tbellenger/button-lamp/light mount/README.md

# Light mount

Things that hold a light on the lamp's top deck. The box itself is in [`../container/`](../container/).

| Path | What |
|---|---|
| [original-cage/](original-cage/) | The older one-piece 13 mm tube cage (one print) |
| [spiral_tube_mount/](spiral_tube_mount/) | Stackable cross mount for the silicone tube |
| [four_tower_spiral/](four_tower_spiral/) | Four side-printed towers, a ring, and a cap. Identical numbered slots, glued after a dry fit. A separate option, not a replacement |
| [matrix_16x16_mount/](matrix_16x16_mount/) | 16×16 matrix on the same bolt pattern |
| [matrix_16x16_arduino_back/](matrix_16x16_arduino_back/) | That matrix with a rear Arduino bay |
