tbellenger/button-lamp/container/README.md

# Container

The lamp box: plywood and sheet metal. Light mounts that bolt to the top deck live in [`../light mount/`](../light%20mount/).

| Path | What |
|---|---|
| [plywood/](plywood/) | Hand-cut ply box, plus the generator for the original cage and the top backer plate |
| [plywood/fingerjoint/](plywood/fingerjoint/) | Laser-cut finger-joint birch |
| [sheetmetal/](sheetmetal/) | Bent aluminium or steel hood |
