tbellenger/button-lamp/container/plywood/templates/ply3mm/templates_letter_tiled_ply3mm.pdf

# Spiral Lamp plywood base - full-size templates (3mm ply)

Print at 100% / "Actual size" (turn OFF "fit to page"). Check the 100 mm and 4 in bars on every page.
Each piece is tiled across Letter pages with a 10 mm overlap. Line up the grey crosshairs, tape, then spray-glue or tape the template onto the plywood and cut on the black lines. Blue dashed lines are layout marks. HAND CUTTING (scroll saw / jigsaw): saw on the waste side of each black line and sand to it. Red crosshairs = drill holes (size printed). Hatched WASTE areas = inside cutouts: drill the 8 mm (5/16") red-circle entry holes, thread the scroll-saw blade (or drop the jigsaw blade in) and saw out. Slots: drill both ends, saw/file between. Page labels: PIECE row r / col c (row 1 = bottom of the piece).

## side: 250.0 x 120.0 mm, make 2 back: 204.0 x 117.0 mm, make 1 top: 122.0 x 204.0 mm, make 1 slope: 155.6 x 204.0 mm, make 1 front: 204.0 x 25.5 mm, make 1 bottom: 243.0 x 203.0 mm, make 1

100 mm
4 in

Print at 100%. Both bars must measure true.

## SIDE (make 2) row 1/1 col 1/2

Overlap 10 mm with neighbouring tiles. Align grey crosshairs (50 mm grid).

## SIDE (make 2) row 1/1 col 2/2

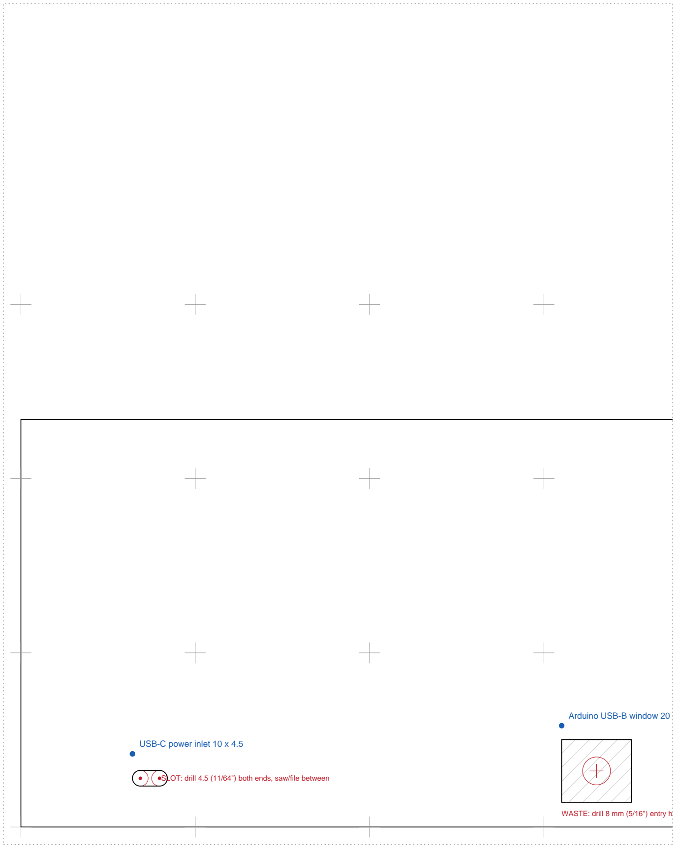
[picture p21: figure]
USB-C power inlet 10 x 4.5

SLOT: drill 4.5 (11/64") both ends, saw/file between

WASTE: drill 8 mm (5/16") entry hole, saw out

Arduino USB-B window 20 x 18 (hold the Uno up to check)

## BACK (make 1) row 1/1 col 1/2

WASTE: drill 8 mm (5/16") entry hole, saw out

Arduino USB-B window 20 x 18 (hold the Uno up to check)

## BACK (make 1) row 1/1 col 2/2

## TOP (make 1) row 1/1 col 1/1

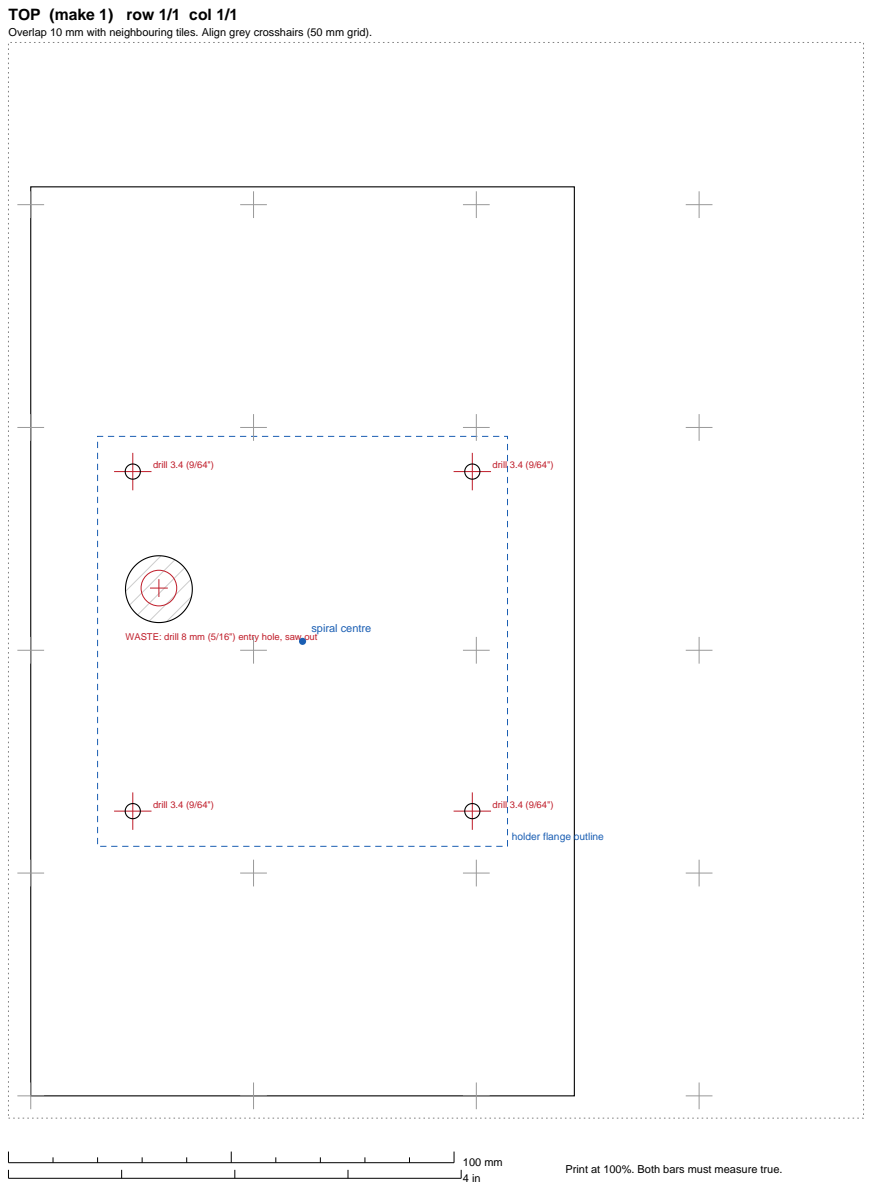
[picture p22: page 6]
drill 3.4 (9/64"); spiral centre

WASTE: drill 8 mm (5/16") entry hole, saw out

holder flange outline

## SLOPE (make 1) row 1/1 col 1/1

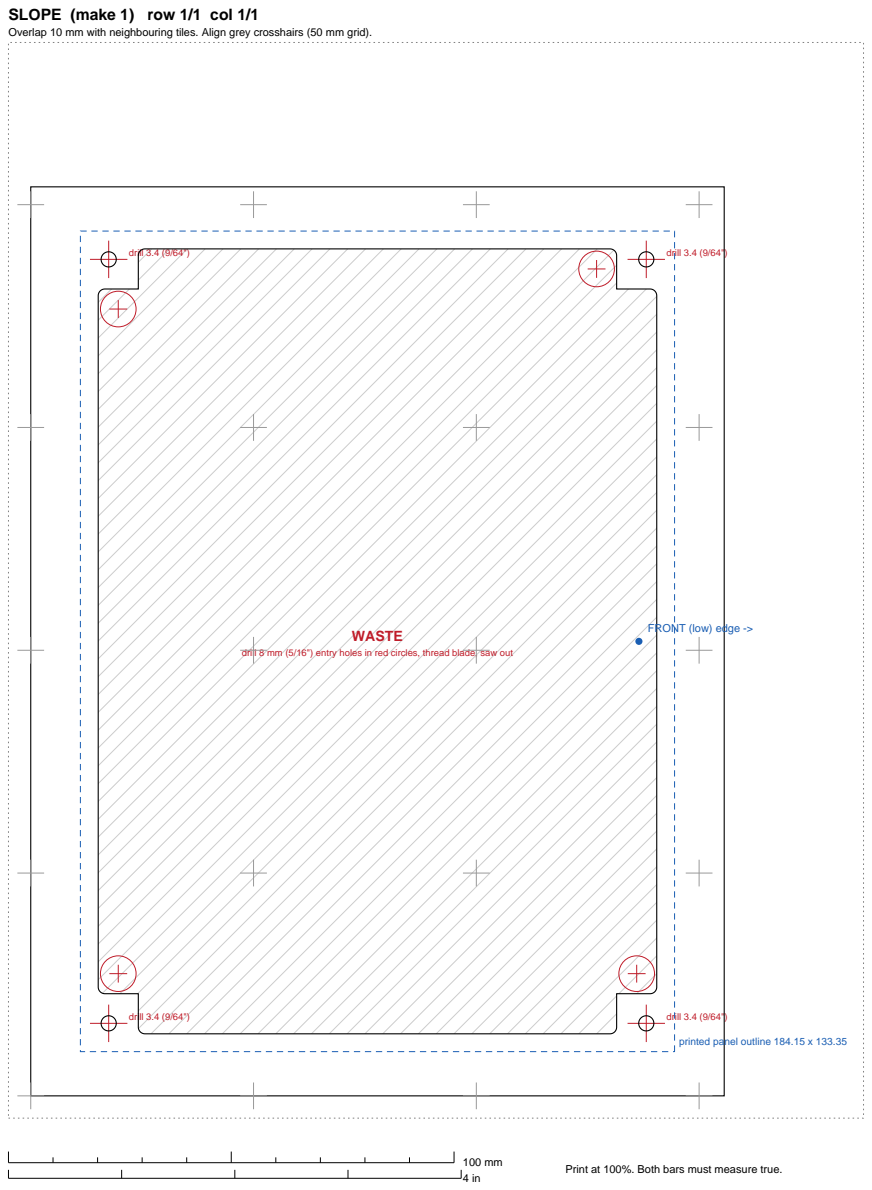
[picture p23: page 7]
WASTE; drill 3.4 (9/64")

FRONT (low) edge ->

drill 8 mm (5/16") entry holes in red circles, thread blade, saw out

printed panel outline 184.15 x 133.35

## FRONT (make 1) row 1/1 col 1/2

## FRONT (make 1) row 1/1 col 2/2

## BOTTOM (make 1) row 1/1 col 1/2

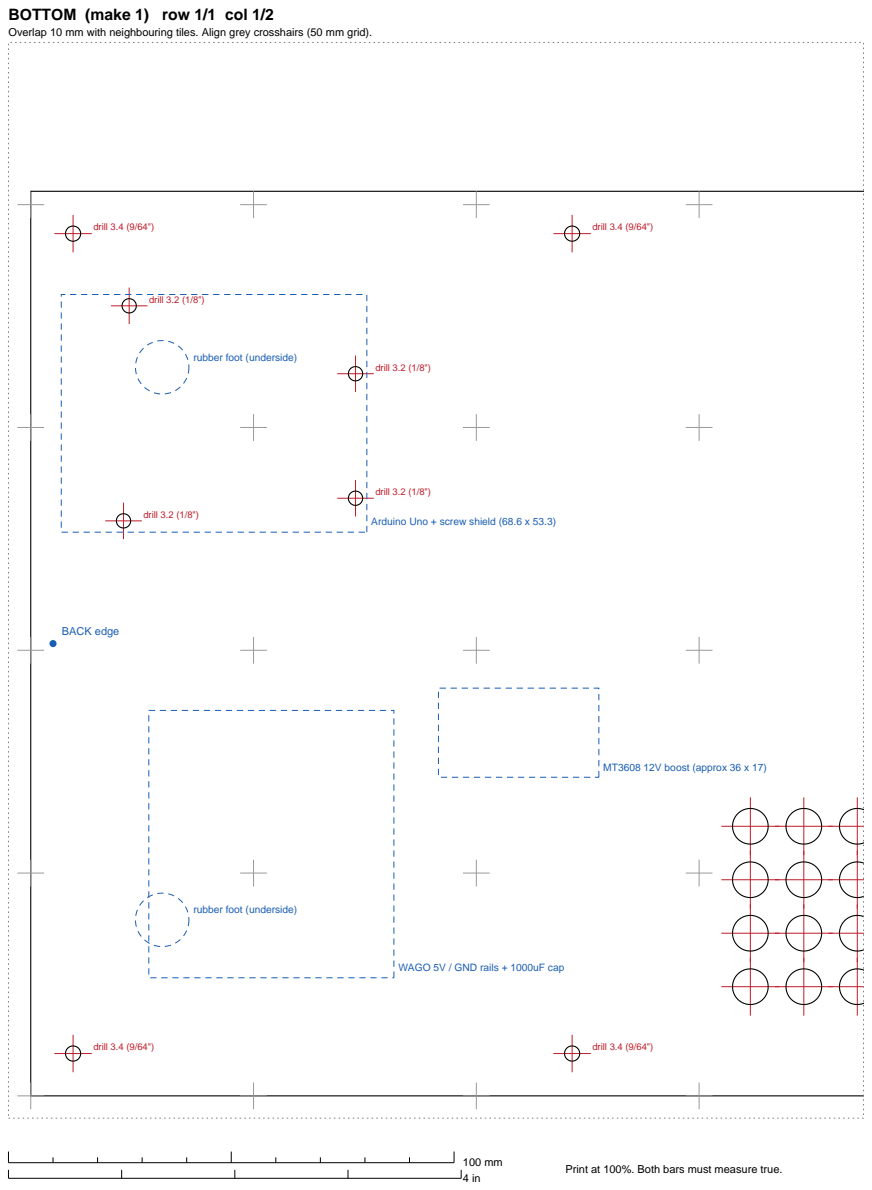
[picture p24: page 10]
drill 3.4 (9/64"); drill 3.2 (1/8"); MT3608 12V boost (approx 36 x 17); BACK edge

rubber foot (underside)

Arduino Uno + screw shield (68.6 x 53.3)

WAGO 5V / GND rails + 1000uF cap

## BOTTOM (make 1) row 1/1 col 2/2

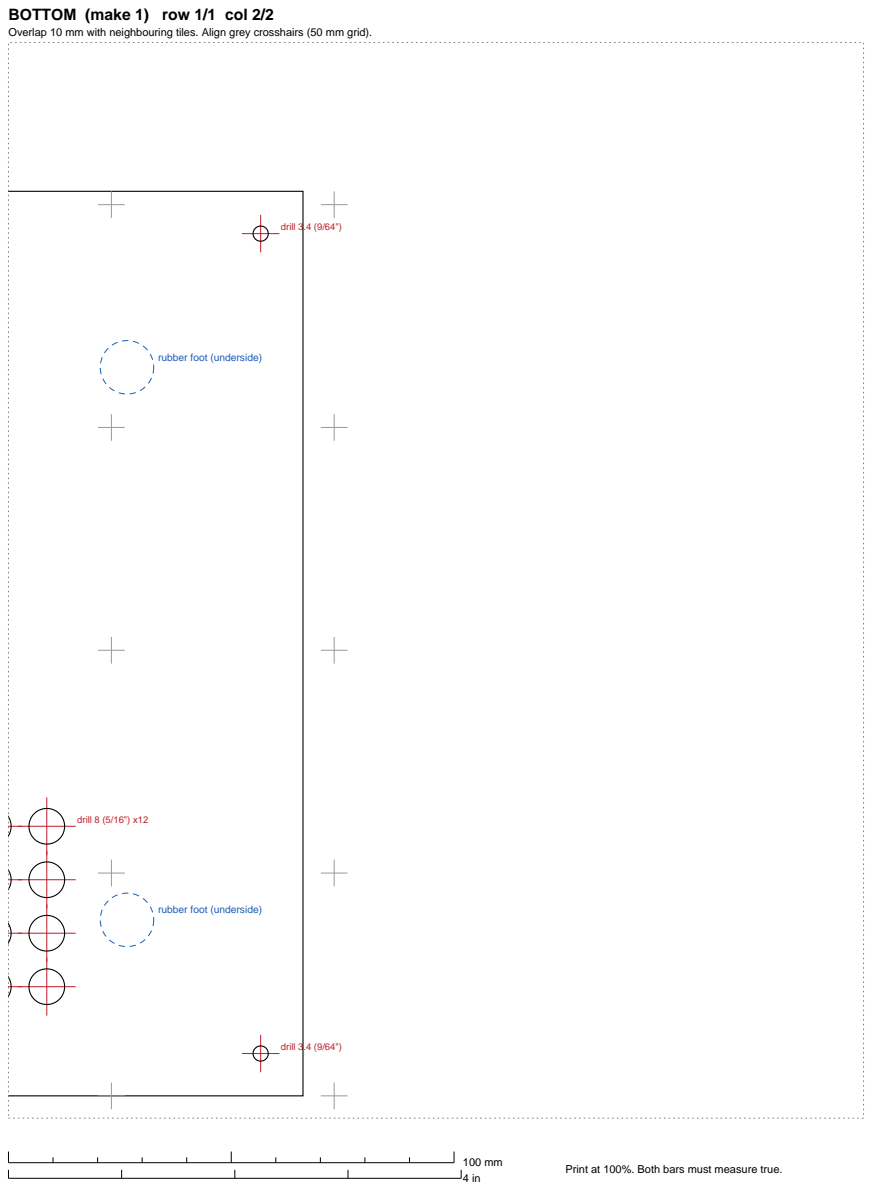
[picture p25: page 11]
drill 8 (5/16") x12; drill 3.4 (9/64"); MT3608 12V boost (approx 36 x 17)

rubber foot (underside)
