tbellenger/button-lamp/container/plywood/fingerjoint/render/exploded.png

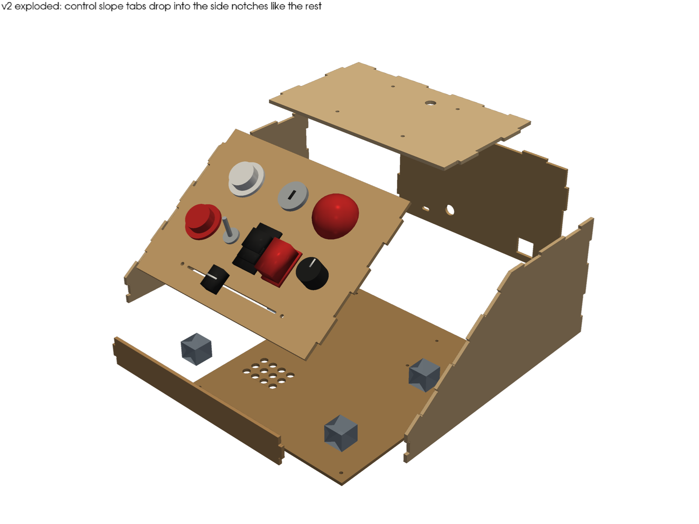
container/plywood/fingerjoint/render/exploded.png
