tbellenger/button-lamp/container/plywood/fingerjoint/render/panel_closeup.png

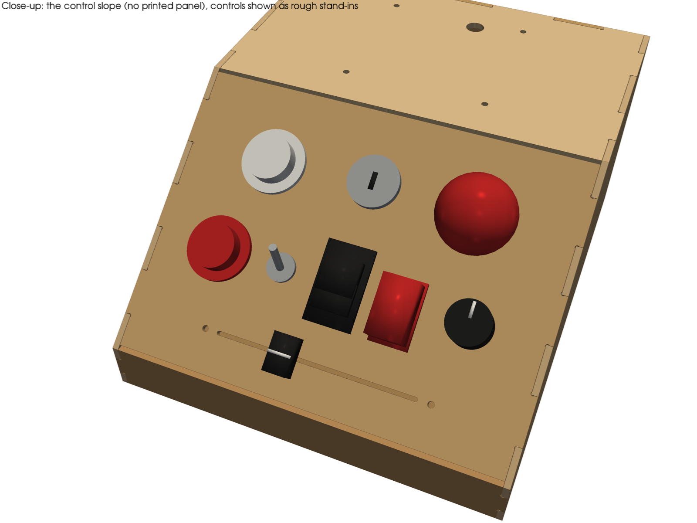
container/plywood/fingerjoint/render/panel_closeup.png
