tbellenger/button-lamp/container/plywood/render/inside_cutaway.png

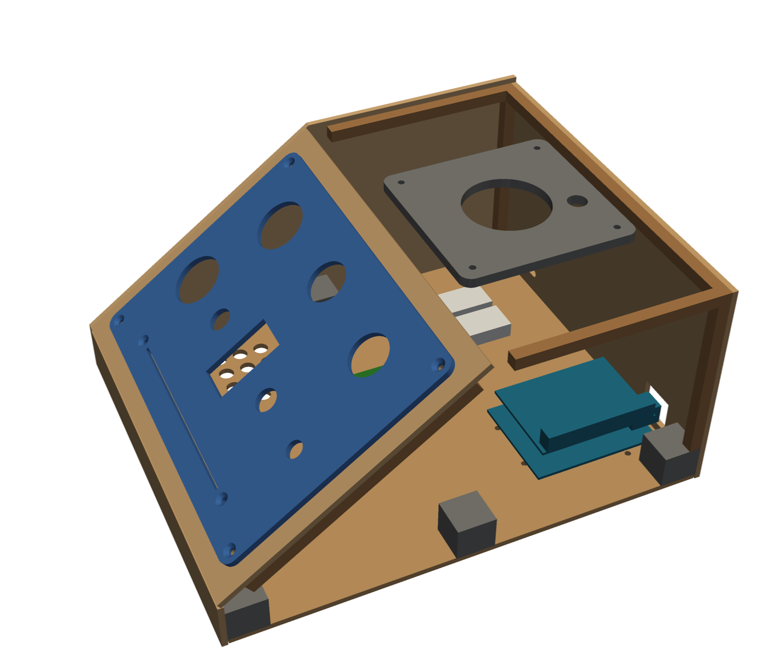
container/plywood/render/inside_cutaway.png
