tbellenger/button-lamp/container/plywood/render/original_Enclosure.png

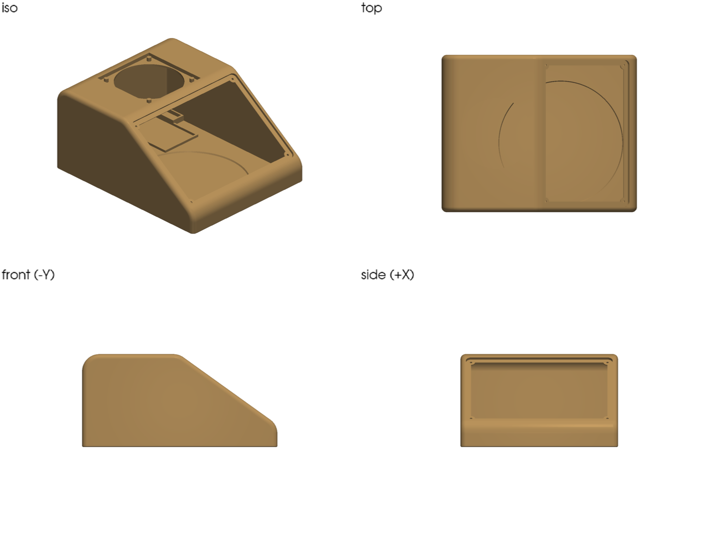
container/plywood/render/original_Enclosure.png
