tbellenger/button-lamp/container/plywood/render/original_Spiral_End_Cap.png

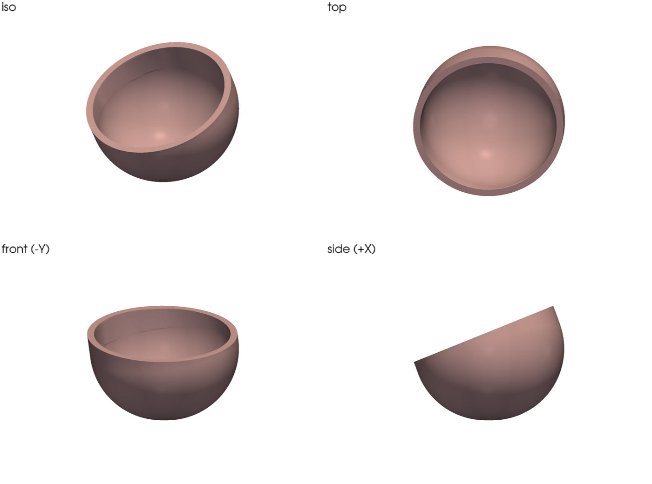
container/plywood/render/original_Spiral_End_Cap.png
