tbellenger/button-lamp/container/plywood/render/original_Spiral_with_base.png

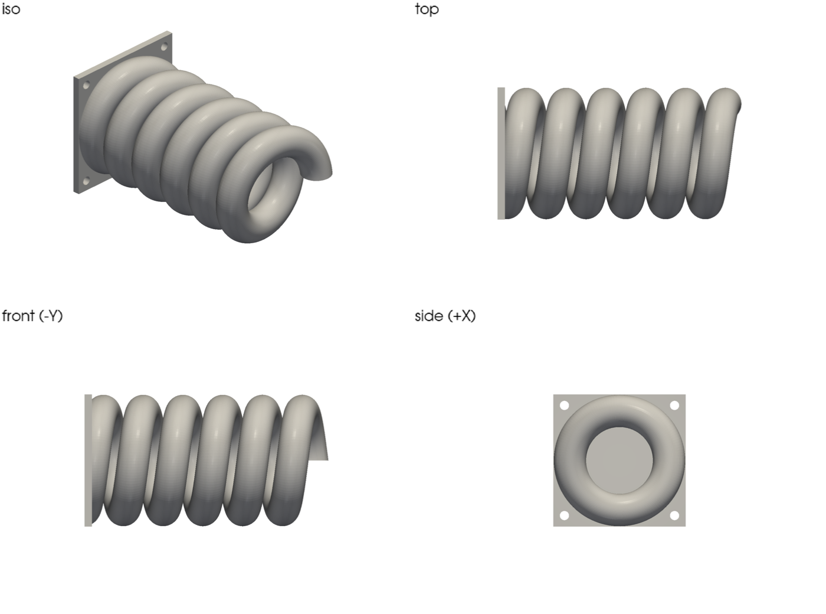
container/plywood/render/original_Spiral_with_base.png
