tbellenger/button-lamp/container/plywood/render/original_Switch_Panel.png

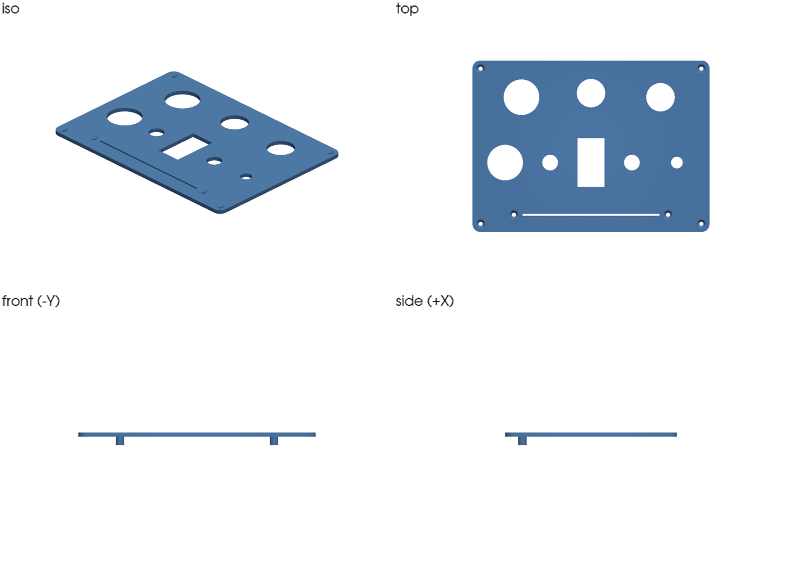
container/plywood/render/original_Switch_Panel.png
