tbellenger/button-lamp/container/plywood/render/original_vs_plywood_side.png

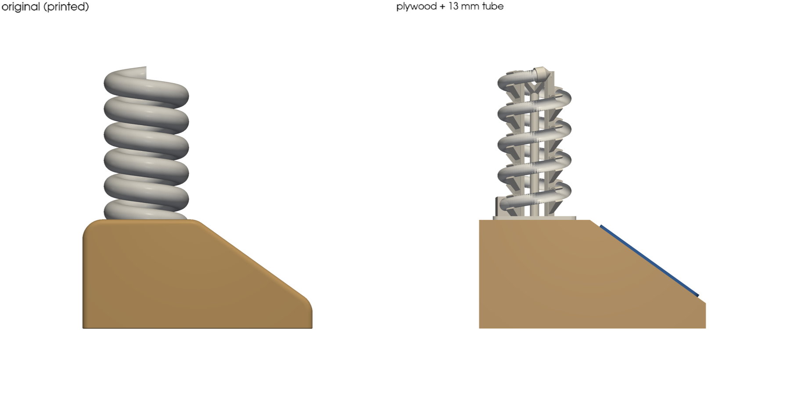
container/plywood/render/original_vs_plywood_side.png
