tbellenger/button-lamp/container/sheetmetal/render/al063_back_iso.png

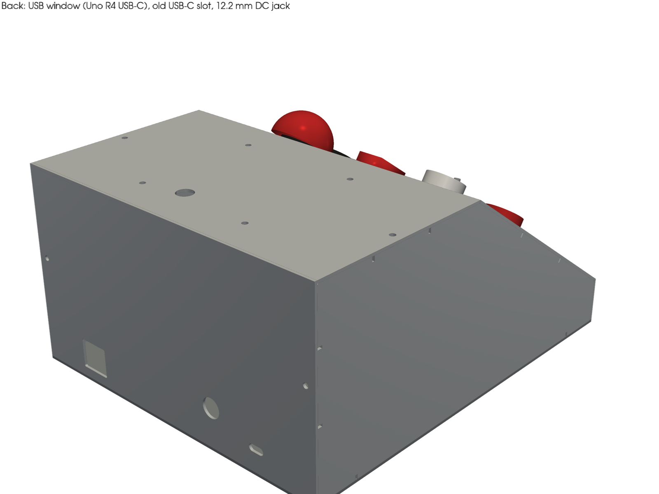
container/sheetmetal/render/al063_back_iso.png
