tbellenger/button-lamp/light mount/four_tower_spiral/render/clip_closeup.png

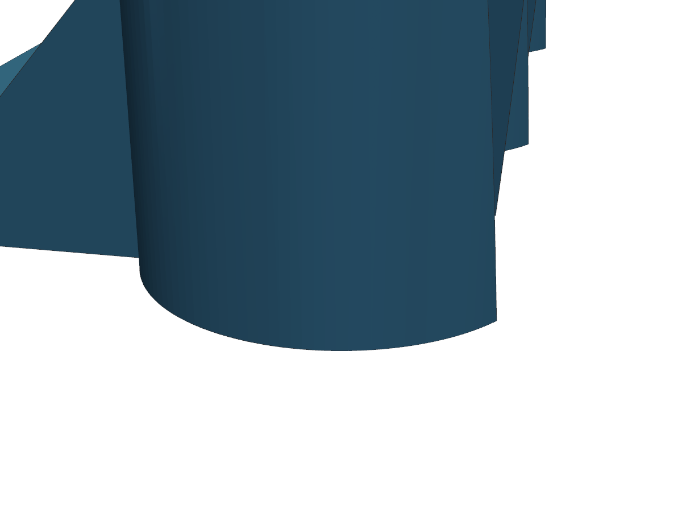
light mount/four_tower_spiral/render/clip_closeup.png
