tbellenger/button-lamp/light mount/four_tower_spiral/render/exploded.png

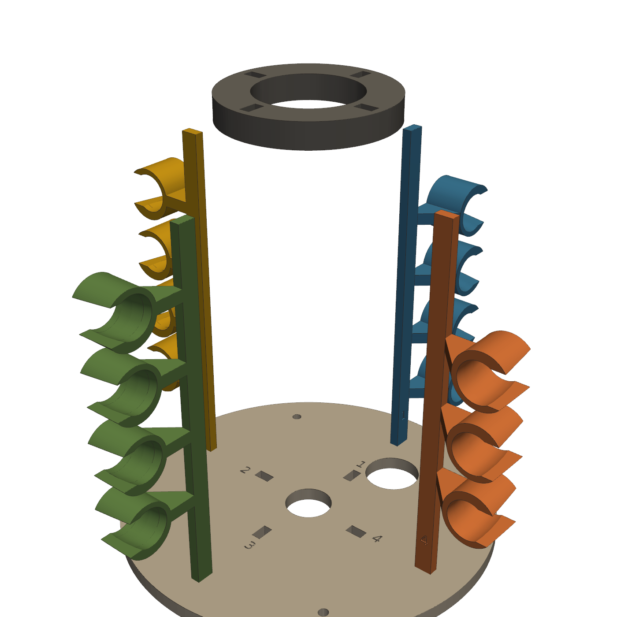
light mount/four_tower_spiral/render/exploded.png
