tbellenger/button-lamp/light mount/four_tower_spiral/render/four_tower_arm_ramp_far_oblique.png

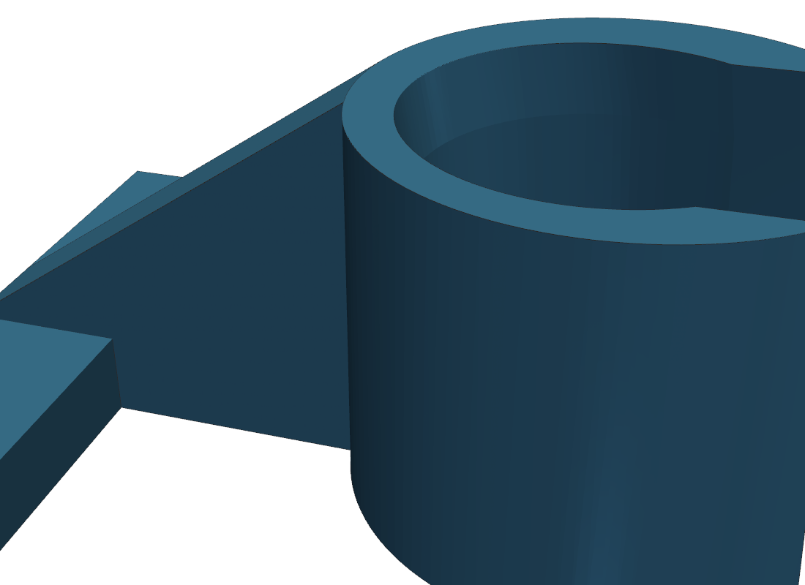
light mount/four_tower_spiral/render/four_tower_arm_ramp_far_oblique.png
