tbellenger/button-lamp/light mount/four_tower_spiral/render/four_tower_front.png

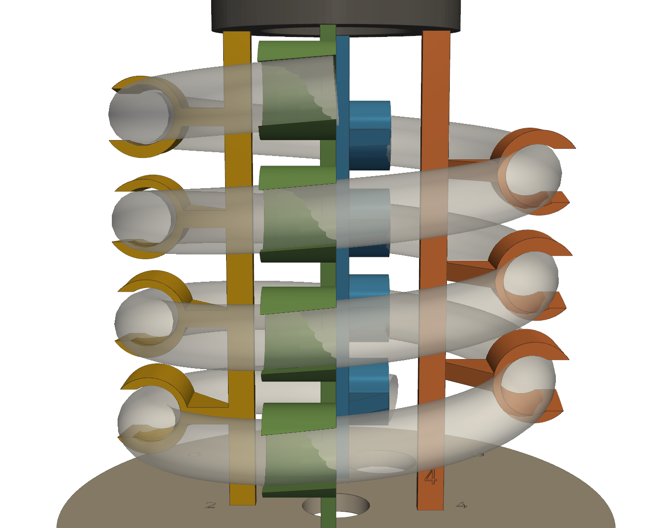
light mount/four_tower_spiral/render/four_tower_front.png
