tbellenger/button-lamp/light mount/four_tower_spiral/render/four_tower_side.png

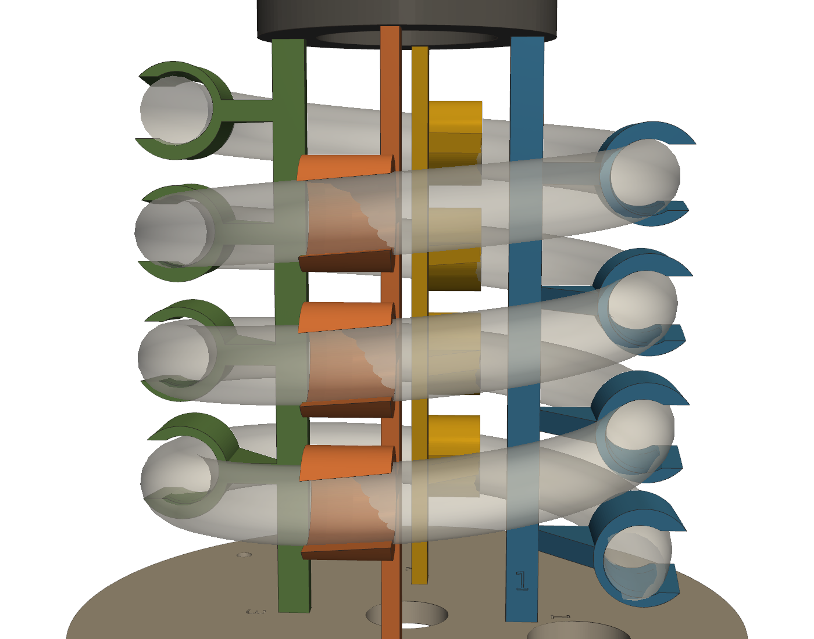
light mount/four_tower_spiral/render/four_tower_side.png
