tbellenger/button-lamp/light mount/original-cage/spiral_holder_13mm.png

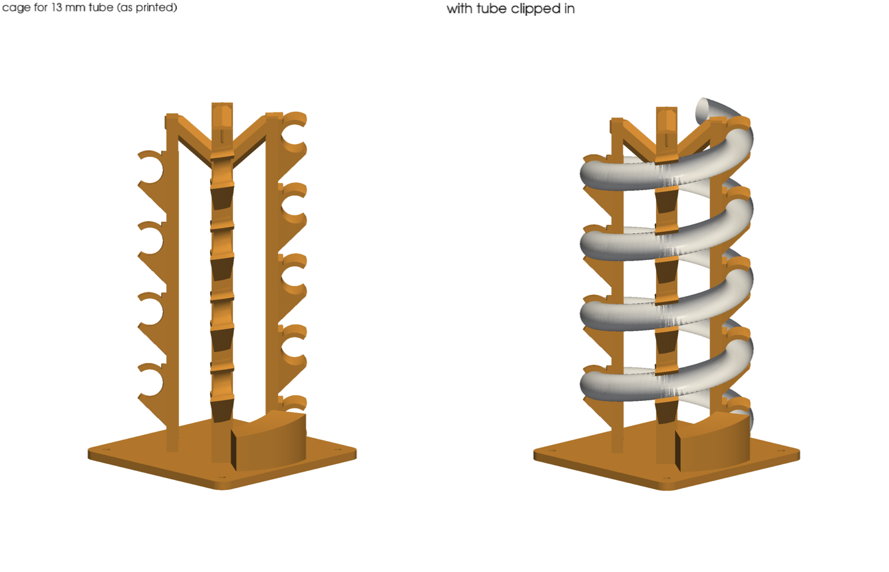
light mount/original-cage/spiral_holder_13mm.png
