tbellenger/button-lamp/light mount/spiral_tube_mount/render/lap_and_pin.png

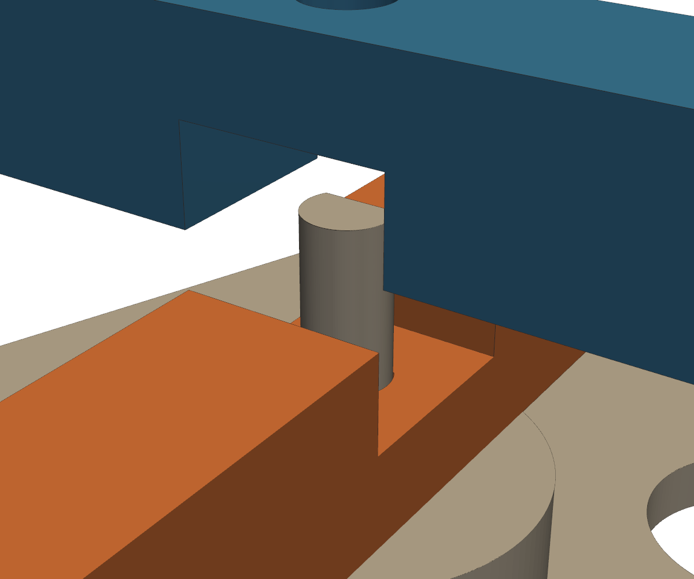
light mount/spiral_tube_mount/render/lap_and_pin.png
