tbellenger/button-lamp/light mount/matrix_16x16_arduino_back/parts/matrix_16x16_arduino_cover.md

# matrix_16x16_arduino_cover

<!-- AUTO: regenerated by `nurb card`. Do not hand-edit. -->
Size: 102.58 x 86.30 x 5.60 mm, 27445.5 mm3, 1 solid, 100 faces
Slivers: 5 under 1.0mm2, smallest 0.339mm2, 0 accepted
Checks: 1 finding: 1 warn (sliver)
<!-- /AUTO -->

## What it is

Removable back cover for the Arduino bay. A lip locates it in the shell and four M3 screws hold it. The shield covers the R4's 12×8 matrix, so the plate has no window there.

## Design notes

- Prints plate-down, lip up. The lip is 0.3 mm per side smaller than the shell cavity.
- The lip is notched at the 5 V entry and the button-wire exit, both of which are open at the shell rim. USB-C and the barrel jack are holes below the rim, so the lip stays whole on that wall. The plate still caps the shell.
- Cover screws are M3×8 into the shell bosses. On this plate they are at `(-34, 69.1)`, `(10, 69.1)`, `(-14, 4.3)` and `(40, 4.3)`, which is where those bosses sit once the shell is turned over. Heads sit on the outside face. The 5 V notch and the button notch are shifted the same way.

## Don't

- Don't grow the lip past 3 mm. The cover-screw bosses stop 3.2 mm short of the rim to clear it.
- Don't tighten `fit_clearance` below 0.3 mm. That is the moving fit, and a snugger lip binds on the next printer.
- Don't put the cover screws back over the board. An 8.5 mm boss through the shield will not assemble.

## Changelog

- 2026-11-01: initial cover with matrix window and port notches.
- 2026-11-01: dropped the matrix window (the shield covers those LEDs), moved the screws off the board, and notched the lip for the button-wire exit.
- 2026-11-10: holes and lip notches moved so the cover seats on the shell after the shell is turned over.
