tbellenger/button-lamp/light mount/matrix_16x16_arduino_back/parts/matrix_16x16_arduino_housing.md

# matrix_16x16_arduino_housing

<!-- AUTO: regenerated by `nurb card`. Do not hand-edit. -->
Size: 171.00 x 171.00 x 22.20 mm, 122709.3 mm3, 1 solid, 150 faces
Checks: clean
<!-- /AUTO -->

## What it is

Front bezel and backplate for the 160 mm WS2812B matrix, with the same baffle track, diffuser slot and four base-mount screws as `matrix_16x16_housing`, plus four more M3 holes that bolt on the Arduino shell.

## Design notes

- The stepped pocket, 45 degree corbels, open top mouth and six anti-warp windows are copied from the original housing so the same 162.4 mm baffle and 162 mm diffuser slide in.
- Two strips of the upper side windows are filled back in where the shell's left and right walls land, so the bay perimeter has plastic to sit on.
- Shell screws are at `(-30, 43.5)`, `(-30, 23.5)`, `(30, 43.5)` and `(30, 13.5)`, on the same X = ±30 ribs. That is where the shell's screws land after it is turned over. Heads are recessed like the base-mount screws.

## Don't

- Don't close the top mouth above the PCB pocket. That is how the baffle and the diffuser slide in.
- Don't move the four base-mount holes off `(+/-30, -60)` and `(+/-30, -30)`. Both the original base mount and the desk stand use them.
- Don't chamfer the bed face or the sliding tracks.

## Changelog

- 2026-11-01: Arduino-back variant. Front stack unchanged; shell screw holes and wall lands added.
- 2026-11-10: shell screw holes moved to where the shell lands after it is turned over.
