tbellenger/button-lamp/light mount/four_tower_spiral/parts/tower_0.md

# tower_0

<!-- AUTO: regenerated by `nurb card`. Do not hand-edit. -->
Size: 32.00 x 122.10 x 14.00 mm, 7291.8 mm3, 1 solid, 79 faces
Slivers: 13 under 1.0mm2, smallest 0.246mm2, 0 accepted
Checks: 11 findings: 11 warn (bed_bevel, min_wall, sliver)
<!-- /AUTO -->

## What it is

The tower at 0°, the right side, +X. Recessed 4. Three clips on a 1 m strip. Not the start of the coil.

## Design notes

- Print it on its side. The clip C is the layer plane, which is the orientation that held together. Upright clips broke across the layers.
- The foot is the 6.0 × 3.2 mm rib, 4.5 mm long, the same tab as the other three towers. It drops into a 6.2 × 3.4 mm slot.
- The 4 is recessed 0.6 mm into the top face of the rib, just above the ring. Match it to the 4 on the ring.
- The spoke is still 4 mm along the tower. In print-up its top falls from 14 mm at the clip to 3.2 mm at the far face of the rib.

```toml
[part]
min_wall = 1.0
```

## Don't

- Don't print this standing up. That puts the layer lines along the tube.
- Don't put it on slot 1, 2, or 3. The tab will fit, and the clips will be on the wrong heights. The number is the only key.

## Changelog

- 2026-11-08: first 0° tower.
- 2026-11-08: diamond foot and lug replaced by the shared slot. Recessed 4.
- 2026-11-08: spoke top slopes from the clip height down to the rib in the print-up direction.
