tbellenger/button-lamp/light mount/four_tower_spiral/parts/tower_270.md

# tower_270

<!-- AUTO: regenerated by `nurb card`. Do not hand-edit. -->
Size: 32.00 x 122.10 x 14.00 mm, 8941.8 mm3, 1 solid, 112 faces
Slivers: 33 under 1.0mm2, smallest 0.243mm2, 0 accepted
Checks: 14 findings: 14 warn (bed_bevel, min_wall, sliver)
<!-- /AUTO -->

## What it is

The tower at 270°, the front. Recessed 3. Four clips on a 1 m strip, including the highest.

## Design notes

- Print it on its side.
- The foot is the same 6.0 × 3.2 mm tab as the other towers. The 3 is recessed into the top face of the rib.
- The spoke is still 4 mm along the tower. In print-up its top falls from 14 mm at the clip to 3.2 mm at the far face of the rib.

```toml
[part]
min_wall = 1.0
```

## Don't

- Don't print it standing up.
- Don't leave the cap off. This tower's top is what the cap is there to hold at the radius.

## Changelog

- 2026-11-08: first 270° tower.
- 2026-11-08: notches and lug replaced by a recessed 3.
- 2026-11-08: spoke top slopes from the clip height down to the rib in the print-up direction.
