tbellenger/button-lamp/light mount/four_tower_spiral/parts/tower_90.md

# tower_90

<!-- AUTO: regenerated by `nurb card`. Do not hand-edit. -->
Size: 32.00 x 122.10 x 14.00 mm, 8942.2 mm3, 1 solid, 94 faces
Slivers: 12 under 1.0mm2, smallest 0.249mm2, 0 accepted
Checks: 14 findings: 14 warn (bed_bevel, min_wall, sliver)
<!-- /AUTO -->

## What it is

The tower at 90°, the back, +Y. Recessed 1. This one carries the lowest clip. Start the tube here.

## Design notes

- The running rib is 6.0 mm radial by 3.2 mm tangential. The clips are local. Raise `rib_radial` first if it flexes.
- Print it on its side, same reason as the other towers: the snap arms stay in the layers.
- The cable hole is about 20° before this tower. The helix climbs counterclockwise from that hole into the lowest clip.
- The 1 is recessed 0.6 mm into the top face of the rib. The foot is the same tab as the other towers.
- The spoke is still 4 mm along the tower. In print-up its top falls from 14 mm at the clip to 3.2 mm at the far face of the rib, across the whole 6 mm, with the underside on the bed.

```toml
[part]
min_wall = 1.0
```

## Don't

- Don't start the coil on a different tower. The other three are a quarter turn higher, each in turn.
- Don't print it standing up.

## Changelog

- 2026-11-08: first 90° tower. Lowest clip.
- 2026-11-08: notches and lug replaced by a recessed 1. Same slot as the others.
- 2026-11-08: spoke top slopes from the clip height down to the far face of the rib.
