tbellenger/button-lamp/light mount/four_tower_spiral/parts/tower_coupon.md

# tower_coupon

<!-- AUTO: regenerated by `nurb card`. Do not hand-edit. -->
Size: 59.00 x 35.60 x 14.00 mm, 2767.0 mm3, 1 solid, 51 faces
Slivers: 9 under 1.0mm2, smallest 0.249mm2, 0 accepted
Checks: 5 findings: 5 warn (bed_bevel, min_wall, sliver)
<!-- /AUTO -->

## What it is

A short rib, one clip, and a slot gauge, joined by a link. The digit is 1, same as the start tower.

## Design notes

- Print it on its side, like a tower. The gauge is two cheeks and a back wall. The gap is 6.2 mm wide and the cheeks are 3.4 mm tall, open on top, so there is no ceiling.
- Snap the link off and set the tab into the gauge. The 0.2 mm allowance is a design choice. If it binds, raise `joint_clear` before printing the towers.
- The spoke on the coupon has the same print-up slope, 14 mm at the clip down to 3.2 mm at the far face of the rib.

```toml
[part]
min_wall = 1.0
```

## Don't

- Don't treat a coupon that fits as proof the cap and the coil are stiff. It only checks the slot and one clip.

## Changelog

- 2026-11-08: first coupon.
- 2026-11-08: diamond gauge replaced by the slot the ring uses.
- 2026-11-08: spoke top slopes from the clip height down to the rib.
