tbellenger/button-lamp/light mount/four_tower_spiral/parts/tower_base.md

# tower_base

<!-- AUTO: regenerated by `nurb card`. Do not hand-edit. -->
Size: 128.00 x 128.00 x 4.50 mm, 55174.3 mm3, 1 solid, 105 faces
Slivers: 66 under 1.0mm2, smallest 0.227mm2, 0 accepted
Checks: 2 findings: 2 warn (min_wall, sliver)
<!-- /AUTO -->

## What it is

The mounting ring. Four M3 holes on the deck's 76.2 mm square, a Ø19 window on the light-cable hole, and four identical slots.

## Design notes

- Each slot is 6.2 × 3.4 mm, the 6.0 × 3.2 mm rib plus 0.2 mm. That 0.2 mm is `joint_clear`, a design allowance, not a measured fit. The slot goes through the 4.5 mm ring.
- A recessed digit sits just outboard of each slot. 1 is at the back, then 2, 3, and 4 counterclockwise. The matching tower carries the same digit.
- The window is Ø19 at (+11.71, +32.24). The deck hole under it is Ø15. Slot 1 clears that window.

```toml
[part]
min_wall = 1.2
```

## Don't

- Don't fill the middle of the ring. The cable window has to stay open.
- Don't add a pin in the slot. The rib is the whole joint, and Tom glues it after the dry fit.
- Don't drill this for the original spiral's Ø6.35 mm screws. This deck is M3.

## Changelog

- 2026-11-08: first ring for the four-tower variant.
- 2026-11-08: diamond pins and lug pockets replaced by four identical slots and recessed 1–4.
