tbellenger/button-lamp/light mount/four_tower_spiral/parts/tower_cap.md

# tower_cap

<!-- AUTO: regenerated by `nurb card`. Do not hand-edit. -->
Size: 54.80 x 54.80 x 8.00 mm, 11268.5 mm3, 1 solid, 20 faces
Checks: clean
<!-- /AUTO -->

## What it is

A ring that drops onto the four tenons and holds the towers on their circle. It sits inside the coil.

## Design notes

- The hoop is only wide enough for the 6 mm rib plus a 2.4 mm wall each side. Each pocket is 6.2 × 3.4 mm, the rib plus the same 0.2 mm used on the ring. Not measured. There is no pin in the pocket.
- Outer radius stays inside the tube. The clips are below the cap and still open from the outside.

```toml
[part]
min_wall = 1.2
```

## Don't

- Don't make the cap reach the tube. The tube has to snap in after the cap is on, and the cap has to drop on after the tube is in.

## Changelog

- 2026-11-08: first cap.
- 2026-11-08: pockets stay the rib section. Same clearance as the ring slots.
