tbellenger/button-lamp/light mount/spiral_tube_mount/parts/spiral_base.md

# spiral_base

<!-- AUTO: regenerated by `nurb card`. Do not hand-edit. -->
Size: 100.00 x 100.00 x 35.50 mm, 51678.4 mm3, 1 solid, 16 faces
Checks: clean
<!-- /AUTO -->

## What it is

Square plate that bolts to the Button Lamp top deck and carries the first pin of the stack. The low cross of the first level sits on the centre boss.

## Design notes

- Four Ø3.4 mm holes on the existing 76.2 mm square. The original purchased spiral used Ø6.35 mm on that same square for a different enclosure. This deck is M3.
- The light-cable window is Ø19 at (+11.71, +32.24) mm. The deck hole it clears is Ø15, which is the Ø10 hole plus the 5 mm Tom asked for. The old mount window was Ø14, 4 mm larger than Ø10. The 4 mm is kept.
- The pin is Ø6 with a 1.5 mm flat aimed at the lowest clip. The hole in the cross is Ø6.2. That 0.2 mm is a design choice, not a measured fit.
- The plate is 100 mm square and 4.5 mm thick. The 100 mm coil fits the plywood top (122 mm front to back). It does not fit the old 92 mm cage flange square.

```toml
[part]
min_wall = 1.2
```

## Don't

- Don't move the window off (+11.71, +32.24). That is the deck hole.
- Don't shrink the window under Ø19. The deck hole is Ø15 and the mount has to stay the larger of the two.
- Don't drill this plate for the original spiral's Ø6.35 mm screws.

## Changelog

- 2026-11-08: plate, pin, and Ø19 window. Replaces the 80 mm ring with four fixed clips.
