tbellenger/button-lamp/light mount/spiral_tube_mount/parts/spiral_cap.md

# spiral_cap

<!-- AUTO: regenerated by `nurb card`. Do not hand-edit. -->
Size: 28.00 x 28.00 x 9.00 mm, 5318.4 mm3, 1 solid, 5 faces
Checks: clean
<!-- /AUTO -->

## What it is

The top clamp. Same disk as the spacer, no pin above it. It keeps the last high cross from lifting off the lap.

## Design notes

- The hole goes through, so there is no ceiling to bridge.
- The flat matches the pin. It can be printed either face down.

```toml
[part]
min_wall = 1.0
```

## Don't

- Don't leave the last level uncapped. The high cross is only trapped once this (or a spacer) is on the pin.

## Changelog

- 2026-11-08: first cap.
