tbellenger/button-lamp/light mount/spiral_tube_mount/parts/spiral_fit_coupon.md

# spiral_fit_coupon

<!-- AUTO: regenerated by `nurb card`. Do not hand-edit. -->
Size: 90.00 x 49.00 x 18.50 mm, 15583.8 mm3, 1 solid, 42 faces
Slivers: 2 under 1.0mm2, smallest 0.343mm2, 0 accepted
Checks: 1 finding: 1 warn (sliver)
<!-- /AUTO -->

## What it is

One solid to print before a level. Two short lap tongues, a pin, and a socket, joined by 2 mm tabs you snap off.

## Design notes

- The clearances match the real parts: 0.3 mm on the lap, 0.2 mm on the pin diameter, 0.15 mm on the flat.
- Nothing here has been fitted on a bench. If the pin is tight or the lap rocks, change those three numbers and reprint the coupon, not the whole stack.
- The tongues lie flat, the same way the crosses print. The pin and the socket stand up.

```toml
[part]
min_wall = 1.0
```

## Don't

- Don't treat a coupon that fits as proof the whole stack is stiff. It only checks the pin and the lap.

## Changelog

- 2026-11-08: first coupon.
