tbellenger/button-lamp/light mount/spiral_tube_mount/parts/spiral_spacer.md

# spiral_spacer

<!-- AUTO: regenerated by `nurb card`. Do not hand-edit. -->
Size: 28.00 x 28.00 x 27.50 mm, 5793.0 mm3, 1 solid, 11 faces
Checks: clean
<!-- /AUTO -->

## What it is

The piece between levels. A disk clamps the lap under it. A pin carries the next cross. Print it socket down.

## Design notes

- Seating face to seating face is one pitch, 23 mm. The web between the two hubs is 9 mm, because each hub is 14 mm of the 23.
- The socket is a Ø6.2 hole with the same flat as the pin, closed by a 45° cone so the ceiling is not a bridge. The cone stops at Ø1.2 inside the pin instead of a mathematical point, so the STL stays closed.
- The 0.2 mm pin clearance and the 0.15 mm flat clearance are design choices. Print the fit coupon before a stack of these.

```toml
[part]
min_wall = 0.8
```

## Don't

- Don't print the socket facing up. The cone is the roof only when the socket is on the bed.
- Don't lengthen the web without lengthening the pitch. The next level would leave the helix.

## Changelog

- 2026-11-08: first spacer.
