tbellenger/button-lamp/light mount/matrix_16x16_mount/parts/matrix_16x16_housing.md

# matrix_16x16_housing

<!-- AUTO: regenerated by `nurb card`. Do not hand-edit. -->
Size: 171.00 x 171.00 x 22.20 mm, 121508.0 mm3, 1 solid, 124 faces
Checks: clean
<!-- /AUTO -->

## What it is

Main 3D-printable bezel and backplate housing for the BTF-LIGHTING 16x16 WS2812B LED matrix (`160.0 x 160.0 mm`, `B01DC0IOCK`) and `162.0 x 162.0 mm` Akamino polycarbonate diffuser sheet. Prints flat on its back (`171.0 x 171.0 x 22.0 mm`) on the Creality CR-10 (`300 x 300 mm` bed) with zero supports.

## Design notes

- **Three-stage stepped internal pocket (100% support-free 45° transitions)**:
  1. **Lower PCB pocket (`Z = 4.2 .. 6.7 mm`, `161.0 x 161.0 mm`)**: Enclosed on all 4 sides (`0.5 mm` clearance per side around the `160.0 x 160.0 mm` flexible PCB) so the LED matrix sits flat and centered.
  2. **Middle baffle + diffuser track (`Z = 7.7 .. 18.7 mm`, `163.0 x 163.0 mm`)**: Reached via a `1.0 mm` 45° outward step (`Z = 6.7 .. 7.7 mm`) and open at the top (`+Y`) edge. First, `matrix_16x16_baffle_insert` (`162.4 x 162.4 x 8.5 mm`) slides down from the top slot to clamp the PCB flat (`Z = 7.7 .. 16.2 mm`). Second, 1 or 2 stacked sheets of `162.0 x 162.0 x 1.0 mm` polycarbonate diffuser slide down into the `2.5 mm` front track (`Z = 16.2 .. 18.7 mm`) right in front of the baffle.
  3. **Front retention bezel (`Z = 18.7 .. 22.0 mm`, `158.8 x 158.8 mm` clear aperture)**: Steps inward at exactly 45° (`2.1 mm` corbel over `2.1 mm` Z) so it prints cleanly without supports while overlapping the `162.0 x 162.0 mm` diffuser by `1.6 mm` and the `162.4 x 162.4 mm` baffle by `1.8 mm` on the left, right, and bottom edges.
- **Anti-warp windowed backplate (`Z = 0.0 .. 4.2 mm`)**: Six rounded-rectangle windows reduce first-layer area below `18,000 mm²` (preventing corner lift on the CR-10) and allow the BTF-LIGHTING rear 3-pin JST-SM data pigtails and 5V power injection wires to exit straight out the back between the upright mounting pillars.
- **Four recessed M3 mounting holes (`X = +/-30.0 mm`, `Y = -60.0, -30.0 mm`)**: Placed on pixel grid intersections (between 5050 LEDs) with upward-facing `Ø6.0 mm` socket-head recesses (`Z = 2.0 .. 4.2 mm`) so M3 screw heads sit flush below the PCB floor.

## Don't

- Don't close the top (`+Y`) bezel rim above `Z = 6.7 mm` — that mouth is how both the rigid `16x16` pixel baffle and the `162 x 162 mm` polycarbonate diffuser sheet slide into their captive tracks.
- Don't make the backplate a solid slab — over `20,000 mm²` of unbroken first layer warps at the corners on an open-frame bed, and blocks the rear soldered JST pigtails on the flexible PCB.
- Don't chamfer the internal sliding tracks or the bed face (`Z = 0`).

## Changelog

- 2026-10-25: initial support-free 16x16 matrix housing with stepped 45° corbel bezel and windowed backplate.
