tbellenger/button-lamp/container/plywood/fingerjoint/render/flat_parts.png

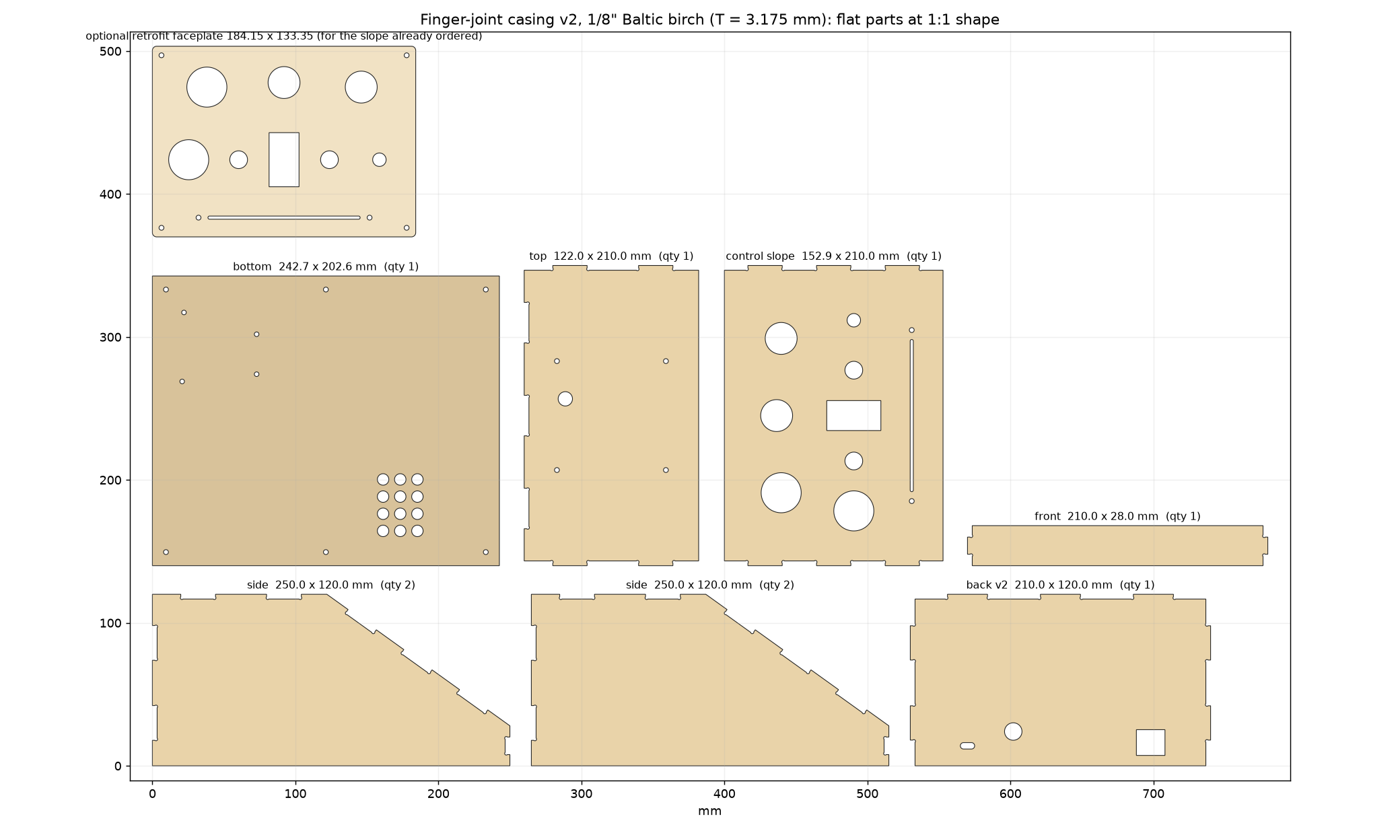
container/plywood/fingerjoint/render/flat_parts.png
