tbellenger/button-lamp/container/plywood/fingerjoint/dxf/as_ordered_S7872337/fj125_side_qty2_mm.dxf

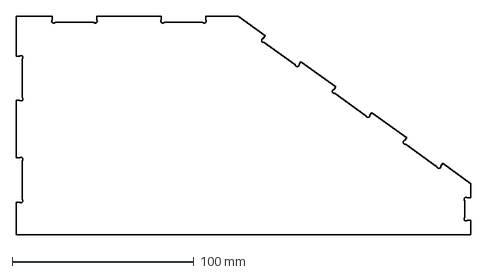
[picture p50: CAD file, 2026-10-21]
container/plywood/fingerjoint/dxf/as_ordered_S7872337/fj125_side_qty2_mm.dxf
250.0 x 120.0 mm
