tbellenger/button-lamp/container/plywood/fingerjoint/dxf/fj125_top_qty1_mm.dxf

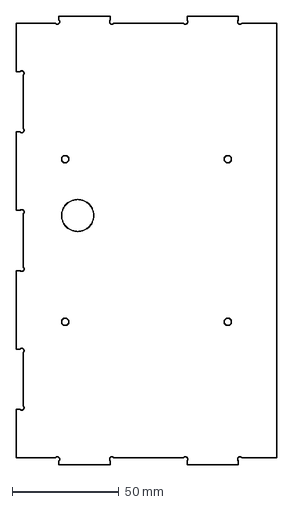
[picture p51: CAD file, 2026-11-08]
container/plywood/fingerjoint/dxf/fj125_top_qty1_mm.dxf
122.0 x 210.0 mm
