tbellenger/button-lamp/container/plywood/fingerjoint/dxf/retrofit/fj125_faceplate_qty1_mm.dxf

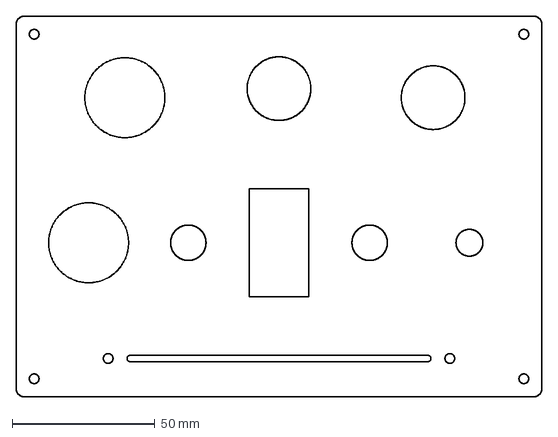
[picture p52: CAD file, 2026-10-21]
container/plywood/fingerjoint/dxf/retrofit/fj125_faceplate_qty1_mm.dxf
184.2 x 133.3 mm
