tbellenger/button-lamp/container/plywood/stl/top_backer_plate.stl

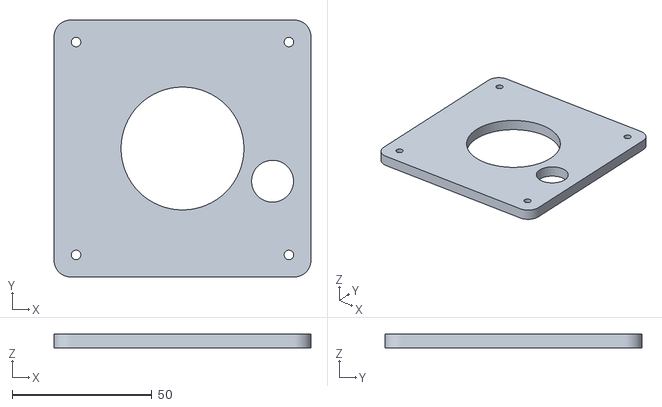
[picture p53: CAD file, 2026-11-08]
container/plywood/stl/top_backer_plate.stl
92.0 x 92.0 x 5.00
