tbellenger/button-lamp/container/sheetmetal/dxf/sm_al063_hood_qty1_mm.dxf

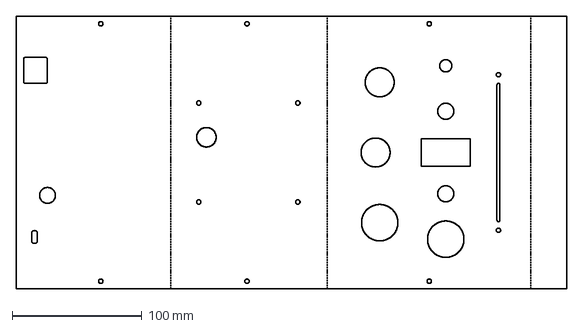
[picture p54: CAD file, 2026-11-08]
container/sheetmetal/dxf/sm_al063_hood_qty1_mm.dxf
423.4 x 210.0 mm
