tbellenger/button-lamp/light mount/four_tower_spiral/3mf/tower_coupon.3mf

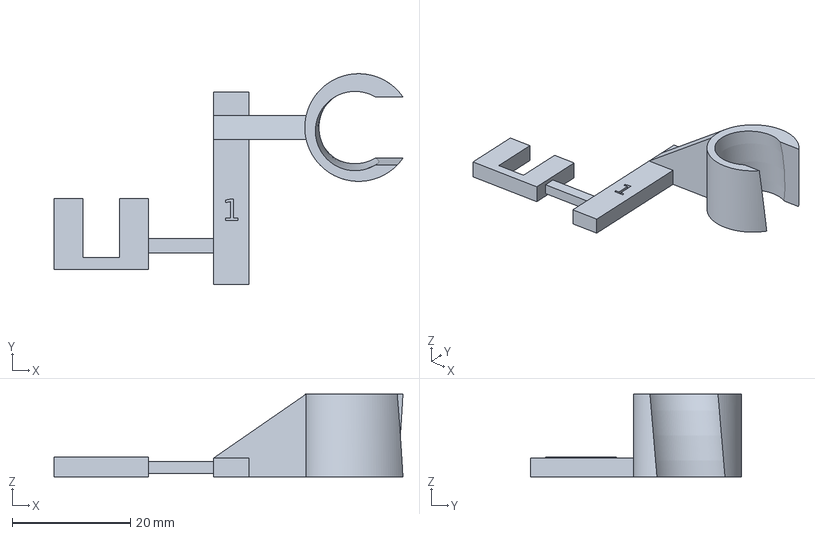
[picture p55: CAD file, 2026-11-08]
light mount/four_tower_spiral/3mf/tower_coupon.3mf
59.0 x 35.6 x 14.0 mm
