tbellenger/button-lamp/light mount/matrix_16x16_arduino_back/3mf/matrix_16x16_arduino_cover.3mf

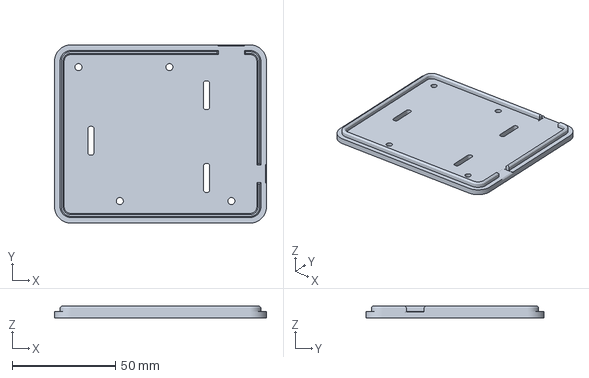
[picture p56: CAD file, 2026-11-11]
light mount/matrix_16x16_arduino_back/3mf/matrix_16x16_arduino_cover.3mf
102.6 x 86.3 x 5.60 mm
