tbellenger/button-lamp/light mount/matrix_16x16_mount/3mf/matrix_16x16_base_mount.3mf

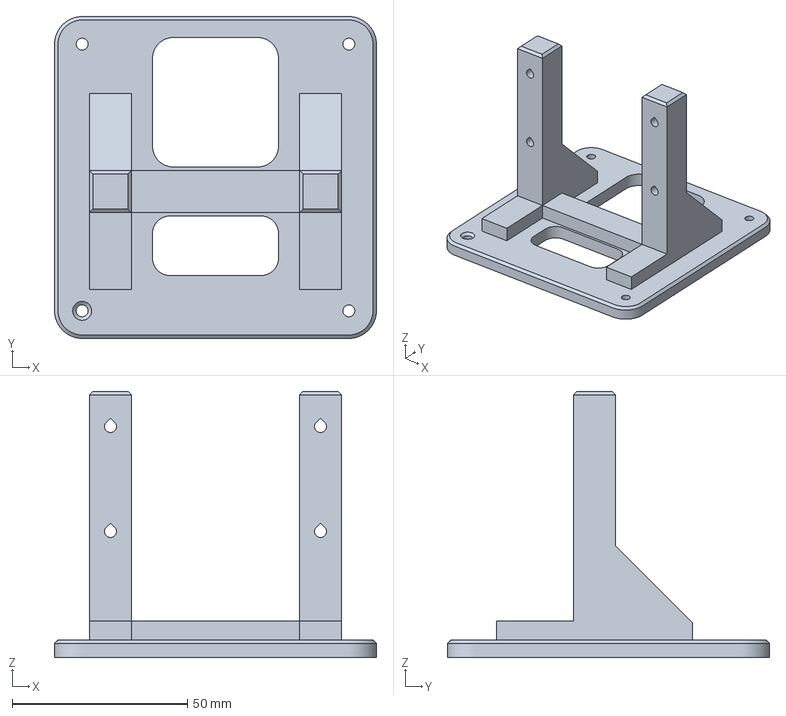
[picture p57: CAD file, 2026-10-25]
light mount/matrix_16x16_mount/3mf/matrix_16x16_base_mount.3mf
92.0 x 92.0 x 76.0 mm
