tbellenger/button-lamp/light mount/original-cage/spiral_cage_tube13mm.stl

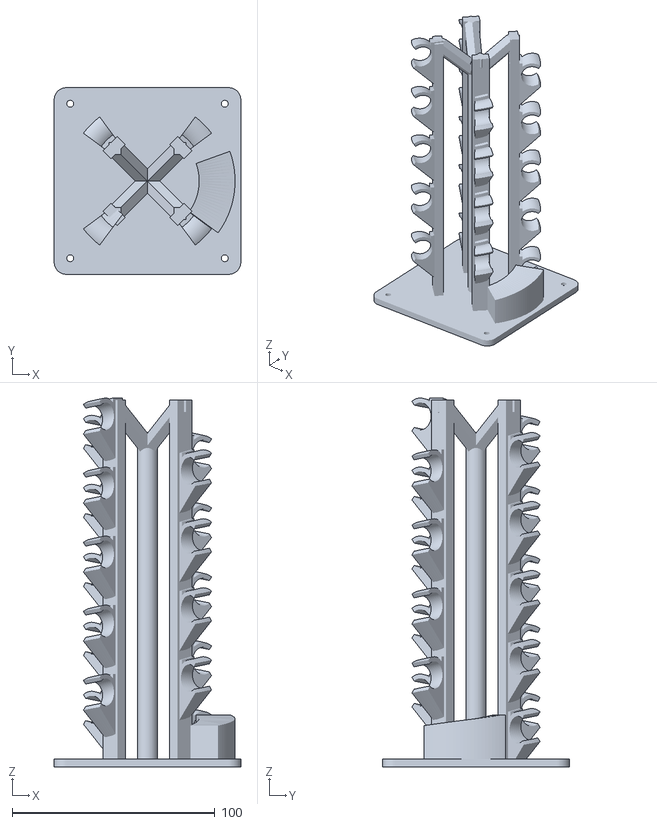
[picture p58: CAD file, 2026-10-19]
light mount/original-cage/spiral_cage_tube13mm.stl
92.0 x 92.0 x 181.8
