tbellenger/button-lamp/light mount/spiral_tube_mount/3mf/spiral_fit_coupon.3mf

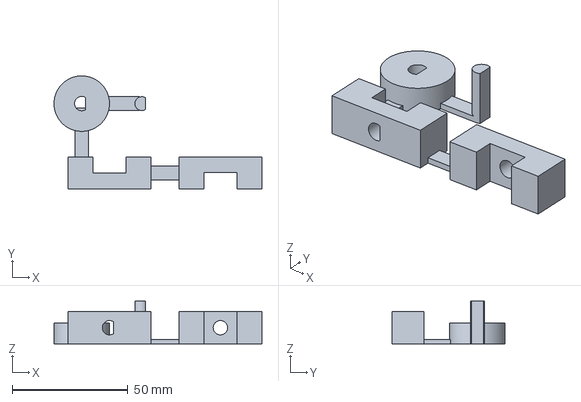
[picture p59: CAD file, 2026-11-08]
light mount/spiral_tube_mount/3mf/spiral_fit_coupon.3mf
90.0 x 49.0 x 18.5 mm
