tbellenger/button-lamp/original-plans/3D Printable Parts (STL Files)/Spiral (with base).stl

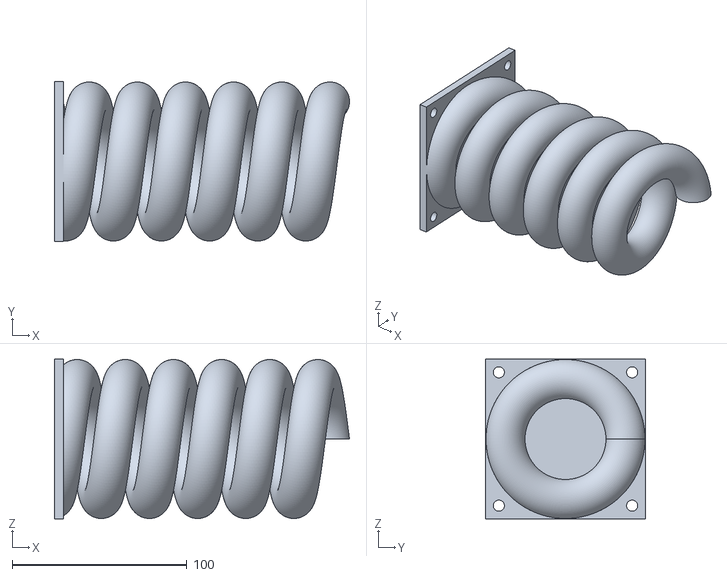
[picture p60: CAD file, 2026-10-17]
original-plans/3D Printable Parts (STL Files)/Spiral (with base).stl
168.7 x 91.4 x 91.4
