tbellenger/button-lamp/container/plywood/fingerjoint/dxf/as_ordered_S7872337/fj125_slope_qty1_mm.dxf

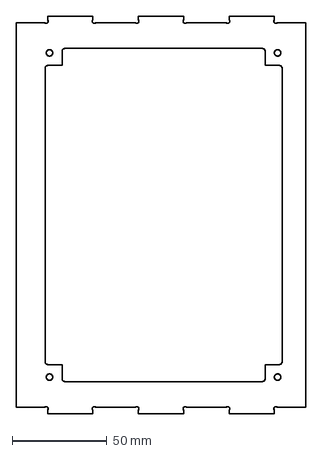
[picture p61: CAD file, 2026-10-21]
container/plywood/fingerjoint/dxf/as_ordered_S7872337/fj125_slope_qty1_mm.dxf
152.9 x 210.0 mm
