tbellenger/button-lamp/container/plywood/fingerjoint/dxf/fj125_bottom_qty1_mm.dxf

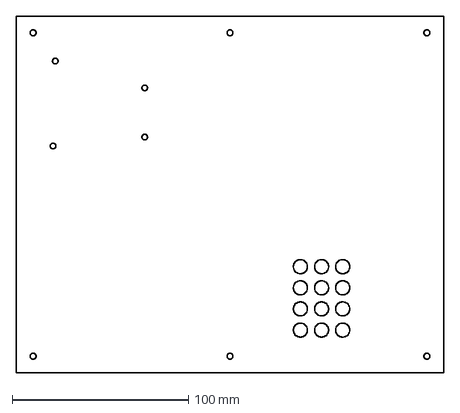
[picture p62: CAD file, 2026-10-21]
container/plywood/fingerjoint/dxf/fj125_bottom_qty1_mm.dxf
242.7 x 202.7 mm
