tbellenger/button-lamp/container/plywood/stl/bottom_block_x6.stl

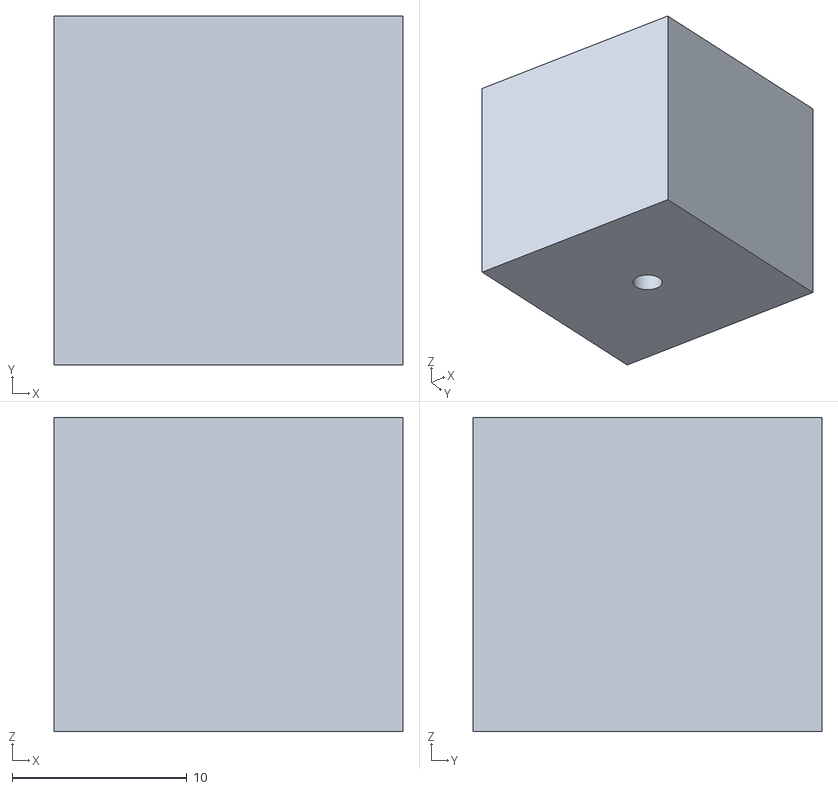
[picture p63: CAD file, 2026-10-18]
container/plywood/stl/bottom_block_x6.stl
20.0 x 20.0 x 18.0
