tbellenger/button-lamp/container/sheetmetal/dxf/sm_ms059_hood_qty1_mm.dxf

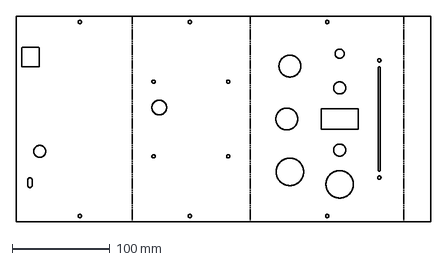
[picture p64: CAD file, 2026-11-08]
container/sheetmetal/dxf/sm_ms059_hood_qty1_mm.dxf
423.2 x 210.0 mm
