tbellenger/button-lamp/light mount/four_tower_spiral/3mf/tower_90.3mf

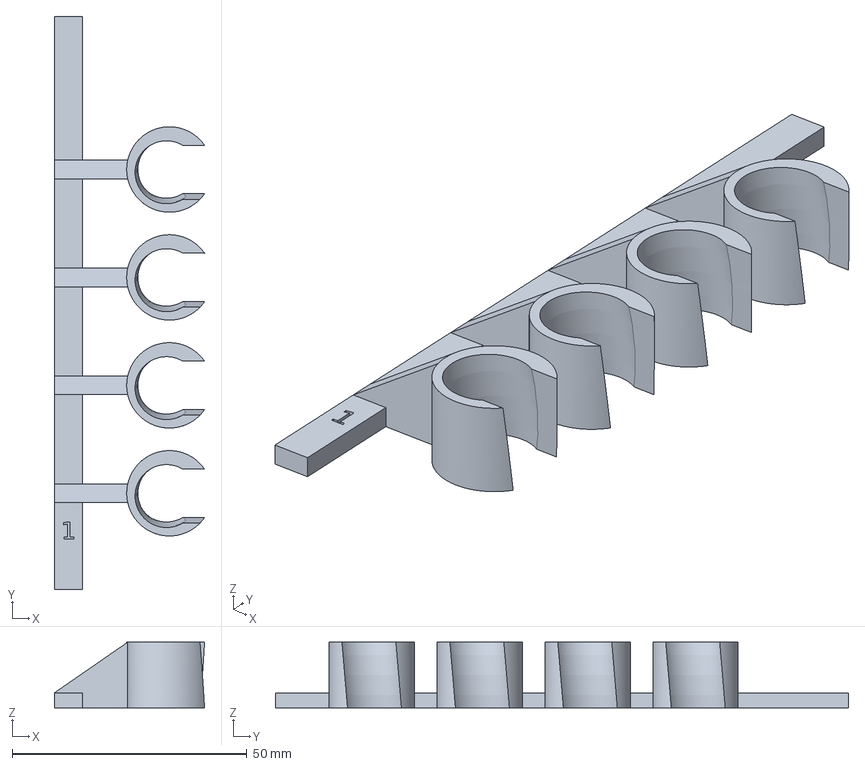
[picture p65: CAD file, 2026-11-08]
light mount/four_tower_spiral/3mf/tower_90.3mf
32.0 x 122.1 x 14.0 mm
