tbellenger/button-lamp/light mount/matrix_16x16_arduino_back/3mf/matrix_16x16_arduino_housing.3mf

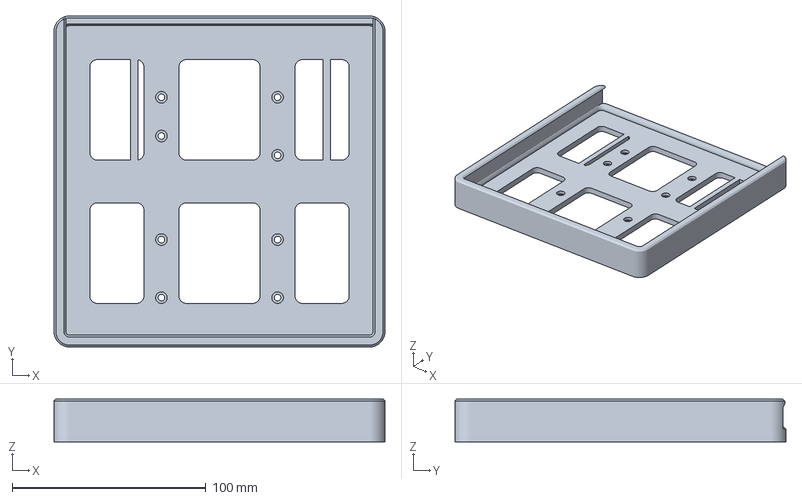
[picture p66: CAD file, 2026-11-11]
light mount/matrix_16x16_arduino_back/3mf/matrix_16x16_arduino_housing.3mf
171.0 x 171.0 x 22.2 mm
