tbellenger/button-lamp/light mount/matrix_16x16_mount/3mf/matrix_16x16_housing.3mf

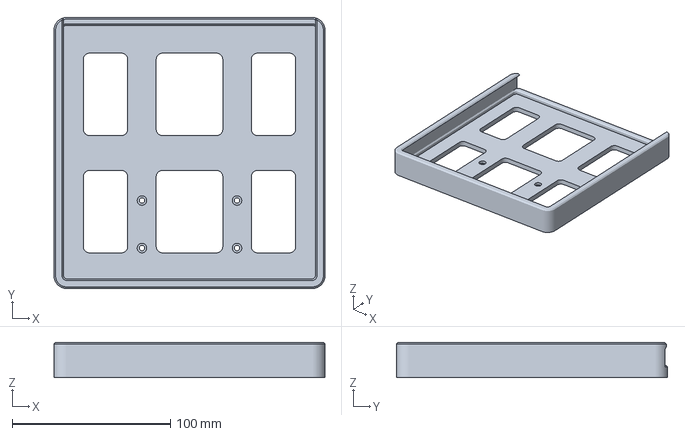
[picture p67: CAD file, 2026-10-25]
light mount/matrix_16x16_mount/3mf/matrix_16x16_housing.3mf
171.0 x 171.0 x 22.2 mm
