tbellenger/button-lamp/light mount/original-cage/clip_fit_test_tube13mm.stl

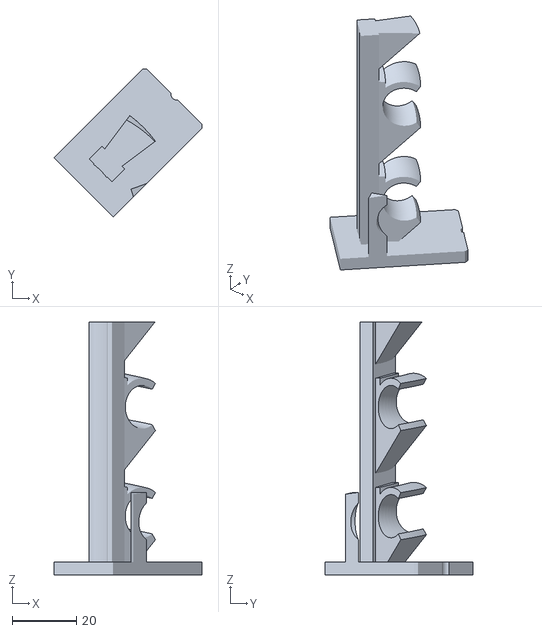
[picture p68: CAD file, 2026-10-18]
light mount/original-cage/clip_fit_test_tube13mm.stl
46.0 x 46.0 x 78.8
