tbellenger/button-lamp/original-plans/3D Printable Parts (STL Files)/Spiral End Cap.stl

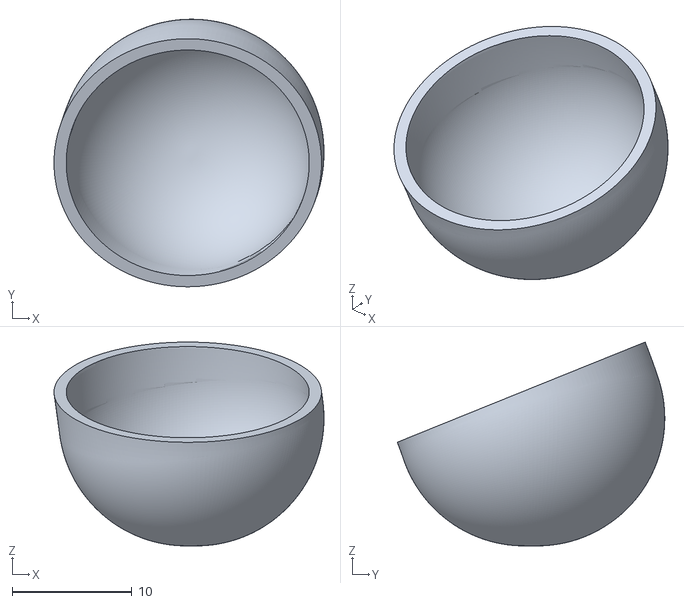
[picture p70: CAD file, 2026-10-17]
original-plans/3D Printable Parts (STL Files)/Spiral End Cap.stl
22.6 x 22.4 x 17.0
