tbellenger/button-lamp/container/sheetmetal/dxf/sm_ms059_cheek_left_qty1_mm.dxf

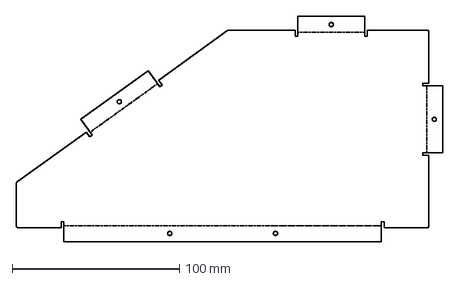
[picture p73: CAD file, 2026-10-21]
container/sheetmetal/dxf/sm_ms059_cheek_left_qty1_mm.dxf
255.3 x 135.0 mm
