tbellenger/button-lamp/light mount/matrix_16x16_arduino_back/3mf/matrix_16x16_arduino_shell.3mf

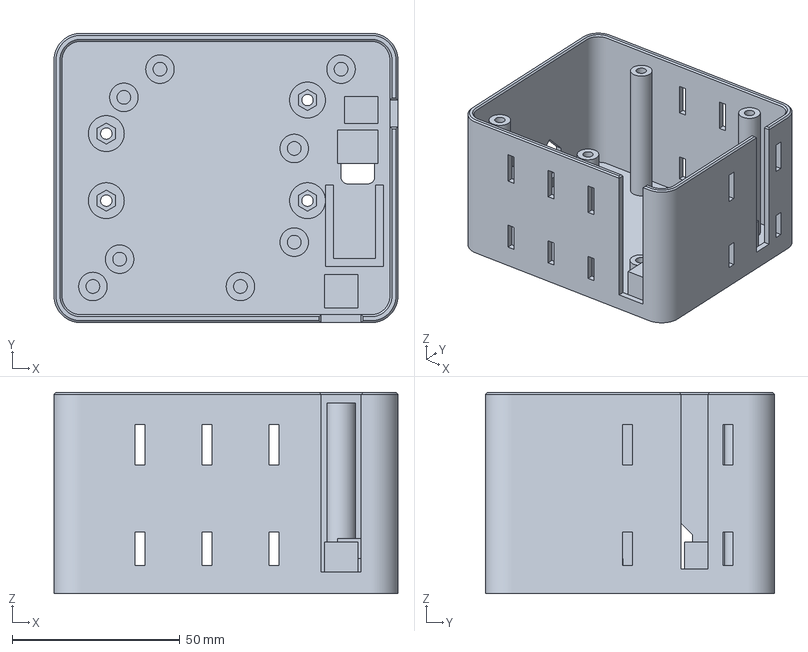
[picture p74: CAD file, 2026-11-01]
light mount/matrix_16x16_arduino_back/3mf/matrix_16x16_arduino_shell.3mf
102.6 x 86.3 x 60.0 mm
