tbellenger/button-lamp/light mount/matrix_16x16_mount/3mf/matrix_16x16_baffle_insert.3mf

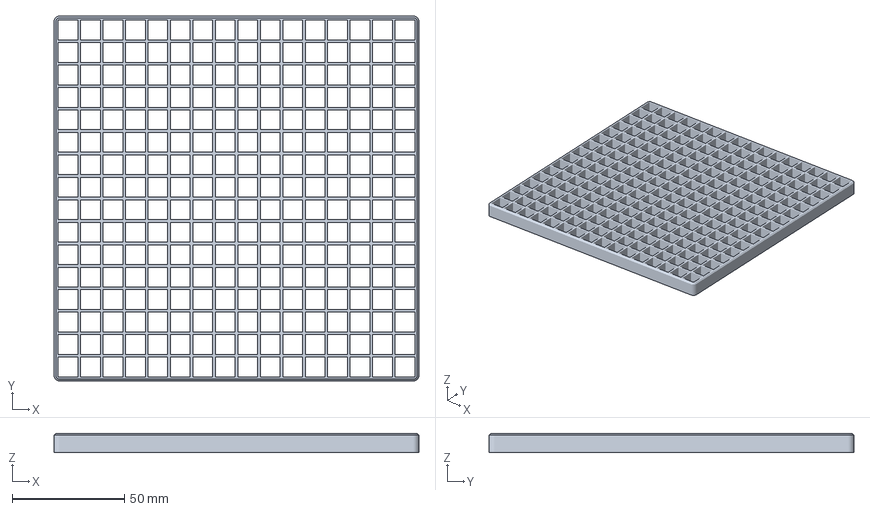
[picture p75: CAD file, 2026-10-25]
light mount/matrix_16x16_mount/3mf/matrix_16x16_baffle_insert.3mf
162.4 x 162.4 x 8.50 mm
