tbellenger/button-lamp/light mount/original-cage/end_cap_tube13mm.stl

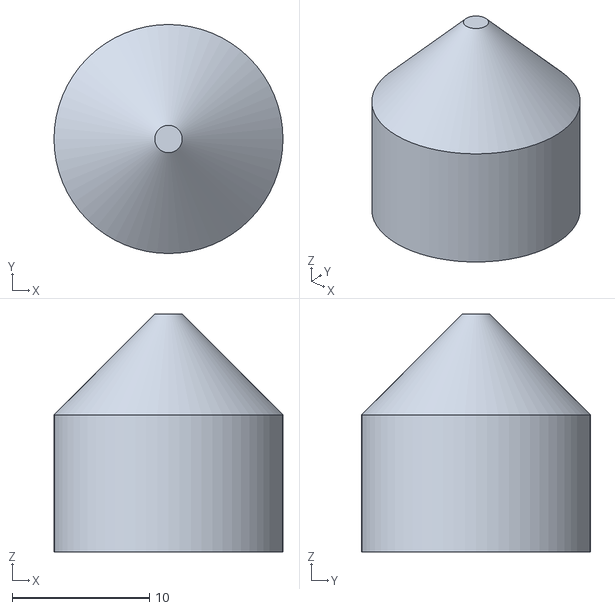
[picture p76: CAD file, 2026-10-18]
light mount/original-cage/end_cap_tube13mm.stl
16.7 x 16.7 x 17.4
