tbellenger/button-lamp/light mount/spiral_tube_mount/3mf/spiral_cross_high.3mf

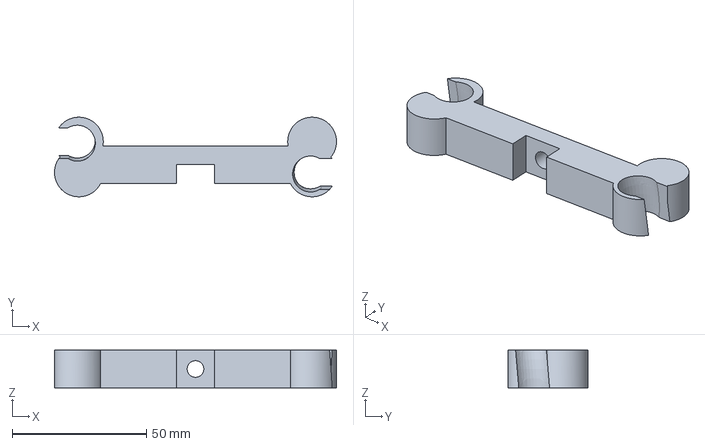
[picture p77: CAD file, 2026-11-08]
light mount/spiral_tube_mount/3mf/spiral_cross_high.3mf
105.2 x 29.7 x 14.0 mm
