tbellenger/button-lamp/original-plans/3D Printable Parts (STL Files)/Switch Panel.stl

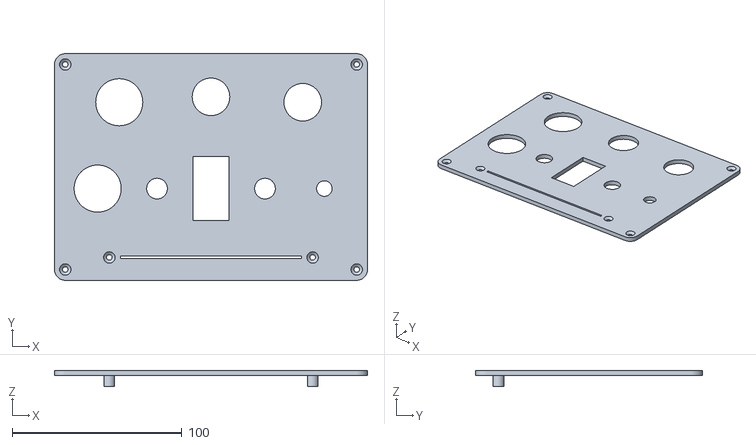
[picture p78: CAD file, 2026-10-17]
original-plans/3D Printable Parts (STL Files)/Switch Panel.stl
184.1 x 133.4 x 9.65
