tbellenger/button-lamp/container/plywood/fingerjoint/dxf/as_ordered_S7872337/fj125_bottom_qty1_mm.dxf

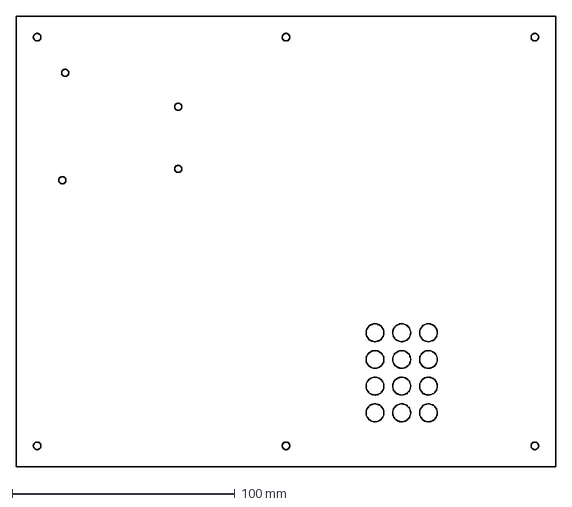
[picture p79: CAD file, 2026-10-21]
container/plywood/fingerjoint/dxf/as_ordered_S7872337/fj125_bottom_qty1_mm.dxf
242.7 x 202.7 mm
