tbellenger/button-lamp/container/plywood/fingerjoint/dxf/fj125_back_v2_qty1_mm.dxf

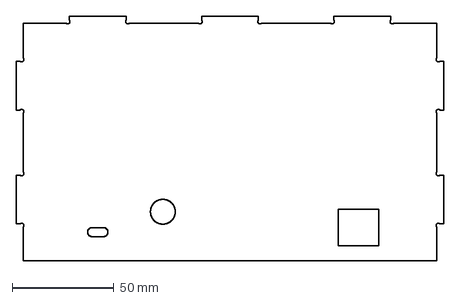
[picture p80: CAD file, 2026-10-21]
container/plywood/fingerjoint/dxf/fj125_back_v2_qty1_mm.dxf
210.0 x 120.0 mm
