tbellenger/button-lamp/container/sheetmetal/dxf/sm_ms059_cheek_right_qty1_mm.dxf

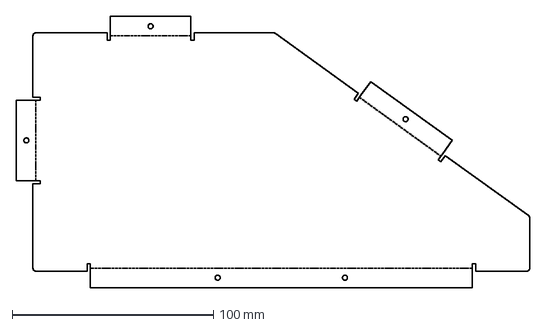
[picture p81: CAD file, 2026-10-21]
container/sheetmetal/dxf/sm_ms059_cheek_right_qty1_mm.dxf
255.3 x 135.0 mm
