tbellenger/button-lamp/light mount/spiral_tube_mount/3mf/spiral_cap.3mf

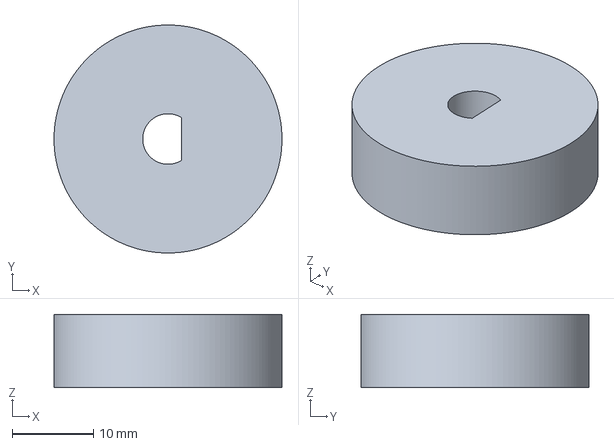
[picture p82: CAD file, 2026-11-08]
light mount/spiral_tube_mount/3mf/spiral_cap.3mf
28.0 x 28.0 x 9.00 mm
