tbellenger/button-lamp/original-plans/3D Printable Parts (STL Files)/Enclosure.stl

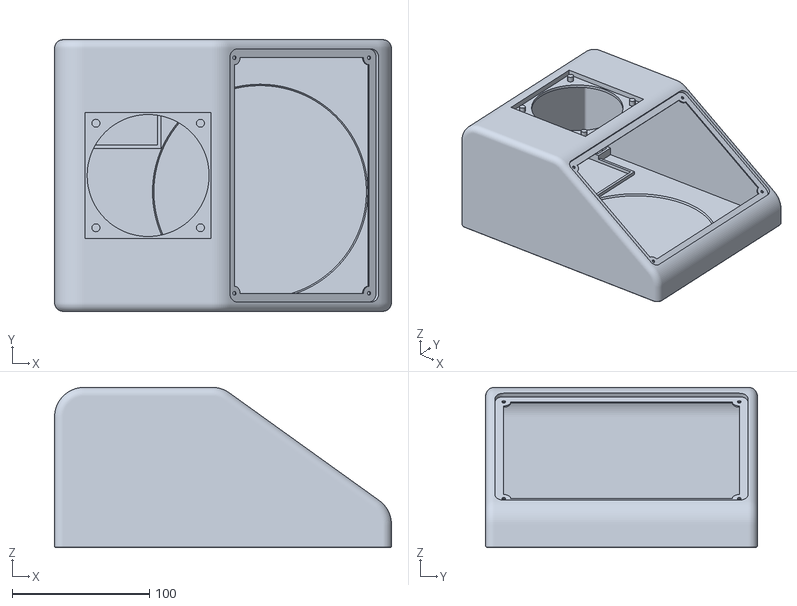
[picture p83: CAD file, 2026-10-17]
original-plans/3D Printable Parts (STL Files)/Enclosure.stl
245.7 x 198.1 x 116.8
