tbellenger/button-lamp/container/plywood/fingerjoint/dxf/as_ordered_S7872337/fj125_top_qty1_mm.dxf

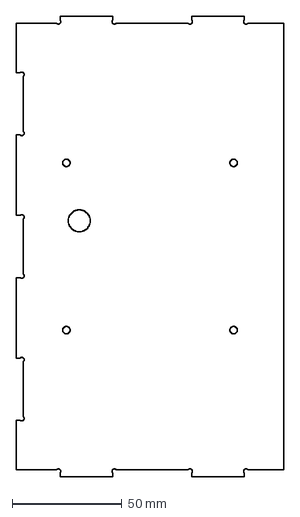
[picture p84: CAD file, 2026-10-21]
container/plywood/fingerjoint/dxf/as_ordered_S7872337/fj125_top_qty1_mm.dxf
122.0 x 210.0 mm
