tbellenger/button-lamp/container/plywood/fingerjoint/dxf/fj125_control_slope_qty1_mm.dxf

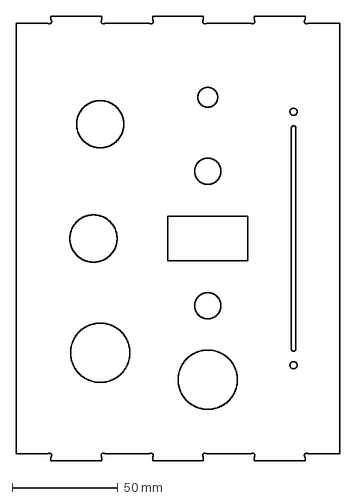
[picture p85: CAD file, 2026-10-21]
container/plywood/fingerjoint/dxf/fj125_control_slope_qty1_mm.dxf
152.9 x 210.0 mm
