tbellenger/button-lamp/container/sheetmetal/dxf/sm_al063_bottom_qty1_mm.dxf

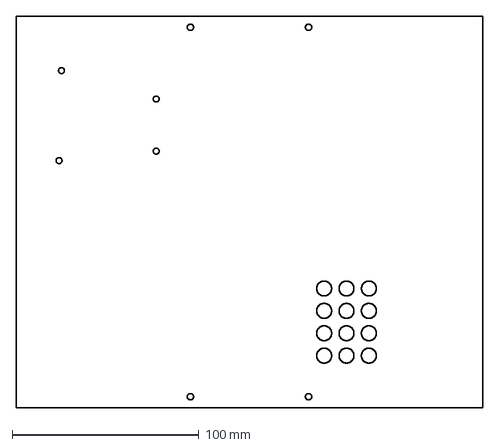
[picture p86: CAD file, 2026-10-21]
container/sheetmetal/dxf/sm_al063_bottom_qty1_mm.dxf
250.0 x 210.0 mm
