tbellenger/button-lamp/light mount/four_tower_spiral/3mf/tower_0.3mf

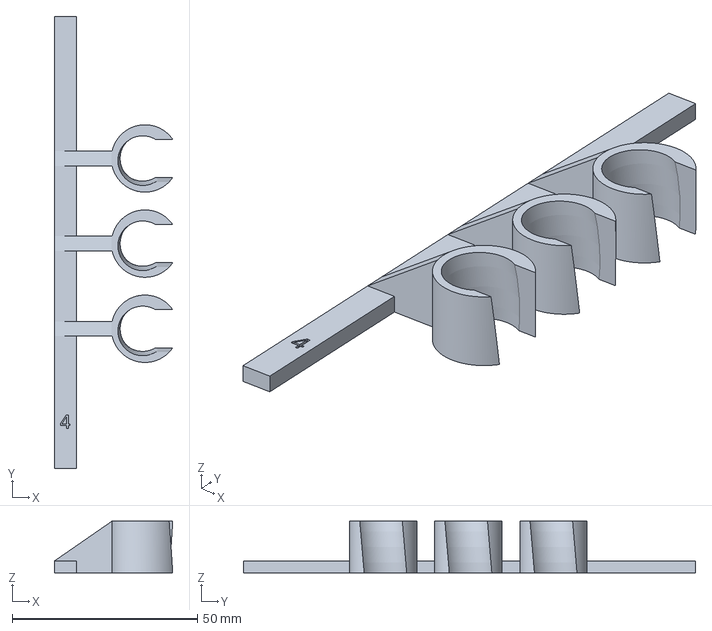
[picture p87: CAD file, 2026-11-08]
light mount/four_tower_spiral/3mf/tower_0.3mf
32.0 x 122.1 x 14.0 mm
