tbellenger/button-lamp/light mount/matrix_16x16_arduino_back/3mf/matrix_16x16_desk_stand.3mf

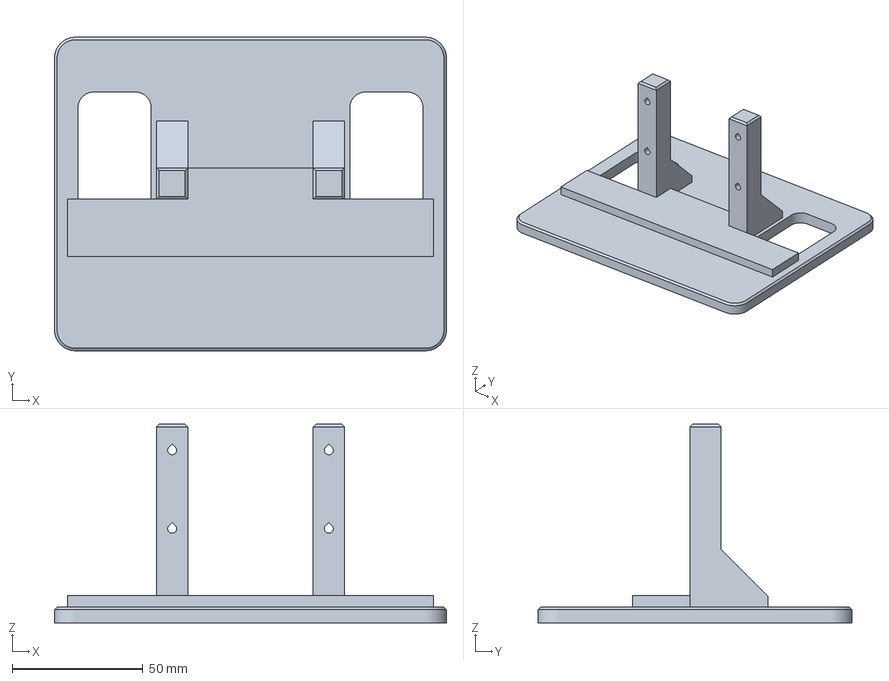
[picture p88: CAD file, 2026-11-01]
light mount/matrix_16x16_arduino_back/3mf/matrix_16x16_desk_stand.3mf
150.0 x 120.0 x 76.0 mm
