tbellenger/button-lamp/light mount/spiral_tube_mount/3mf/spiral_base.3mf

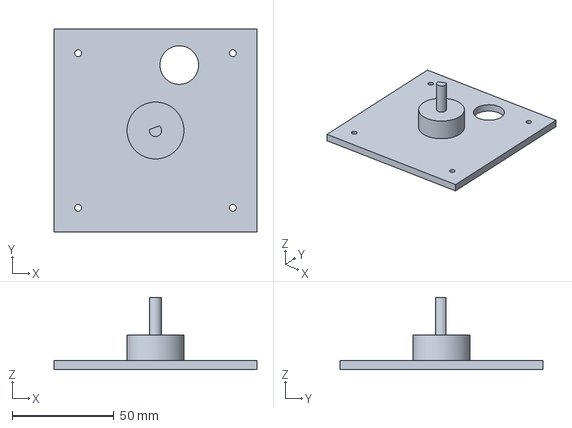
[picture p89: CAD file, 2026-11-08]
light mount/spiral_tube_mount/3mf/spiral_base.3mf
100.0 x 100.0 x 35.5 mm
