tbellenger/button-lamp/container/plywood/fingerjoint/dxf/as_ordered_S7872337/fj125_back_qty1_mm.dxf

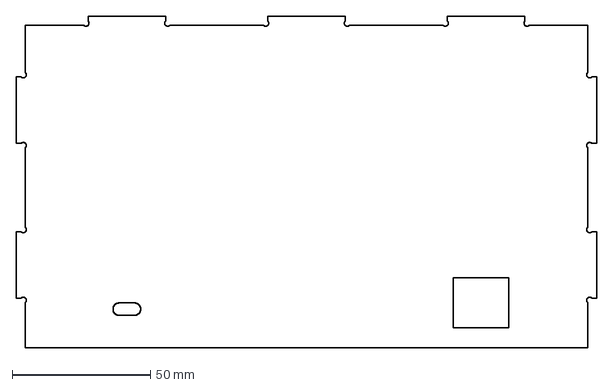
[picture p90: CAD file, 2026-10-21]
container/plywood/fingerjoint/dxf/as_ordered_S7872337/fj125_back_qty1_mm.dxf
210.0 x 120.0 mm
