tbellenger/button-lamp/container/plywood/fingerjoint/dxf/fj125_front_qty1_mm.dxf

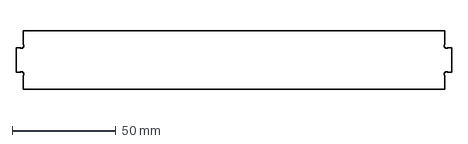
[picture p91: CAD file, 2026-10-21]
container/plywood/fingerjoint/dxf/fj125_front_qty1_mm.dxf
210.0 x 28.0 mm
