tbellenger/button-lamp/light mount/four_tower_spiral/3mf/tower_cap.3mf

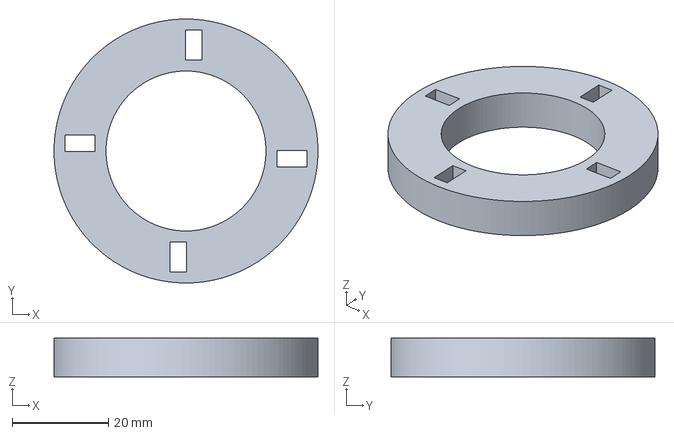
[picture p93: CAD file, 2026-11-08]
light mount/four_tower_spiral/3mf/tower_cap.3mf
54.8 x 54.8 x 8.00 mm
