tbellenger/button-lamp/light mount/spiral_tube_mount/3mf/spiral_spacer.3mf

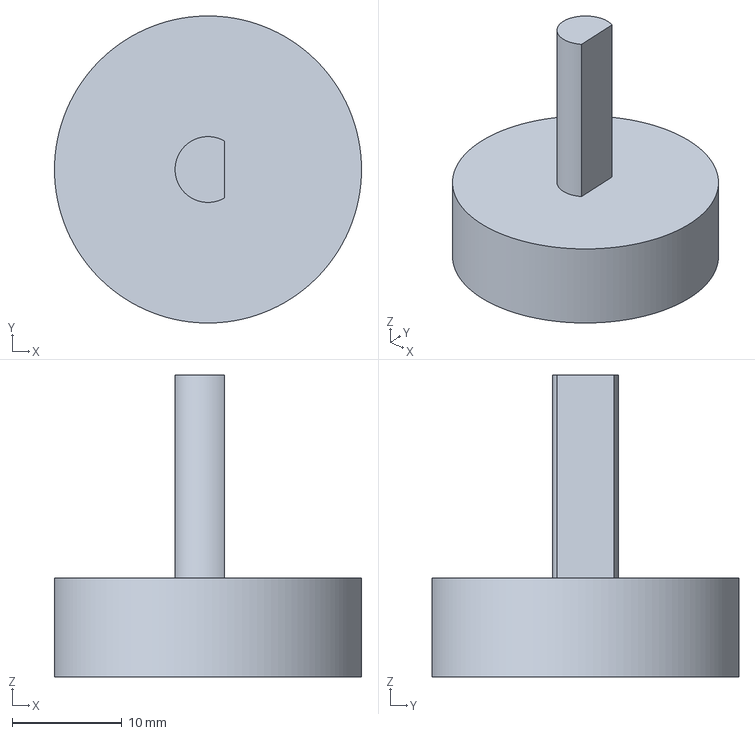
[picture p94: CAD file, 2026-11-08]
light mount/spiral_tube_mount/3mf/spiral_spacer.3mf
28.0 x 28.0 x 27.5 mm
