tbellenger/button-lamp/light mount/four_tower_spiral/3mf/tower_base.3mf

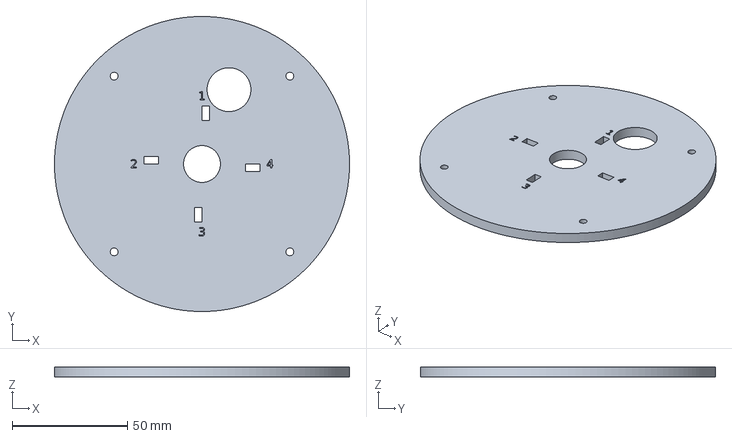
[picture p96: CAD file, 2026-11-08]
light mount/four_tower_spiral/3mf/tower_base.3mf
128.0 x 128.0 x 4.50 mm
