tbellenger/button-lamp/container/sheetmetal/dxf/sm_al063_cheek_left_qty1_mm.dxf

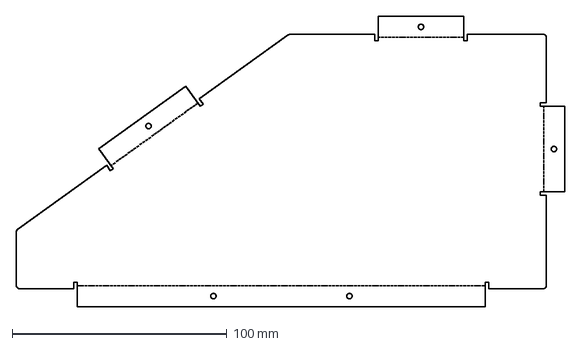
[picture p97: CAD file, 2026-10-21]
container/sheetmetal/dxf/sm_al063_cheek_left_qty1_mm.dxf
255.3 x 135.3 mm
