tbellenger/button-lamp/(list of files, cad)

Other CAD files:
light mount/four_tower_spiral/3mf/tower_270.3mf
light mount/four_tower_spiral/3mf/tower_180.3mf
light mount/matrix_16x16_arduino_back/3mf/matrix_16x16_baffle_insert.3mf
light mount/four_tower_spiral/stl/tower_0.stl
light mount/four_tower_spiral/stl/tower_180.stl
light mount/four_tower_spiral/stl/tower_270.stl
light mount/four_tower_spiral/stl/tower_90.stl
light mount/four_tower_spiral/stl/tower_base.stl
light mount/four_tower_spiral/stl/tower_cap.stl
light mount/four_tower_spiral/stl/tower_coupon.stl
light mount/matrix_16x16_arduino_back/stl/matrix_16x16_arduino_cover.stl
light mount/matrix_16x16_arduino_back/stl/matrix_16x16_arduino_housing.stl
light mount/matrix_16x16_arduino_back/stl/matrix_16x16_arduino_shell.stl
light mount/matrix_16x16_arduino_back/stl/matrix_16x16_baffle_insert.stl
light mount/matrix_16x16_arduino_back/stl/matrix_16x16_desk_stand.stl
light mount/matrix_16x16_mount/stl/matrix_16x16_baffle_insert.stl
light mount/matrix_16x16_mount/stl/matrix_16x16_base_mount.stl
light mount/matrix_16x16_mount/stl/matrix_16x16_housing.stl
light mount/spiral_tube_mount/stl/spiral_base.stl
light mount/spiral_tube_mount/stl/spiral_cap.stl
light mount/spiral_tube_mount/stl/spiral_cross_high.stl
light mount/spiral_tube_mount/stl/spiral_cross_low.stl
light mount/spiral_tube_mount/stl/spiral_fit_coupon.stl
light mount/spiral_tube_mount/stl/spiral_spacer.stl
