tbellenger/button-lamp/light mount/four_tower_spiral/parts/tower_assembly.md

# tower_assembly

<!-- AUTO: regenerated by `nurb card`. Do not hand-edit. -->
Size: 128.00 x 128.00 x 122.10 mm, 100560.4 mm3, 6 solids, 514 faces
Slivers: 147 under 1.0mm2, smallest 0.227mm2, 0 accepted
Checks: clean
<!-- /AUTO -->

## What it is

The ring, the four towers, and the cap, in place. Not exported as its own STL.

## Design notes

- 15 clips on a 1 m strip. Number 1, the 90° tower, has the lowest. Heights step 5.75 mm, one quarter of the 23 mm pitch.
- The four slots are the same. The recessed 1–4 are what say which tower goes where. Glue after the dry fit.
- `extra_stations` adds clips past the strip and raises the cap with them.

```toml
[part]
min_wall = 1.0
```

## Don't

- Don't mix towers from two different `strip_length` values. The cap height would not match.

## Changelog

- 2026-11-08: first assembly.
- 2026-11-08: keyed pins replaced by identical slots and recessed numbers.
- 2026-11-08: spoke tops slope from the clip down to the rib in the print-up direction.
