tbellenger/button-lamp/container/plywood/fingerjoint/ASSEMBLY.md

# Spiral Lamp casing: finger-joint version (SendCutSend, 1/8" Baltic birch)

> **v2 note (Oct 2026).** `dxf/` now holds the v2 set: the slope *is* the control panel (no printed Switch Panel)
> and the back has a 12.2 mm DC jack hole. Everything below about joints, glue and assembly order is unchanged.
> The set as ordered (S7872337, slope with a window for the printed panel) is in `dxf/as_ordered_S7872337/`.
> See [README.md](README.md) for the v2 parts and the control cut-outs.

Outside size stays **250 × 210 × 120 mm**. The panel window and holes, the USB-C slot, the USB-B window, the cage holes and the whole bottom tray are in exactly the same places as in the `plywood/` plan. Everything is generated by `src/fj.py`. The sheet thickness is the single parameter `T = 3.175` at the top of that file. If SendCutSend's quote page shows a different measured thickness, change `T` and run `./build.sh`.

| Part | Qty | Flat size (mm) | DXF |
|---|---|---|---|
| side | 2 | 250.0 × 120.0 | `dxf/fj125_side_qty2_mm.dxf` |
| back | 1 | 210.0 × 120.0 | `dxf/fj125_back_qty1_mm.dxf` |
| top | 1 | 122.0 × 210.0 | `dxf/fj125_top_qty1_mm.dxf` |
| slope | 1 | 152.9 × 210.0 | `dxf/fj125_slope_qty1_mm.dxf` |
| front | 1 | 210.0 × 28.0 | `dxf/fj125_front_qty1_mm.dxf` |
| bottom (removable tray, unchanged) | 1 | 242.65 × 202.65 | `dxf/fj125_bottom_qty1_mm.dxf` |
| printed bottom blocks (unchanged) | 6 | 20 × 20 × 18 | `../stl/bottom_block_x6.stl` |

The glue strips are gone. The tabs give the alignment and the glue area.

## How the joints work
- **Back, top, slope and front** each carry tabs on both ends: 24 mm long, or 12 mm on the front. The tabs drop into open notches cut in the edges of the two sides, and the tab ends finish flush with the outside faces of the sides.
- **Fit:** each notch is 0.30 mm longer than its tab and 0.15 mm deeper than the sheet is thick, which is SendCutSend's slip fit. Every inside corner has a Ø2.2 mm dogbone, so the square corners seat fully.
- **Back to top** is a 90° finger joint: the back has 3 tabs (28 mm) that rise into 3 notches in the top's back edge.
- **Top/slope crease (144°) and slope/front crease (126°)** have no joint, because square laser edges can't meet at those angles. Each panel is held only by its side tabs and stops 0.15 mm short of its neighbour. That leaves a small V groove on the outside along each crease: about 2.0 mm at the top crease and about 2.7 mm at the front crease. Fill them with wood filler (or glue mixed with sanding dust) and sand, or leave them as a shadow line.

## What's glued and what's screwed
- **Glued (PVA wood glue):** every tab joint, side to back, top, slope and front, plus the back-to-top fingers. The 6 printed blocks are glued to the walls.
- **Screwed:** the bottom tray (6 screws up into the blocks) and the spiral cage (4 × M3 through the top, with the backing plate). v2 has no switch panel to screw on: the controls mount straight in the control slope (the fader takes 2 × M3 from below). With the as-ordered slope, the printed panel or the birch retrofit faceplate screws on with 4 × M3.

## Order of assembly
1. **Dry fit everything first.** It's a slip fit, so the parts should push together by hand.
   - If a tab is tight (ply thickness varies), sand its faces lightly rather than the notches.
   - Before you glue, mark the faces:
     - **Back:** the DXF is drawn from inside. Seen from behind, the USB-B window is at the left end and the USB-C slot is at the right.
     - **Top:** the DXF is drawn from above. The 15 mm light-cable hole sits near the back edge, just right of centre as seen from the front. A top that was already cut at 10 mm has to be opened to 15 mm; the file change does not enlarge a finished board.
     - **Sides:** both are the same part. Flip one over for the other side.
2. Lay one side flat, inside face up.
3. Brush glue into its notches and on the tabs. Stand the back, front and slope in place.
4. Lower the top onto the back's three tabs and into its side notches.
5. Glue the second side on top, guiding all 8 tabs into its notches.
6. Drop the bottom tray in (no glue, no screws) to use as a squaring jig.
   - It has 0.5 mm clearance all round, so the box is square when the tray drops in evenly.
   - Clamp or tape the sides together and wipe off squeeze-out.
   - Let it cure for about 1 hour, or overnight before any stress.
7. **Blocks:** with the tray still sitting in place and the box upright on a flat bench, glue the 6 printed blocks to the walls.
   - Put glue on the wall faces only, never on the tray.
   - Press each block down onto the tray so it sits exactly at tray height.
   - Positions: the 4 corners plus the middle of each side, matching the tray's 6 screw holes.
   - Once cured, take the tray out.
8. Sand the tab ends flush, then fill and sand the two crease grooves if you want a clean line. Then do the finishing (see `plywood/PLAN.md` §8).
9. Fit the electronics to the tray as before. Screw the tray up into the blocks and bolt the cage to the top. v2: fit the controls to the control slope **before step 2** is fine too, but it's easier after the glue-up because the slope is held square; leave the harness long (250 mm).

## Checks (`check_report.json` for v2 and `check_report_as_ordered.json`, written by `src/check.py`)
- **DXFs:** read back from file. Closed LWPOLYLINEs only, layer 0, mm units, no self-intersections, cutouts nested inside the outline.
- **Smallest outer size:** 28.0 mm (the front). Every part is at least 25.4 mm.
- **Narrowest feature:** nothing under 2.03 mm, in either material webs or cut gaps. The smallest hole is 2.2 mm (the dogbones).
- **Joints:** checked on the 3D solids. All 19 tabs have a matching slot with exactly 0.30 mm length play and 0.15 mm depth play. All 28 side "fingers" clear their gaps by at least 0.15 mm. No slot is left without a tab.
- **3D assembly:** no two parts overlap. The closest panel-to-panel gaps are 0.15 mm (glue lines), and the bottom tray clears by 0.5 mm. The assembled box is 250.000 × 210.000 × 120.000 mm.
- **Outer skin:** the only openings at least 3 mm across are the intended ones: the USB slot and window, the cage and wire holes, the panel window and its holes, the vents, the tray's 0.5 mm gap, and the two crease grooves.
