tbellenger/button-lamp/light mount/matrix_16x16_arduino_back/parts/matrix_16x16_arduino_assembly.md

# matrix_16x16_arduino_assembly

<!-- AUTO: regenerated by `nurb card`. Do not hand-edit. -->
Size: 171.00 x 121.00 x 181.50 mm, 423081.6 mm3, 5 solids, 1600 faces
Slivers: 5 under 1.0mm2, smallest 0.339mm2, 0 accepted
Checks: clean
<!-- /AUTO -->

## What it is

The housing stood on the desk stand, with the Arduino shell and cover on the back and the baffle in the track. It is a placement check, not a print.

## Design notes

- The housing bolts to the stand on the original four holes. The shell's mating face is the housing backplate. The cover lip points into the bay.
- Nothing in the assembly intersects. The shell's bottom edge is at housing Y = −6.4, so it clears the stand pillars (they meet the backplate up to Y = −20) by 13.6 mm. The cover's outer face lands 1 mm past the stand foot's back edge (foot ends at Y = 52).

## Don't

- Don't export the assembly as one STL. Each part has its own print orientation.

## Changelog

- 2026-11-01: initial assembly of the Arduino-back matrix housing.
- 2026-11-01: shell deepened for the stacked terminal shield. Pillar clearance is 13.6 mm.
