tbellenger/button-lamp/container/plywood/fingerjoint/render/assembled_back_iso.png

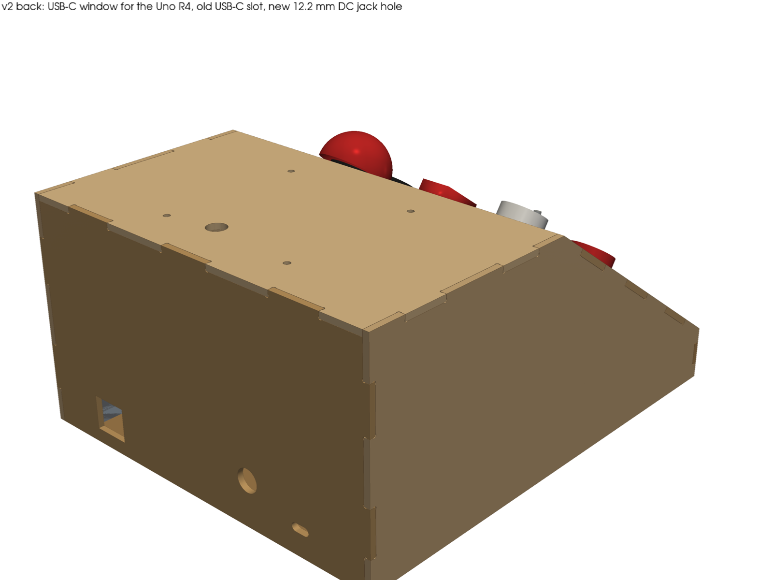
container/plywood/fingerjoint/render/assembled_back_iso.png
