tbellenger/button-lamp/container/plywood/render/assembled_back_iso.png

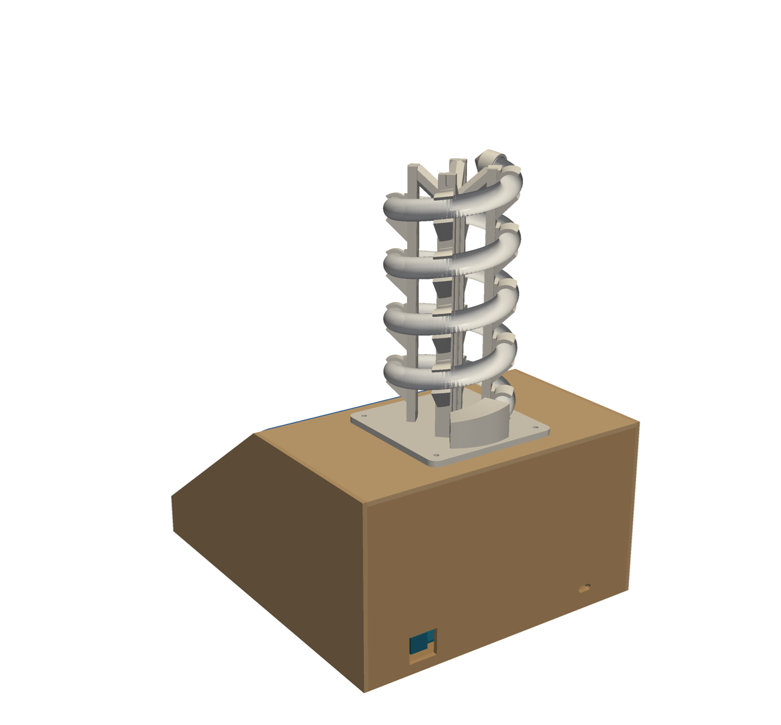
container/plywood/render/assembled_back_iso.png
