tbellenger/button-lamp/container/plywood/render/assembled_side_elevation.png

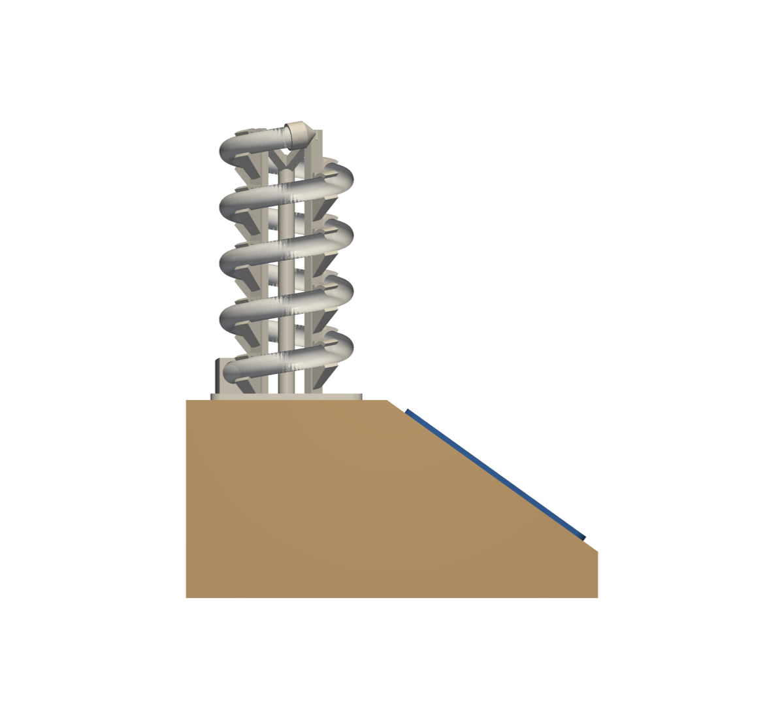
container/plywood/render/assembled_side_elevation.png
