tbellenger/button-lamp/light mount/four_tower_spiral/render/assembled_iso.png

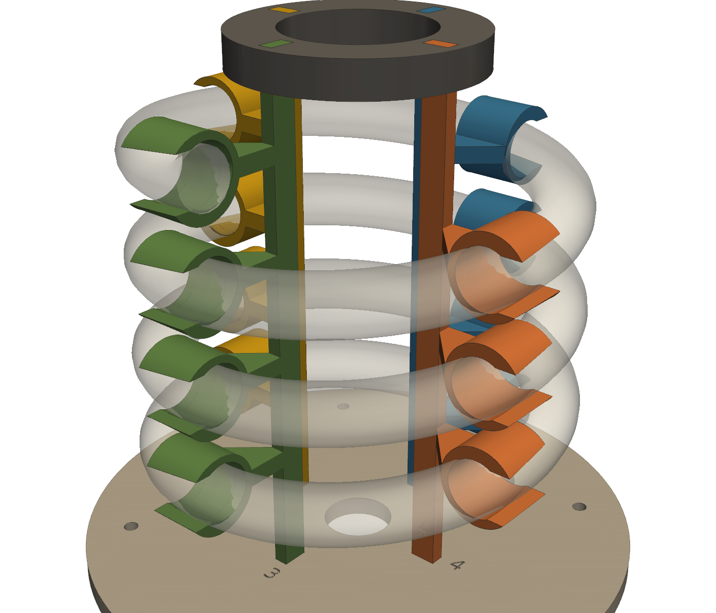
light mount/four_tower_spiral/render/assembled_iso.png
