tbellenger/button-lamp/light mount/four_tower_spiral/render/print_orientation.png

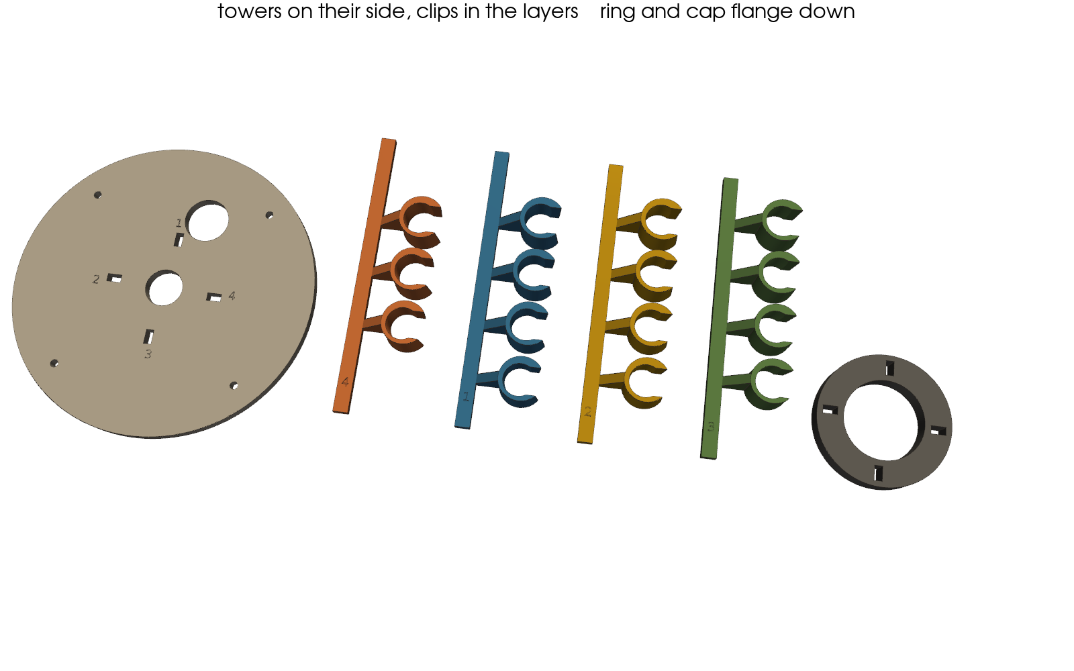
light mount/four_tower_spiral/render/print_orientation.png
