tbellenger/button-lamp/sketches/SpiralLamp_R4_FireTrail_WiFi_MIDI/SpiralLamp_R4_FireTrail_WiFi_MIDI.ino

/* ========= SpiralLamp_R4_FireTrail_WiFi_MIDI =========
   SpiralLamp_R4_FireTrail plus a WiFi page and an AppleMIDI Music mode.
   SpiralLamp_R3_Base, SpiralLamp_R3_FireTrail, and SpiralLamp_R4_FireTrail
   stay as they are. This folder is the one that joins WiFi.

   WiFi is a station on the UNO R4 WiFi coprocessor (WiFiS3, built into the
   Renesas core). Credentials live in secrets.h (copy secrets.example.h; the
   real file is gitignored). Joining does not stall the LED loop: WiFi.setTimeout(0),
   then status is polled. status() can be WL_CONNECTED before DHCP, so the page
   and AppleMIDI wait until localIP() is a non-zero address. Another begin()
   is not sent for 22 s, so that handshake is not aborted. A missing network
   or a dropped link leaves the lamp on its panel modes. The IP is printed on
   Serial at 115200. mDNS answers spirallamp.local and spiral-lamp.local.
   The DHCP hostname is spirallamp. The AppleMIDI session is not advertised
   over Bonjour; add it by IP, or set MAC_SESSION_IP.

   The page is http://<ip>/ on port 80 (one client, short reads and writes).
   GET /api/state and GET /api/set?key=value. A web brightness or speed holds
   until that pot moves about 4% of its travel. A web mode holds until the
   rocker, toggle, rainbow key, wave switch, or chaos mushroom changes; then
   the whole mode follows the panel. Lava colours apply at once. Fire trail
   has no switch, so the page keeps it (LAVA_FIRE_TRAIL is only the boot value).

   Music (AppleMIDI / rtpMIDI, library 3.5.x, UDP 5004, data 5005, session
   name "Spiral Lamp"). Each note-on launches a pulse from the bottom LED up
   the coil (32 slots, no heap). Pitch class picks one of 12 hues. Velocity
   sets brightness and tail length. Note-off fades the pulse, so a held note
   stays longer. Channel 10 flashes the whole coil. CC1 scales travel speed
   (64 = 1x) and CC7 scales brightness, both under the knob and the fader.
   Panel: toggle ON, rocker OFF, rainbow key OFF, wave OFF, chaos OFF.
   A note can enter Music from Off when the web is not holding a mode.
   About 10 s with no note plays a dim idle pulse and stays in Music.
   Add the lamp in Audio MIDI Setup by IP port 5004, or set MAC_SESSION_IP
   so the lamp sendInvite()s. No Bonjour.

   LED_COUNT is the strip length (default 160; -DLED_COUNT=320 for the next
   strip). BRIGHTNESS_CAP stays 50. 160 LEDs at that cap is about 1.9 A;
   320 is about 3.8 A. Full white at 255 would be about 9.6 A / 19 A.

   What changed from the R3 sketches, besides the radio:
     - Target is the Uno R4 WiFi (RA4M1, arduino:renesas_uno:unor4wifi).
     - AVR flash helpers (avr/pgmspace.h, PROGMEM, pgm_read_byte, memcpy_P,
       memcmp_P) are real on __AVR__ and plain memory reads otherwise. The
       RA4M1 maps flash into the address space, so the tables do not need a
       copy step. F() stays; both cores provide it.
     - analogReadResolution(10) on non-AVR. The R4 core already returns
       0..1023 (default requested resolution is 10). This keeps the pots on
       that scale if a later core default changes. AVR has no such call.
     - int is 32-bit here and 16-bit on the Uno. Lava already uses int16_t
       and int32_t, so the bounce math matches. millis/micros are still
       32-bit. float is still IEEE-754 single precision (hardware FPU on the R4).
     - Boot Serial line names this sketch. The strip pin macro is PIN_STRIP
       (still D9). The R4 variant header defines PIN_LED as the onboard LED
       on D13, and LED_BUILTIN aliases it.

   Uno R4 WiFi (arduino:renesas_uno:unor4wifi), core 1.6.0, Adafruit NeoPixel 1.15.5,
   AppleMIDI 3.5.0, MIDI Library 5.0.2. Sizes below include a short secrets.h.
   LED_COUNT 160:
       118816 B flash (45% of 262144), 15892 B globals (48% of 32768).
       16876 B remain for locals. NeoPixel mallocs 480 B. WiFiClient adds a 1024 B FIFO.
       The mDNS socket (about 1.5 KB) is malloc'd while WiFi is up.
   LED_COUNT 320:
       118768 B flash (45% of 262144), 16452 B globals (50% of 32768).
       16316 B remain for locals. NeoPixel mallocs 960 B.

   Based on "Version 4 – Exact YouTube Version" from the Alexjulness plans. Fixes (see issues.md):
     - All pins / LED count / colour order / brightness cap in ONE config block below.
     - Chaos mushroom is on its NC contacts (D11, INPUT_PULLUP): pressed = pin HIGH
       (CHAOS_ACTIVE_HIGH 1). An unwired D11 also reads HIGH, so Chaos arms only after
       the pin has been seen LOW once and does not force Lava at boot.
     - Global brightness cap (BRIGHTNESS_CAP) so USB / small supplies don't brown out.
     - HAVE_FADER / HAVE_SPEED_KNOB = 0 uses fixed values when a pot isn't wired yet
       (floating analog pins gave random brightness and speed).
     - Proper "stable for N ms" debounce (the old one accepted the first glitch instantly).
     - Chaos read from the debounced input (was a raw digitalRead).
     - Wave zero-window check uses each LED's CURRENT mode (V2's fix, lost again in V4).
     - One shared Jumbo colour-cycle edge tracker (two separate `static bool prev`
       copies could miss / double the toggle edge).
     - Optional Serial debug of every switch change (115200 baud). Unused vars removed.
     - RAM diet so 160 LEDs fit on an Uno (2 KB SRAM; NeoPixel mallocs LED_COUNT*3 = 480 B at runtime):
       colour tables / names / secret pattern live in flash (PROGMEM / F()), per-LED Jumbo
       brightness is computed on the fly, Wave per-LED mode is packed to 2 bits, constants are const.
       The plans' style used 1728 B of globals; the diet brought a 144-LED build to 1237 B
       (~379 B free after its 432 B strip buffer). That diet is why the R3 sketches
       still fit an Uno. This file targets the R4 (WiFi and AppleMIDI). The 32 KB
       SRAM makes the diet unnecessary here, but the lamp-mode layout is unchanged.
       The lava fire tail did not add globals on the Uno.
     - Centre-out fades (Rainbow on/off, Jumbo<->Rainbow handover) now centre on the middle of
       LED_COUNT (were hard-coded to LED 29/30 of a 60-LED strip).
     - Lava launch speed is derived from LED_COUNT. The old fixed kick (246) peaked about
       59 LEDs up, which is the whole of a 60-LED strip and short of centre on this one.
       Toss height varies; the strongest toss reaches the strip centre. The span advances
       once per bounce (from the speed that just landed). Sampling millis() instead locked
       the centre speed-knob setting onto the short toss after the opening bounce.
       Each ball also leaves a fire tail opposite its travel (LAVA_FIRE_TRAIL): orange
       beside the ball, then yellow, then white at the far end. Brightness fades
       toward the tip so it does not stop hard. Gone at the apex. Length follows
       |velocity| (about 12 LEDs at launch speed 256). No per-LED trail state.
       Jumbo, Rainbow, Wave, Secret, Classic and Dots already run across every LED.

   PRIORITIES (top -> bottom), when the web does not own the mode:
     1) Lava Lamp (Chaos switch ON: PIN_CHAOS=11)  -> full takeover
     2) Secret Mode (all four switches ON)         -> overrides others
     3) Wave Cover (PIN_WAVE=10)                   -> covers everything beneath; no Dots
     4) Rainbow (PIN_KEY=5 held)                   -> normal rainbow w/ handover
     5) Music (toggle ON, rocker/key/wave/chaos OFF). Idle after ~10 s still Music.
     6) Jumbo / Classic + Dots                     -> normal base with Dots overlay

   Dots overlay allowed over: Jumbo/Classic/Secret/black. (Disabled over Wave & Rainbow)

   White (PIN_RIGHT=4): spawn dot (and Wave pause / Lava top-blob color cycle)
   Red   (PIN_LEFT =8): delete oldest / hold ≥500ms deletes all (and Wave reverse hold / Lava bottom-blob color cycle)

   Notes:
   - Brightness fader (A0) now also affects Wave mode output.
   - Lava Lamp speed knob mapping: center=baseline; left=4× slower; right=8× faster (¼× → 1× → 8×).
   - Rainbow ON animation is skipped once when returning from Wave in a scenario where Rainbow was already active.
*/

#include <Adafruit_NeoPixel.h>
#include <WiFiS3.h>
#include <math.h>
#include <string.h>   // memmove/memcmp/memset
#include <stdio.h>
#include "secrets.h"
#if defined(__AVR__)
#include <avr/pgmspace.h>
#else
// RA4M1 (and the host harness) can read these tables in place. The R4 core
// also ships a deprecated avr/pgmspace.h shim; these defs cover a core that
// does not, and they match that shim.
#ifndef PROGMEM
#define PROGMEM
#endif
#ifndef pgm_read_byte
#define pgm_read_byte(addr) (*(const uint8_t *)(addr))
#endif
#ifndef memcpy_P
#define memcpy_P(dest, src, n) memcpy((dest), (src), (n))
#endif
#ifndef memcmp_P
#define memcmp_P(a, b, n) memcmp((a), (b), (n))
#endif
#endif

// ================== CONFIG (change these to match YOUR build) ==================
#define PIN_STRIP       9     // strip DIN (through a 330-470 ohm resistor). Not PIN_LED: R4 uses that for the onboard LED.
#ifndef LED_COUNT
#define LED_COUNT       160   // BTF FCOB 5 mm, 160/m. -DLED_COUNT=320 for the next strip.
#endif
#define LED_TYPE        (NEO_GRB + NEO_KHZ800)   // WS2812B-compatible. Try NEO_RGB if red/green swapped.

// Overall brightness ceiling 0-255 applied on top of everything (fader included).
// 160 LEDs at 60 mA full white is about 9.6 A, so:
//   ~10 : strip powered from USB / Arduino 5V (about 0.4 A)
//   80  : about the limit of a 5 V 3 A supply
//   255 : only with a 5 V / 10 A supply feeding the strip directly
// 160 LEDs at 50 is about 1.9 A. 320 LEDs at 50 is about 3.8 A.
// Full white at 255 is about 9.6 A (160) or 19 A (320). The cap stays 50.
#define BRIGHTNESS_CAP  50    // 160 LEDs on a 5 V 3 A supply: full white ~1.9 A.

// Set to 0 if that pot is NOT wired yet; the fixed value below is used instead.
#define HAVE_FADER       1
#define HAVE_SPEED_KNOB  1
#define FIXED_FADER      0.6f   // 0..1 brightness used when HAVE_FADER is 0
#define FIXED_KNOB       0.5f   // 0..1 knob position used when HAVE_SPEED_KNOB is 0 (0.5 = normal speed)

// Chaos / Lava mushroom on NC contacts: released = closed to GND = LOW, pressed = open = HIGH.
// Unwired D11 also reads HIGH, so Chaos stays off until the pin has been seen LOW once.
// Set to 0 only for a normally-open switch to GND (pressed = LOW); that wiring is always armed.
#define CHAOS_ACTIVE_HIGH 1

// Fire tail behind each lava ball, opposite its travel. Fixed orange→yellow→white,
// dimming toward the tip (the ball itself still uses the lava palette). 0 restores
// the plain balls.
// Computed from pos/vel each frame: no per-LED trail buffer.
// Boot value only. The web page can change g_fireTrail at runtime.
#define LAVA_FIRE_TRAIL 1
static uint8_t g_fireTrail =
#if LAVA_FIRE_TRAIL
    1
#else
    0
#endif
    ;

#define DEBOUNCE_MS     20    // a switch must be stable this long to count
#define DEBUG_SERIAL    1     // 1 = print every switch change to Serial @115200 (0 frees ~200 B RAM)

// ================== Hardware ==================
Adafruit_NeoPixel strip(LED_COUNT, PIN_STRIP, LED_TYPE);

// Shared inputs (from full sketch)
#define PIN_ROCKER      7     // Active LOW (jumbo rocker main power)
#define PIN_TOGGLE      6     // Active LOW (jumbo modifier toggle)
#define PIN_LEFT        8     // Active LOW (arcade red   -)  -> also Dots RED / Wave reverse-hold / Lava bottom color cycle
#define PIN_RIGHT       4     // Active LOW (arcade white +)  -> also Dots WHITE (spawn) / Wave pause / Lava top color cycle
#define PIN_KEY         5     // Active LOW (Rainbow key)
#define PIN_FADER       A0    // 0..1023 brightness fader (global)
#define PIN_SPEED_KNOB  A1    // 0..1023 speed knob (shared)

// Wave cover toggle (from NewWave sketch)
#define PIN_WAVE       10     // Active LOW (red-cover wave ON/OFF)

// Chaos (Lava Lamp mode)
#define PIN_CHAOS      11     // INPUT_PULLUP; polarity set by CHAOS_ACTIVE_HIGH above (takes priority)

// ================== Web vs panel (see lamp_wifi.h) ==================
// WM_MUSIC is last so the earlier values stay put.
enum WebMode : uint8_t {
  WM_OFF = 0, WM_JUMBO, WM_CLASSIC, WM_RAINBOW, WM_WAVE,
  WM_WAVE_MOD, WM_WAVE_RAINBOW, WM_WAVE_EPIC, WM_SECRET, WM_LAVA, WM_MUSIC
};
static const int PHYS_ANALOG_TAKEOVER = 40; // ~4% of 0..1023
static uint8_t webOwnsFader = 0, webOwnsKnob = 0, webOwnsMode = 0;
static float webFader01 = 0.6f;
static int webBrightPct = 60;
static int webKnobRaw = 512;
static int webSpeedPct = 50;
static int faderAnchor = 0, knobAnchor = 0;
static uint8_t webMode = WM_OFF;
static uint8_t webModeBeforeLava = WM_JUMBO;
static uint8_t g_reportedMode = WM_OFF;
static uint8_t effRocker = 0, effToggle = 0, effKey = 0, effWave = 0, effChaos = 0;

// One analog sample per millis, shared by the fader, the knob, and takeover.
static uint32_t g_analogMs = 0xFFFFFFFFu;
static int g_faderRawCached = 0;
static int g_knobRawCached = 0;
static uint8_t g_analogFresh = 0;
static void sampleAnalogs(){
#if HAVE_FADER || HAVE_SPEED_KNOB
  uint32_t now = millis();
  if (g_analogFresh && g_analogMs == now) return;
  g_analogMs = now;
  g_analogFresh = 1;
#if HAVE_FADER
  g_faderRawCached = analogRead(PIN_FADER);
#endif
#if HAVE_SPEED_KNOB
  g_knobRawCached = analogRead(PIN_SPEED_KNOB);
#endif
#else
  (void)0;
#endif
}
static int faderPhysical(){
#if HAVE_FADER
  sampleAnalogs();
  return g_faderRawCached;
#else
  return (int)(FIXED_FADER * 1023.0f + 0.5f);
#endif
}
static int knobPhysical(){
#if HAVE_SPEED_KNOB
  sampleAnalogs();
  return g_knobRawCached;
#else
  return (int)(FIXED_KNOB * 1023.0f + 0.5f);
#endif
}
static inline int readFaderRaw(){ return faderPhysical(); }
static inline int readKnobRaw(){
#if HAVE_SPEED_KNOB
  int phys = knobPhysical();
  if (webOwnsKnob && abs(phys - knobAnchor) > PHYS_ANALOG_TAKEOVER){
    webOwnsKnob = 0;
#if DEBUG_SERIAL
    Serial.println(F("knob taken by panel"));
#endif
  }
#endif
  if (webOwnsKnob) return webKnobRaw;
  return knobPhysical();
}


// ================== Small helpers ==================
static inline float clamp01(float x){ return x<0?0:(x>1?1:x); }
static inline float ease01(float u){ u=clamp01(u); return 0.5f*(1.0f - cosf(3.14159265f*u)); }
static inline uint8_t mix8(uint8_t a,uint8_t b,float t){ t=clamp01(t); return (uint8_t)((1.f-t)*a+t*b+0.5f); }
static inline int32_t wrapLoop(int32_t v, int32_t mod){ v%=mod; if(v<0) v+=mod; return v; }
static inline uint16_t clampU16(uint16_t v,uint16_t lo,uint16_t hi){ if(v<lo) return lo; if(v>hi) return hi; return v; }
static inline uint8_t clamp8i(int v){ return (v<0)?0:((v>255)?255:(uint8_t)v); }

// ---------- Inline staggers (replaces big arrays) ----------
static inline uint16_t STAG_BOTTOM_MS(uint16_t i){ return (uint16_t)(i * 17U); }
// Centre-out stagger. Centre follows LED_COUNT (was hard-coded 29/30 for 60 LEDs).
static inline uint16_t centerDist(uint16_t i){ int dA=abs((int)i-(LED_COUNT-1)/2), dB=abs((int)i-LED_COUNT/2); return (uint16_t)((dA<dB)?dA:dB); }
static inline uint16_t STAG_CENTER8_MS (uint16_t i){ return (uint16_t)(centerDist(i) *  8U); }
static inline uint16_t STAG_CENTER20_MS(uint16_t i){ return (uint16_t)(centerDist(i) * 20U); }

// ================== Debouncer ==================
// A change only counts once the raw pin has held the new level for DEBOUNCE_MS.
struct DebouncedInput{
  uint8_t pin; bool activeLow; uint8_t stable,lastStable,lastRaw; uint32_t rawSinceMs; const __FlashStringHelper* name;   // name lives in flash (F())
  void begin(uint8_t p,bool isActiveLow,const __FlashStringHelper* nm){
    pin=p; activeLow=isActiveLow; name=nm; pinMode(pin,INPUT_PULLUP);
    stable=lastStable=lastRaw=digitalRead(pin); rawSinceMs=millis();
  }
  // 0 none, 1 rose (LOW->HIGH), 2 fell (HIGH->LOW)
  uint8_t update(uint32_t now,uint16_t dbMs=DEBOUNCE_MS){
    uint8_t raw=digitalRead(pin);
    if(raw!=lastRaw){ lastRaw=raw; rawSinceMs=now; }
    if(raw!=stable && (now-rawSinceMs)>=dbMs){
      lastStable=stable; stable=raw;
#if DEBUG_SERIAL
      Serial.print(name); Serial.print(F(" (D")); Serial.print(pin); Serial.print(F("): "));
      Serial.println(pressed()?F("ON/pressed"):F("OFF/released"));
#endif
      if(lastStable==LOW && stable==HIGH) return 1;
      if(lastStable==HIGH && stable==LOW)  return 2;
    }
    return 0;
  }
  bool pressed() const { return activeLow ? (stable==LOW) : (stable==HIGH); }
};

// ================== Global fader / speed ==================
float  g_lastKnobNorm = 0.5f;
float  g_speedScale   = 1.0f; // 0.25x..8x mapping (used by base modes)
float  g_fader        = 1.0f; // 0..1
const float SPEED_EMA = 0.45f, SPEED_DB=0.006f, FADER_EMA=0.35f;

static inline float mapNormToScale(float n){
  return (n<=0.5f)?(0.25f+(n/0.5f)*(1.0f-0.25f)):(1.0f+((n-0.5f)/0.5f)*(8.0f-1.0f));
}
static inline void updateSpeed(){
  float n=readKnobRaw()/1023.0f;
  if (fabsf(n-g_lastKnobNorm)<SPEED_DB) n=g_lastKnobNorm;
  g_lastKnobNorm=(1.0f-SPEED_EMA)*g_lastKnobNorm+SPEED_EMA*n;
  g_speedScale=mapNormToScale(g_lastKnobNorm);
}

// *** FIXED: fader now hits true 100% when slider is at the top ***
static inline void updateFader(){
  if (webOwnsFader){
#if HAVE_FADER
    int phys = faderPhysical();
    if (abs(phys - faderAnchor) > PHYS_ANALOG_TAKEOVER){
      webOwnsFader = 0;
#if DEBUG_SERIAL
      Serial.println(F("fader taken by panel"));
#endif
      float raw = phys / 1023.0f;
      if (raw > 0.90f) raw = 1.0f;
      g_fader = clamp01(raw);
      return;
    }
#endif
    g_fader = webFader01;
    return;
  }
  float raw = readFaderRaw()/1023.0f;
  // Stretch out the top of the pot so the last ~10% becomes "full on"
  // and ignore tiny noise at the very top.
  if (raw > 0.90f) raw = 1.0f;
  g_fader = (1.0f - FADER_EMA)*g_fader + FADER_EMA*raw;
  g_fader = clamp01(g_fader);
}

// ================== Color calibration ==================
const float CAL_R_GAIN = 1.06f;
const float CAL_G_GAIN = 0.94f;
const float CAL_B_GAIN = 1.00f;

// ================== ---------- JUMBO ROCKER MODE ---------- ==================
const uint8_t  GLOBAL_BRIGHT     = 255;
const uint16_t JUMBO_FADE_MS     = 30;
const uint32_t SEQ_TOTAL_MS      = (uint32_t)(LED_COUNT-1)*17 + JUMBO_FADE_MS;

uint32_t g_lastMsBright=0;
float    g_progressMs=0.f;
bool     g_wantOn=false;

// Wave default color taps the last Jumbo color:
uint8_t g_lastJumboR=255, g_lastJumboG=255, g_lastJumboB=255;

// Per-LED Jumbo brightness, computed on the fly (replaces a LED_COUNT-byte buffer).
static inline float clampJumboProgress(float progress){
  if(progress<0) progress=0;
  if(progress>SEQ_TOTAL_MS) progress=SEQ_TOTAL_MS;
  return progress;
}
static inline uint8_t jumboBrightAt(float progress, uint16_t i){
  float local=progress - STAG_BOTTOM_MS(i);
  float e = (local<=0)?0.f : (local>=JUMBO_FADE_MS?1.f : (local/(float)JUMBO_FADE_MS));
  return (uint8_t)(e*255.f+0.5f);
}

// --- Jumbo color engine (toggle cycling) ---
// Jumbo colour ring R,P,B,G,Y,O (in flash). White (255,255,255) is the start colour.
const uint8_t CS_RING[6][3] PROGMEM = { {255,0,0}, {170,0,255}, {0,0,255}, {0,255,0}, {255,112,0}, {255,50,0} };
struct ColorSeq{
  bool startedOnce=false, enabled=false, inOnPhase=false;
  uint32_t lastMs=0; float tOn_ms=0.f, tHold_ms=0.f;
  uint8_t curR=255,curG=255,curB=255;

  void hardOff(uint32_t now){ enabled=false; inOnPhase=false; startedOnce=false; tOn_ms=0; tHold_ms=0; lastMs=now; curR=255; curG=255; curB=255; }
  void onActiveRising(uint32_t now){ enabled=true; lastMs=now; if(!startedOnce){ inOnPhase=true; tOn_ms=0; } }
  void onActiveFalling(uint32_t now){ enabled=false; lastMs=now; }
  void forceStartHoldAtRed(uint32_t now){ enabled=true; startedOnce=true; inOnPhase=false; tHold_ms=0; lastMs=now; curR=255;curG=0;curB=0; }

  void update(uint32_t now,float speed){
    uint32_t dt_ms=now-lastMs; lastMs=now; float dt=dt_ms*speed;
    if(!enabled) return;
    if(inOnPhase){
      const float FADE=2300.f;
      tOn_ms+=dt; if(tOn_ms>FADE) tOn_ms=FADE;
      float u=ease01(tOn_ms/FADE);
      curR=mix8(255,255,u); curG=mix8(255,0,u); curB=mix8(255,0,u);
      if(tOn_ms>=FADE){ inOnPhase=false; startedOnce=true; tHold_ms=0; }
      return;
    }
    const float HOLD=85.f, FADE=2300.f, TOTAL=HOLD+FADE, LOOP=TOTAL*6.f;
    tHold_ms+=dt; if(tHold_ms>=LOOP) tHold_ms=fmodf(tHold_ms,LOOP);
    uint32_t k=(uint32_t)(tHold_ms/TOTAL); float tIn=fmodf(tHold_ms,TOTAL);
    uint8_t A[3], Bn[3]; memcpy_P(A,CS_RING[k],3); memcpy_P(Bn,CS_RING[(k+1)%6],3);
    if(tIn<HOLD){ curR=A[0];curG=A[1];curB=A[2]; }
    else{ float u=ease01((tIn-HOLD)/FADE); curR=mix8(A[0],Bn[0],u); curG=mix8(A[1],Bn[1],u); curB=mix8(A[2],Bn[2],u); }
  }
  void get(uint8_t& r,uint8_t& g,uint8_t& b) const{ r=curR; g=curG; b=curB; }
} colorSeq;

// Classic Lamp (secret sequence)
enum Mode:uint8_t{ MODE_JUMBO=0, MODE_CLASSIC=1, MODE_SECRET=2 };
Mode g_mode=MODE_JUMBO;
char seqBuf[9]={0};
const char TARGET[] PROGMEM = "rlrrlrll";
bool g_seqMatched=false;
static inline void pushSeqChar(char c){ memmove(seqBuf,seqBuf+1,7); seqBuf[7]=c; seqBuf[8]='\0'; g_seqMatched=(memcmp_P(seqBuf,TARGET,8)==0); if(g_seqMatched) memset(seqBuf,0,sizeof(seqBuf)); }
static inline void classicColorFromKnob(float u,uint8_t& r,uint8_t& g,uint8_t& b){
  const uint8_t Y_R=255,Y_G=112,Y_B=0, W_R=255,W_G=255,W_B=255;
  const uint8_t O_R2=255,O_G2=50,O_B2=0;
  u=clamp01(u);
  if(u<=0.5f){
    float t=u/0.5f;
    r=mix8(O_R2,Y_R,t);
    g=mix8(O_G2,Y_G,t);
    b=mix8(O_B2,Y_B,t);
  } else {
    float t=(u-0.5f)/0.5f;
    r=mix8(Y_R,W_R,t);
    g=mix8(Y_G,W_G,t);
    b=mix8(Y_B,W_B,t);
  }
}
struct BridgeSeq{ bool active=false; uint32_t lastMs=0; float t_ms=0.f; uint8_t r0=255,g0=255,b0=255;
  void start(uint8_t r,uint8_t g,uint8_t b,uint32_t now){ r0=r;g0=g;b0=b; t_ms=0; lastMs=now; active=true; }
  bool update(uint32_t now,float speed,uint8_t& r,uint8_t& g,uint8_t& b){
    if(!active) return false; t_ms+=(now-lastMs)*speed; lastMs=now; const float FADE=2300.f;
    if(t_ms>=FADE){ r=255; g=0; b=0; active=false; return false; }
    float u=ease01(t_ms/FADE); r=mix8(r0,255,u); g=mix8(g0,0,u); b=mix8(b0,0,u); return true;
  }
} bridge;
static inline void enterClassic(uint32_t now){ g_mode=MODE_CLASSIC; bridge.active=false; colorSeq.hardOff(now); }
static inline void exitClassicToJumboAtRed(uint32_t now){ g_mode=MODE_JUMBO; colorSeq.forceStartHoldAtRed(now); }

// ================== ---------- RAINBOW (KEY) MODE ---------- ==================
const uint16_t DEFAULT_STAG_MS=177, DEFAULT_HOLD_MS=60, DEFAULT_FADE_MS=200;
uint16_t STAG_MS=DEFAULT_STAG_MS, HOLD_MS=DEFAULT_HOLD_MS, FADE_MS=DEFAULT_FADE_MS;
static inline uint16_t blockMs(){ return (uint16_t)(HOLD_MS+FADE_MS); }
static inline uint32_t loopMs(){ return (uint32_t)7*blockMs(); }
static inline void enforceMinBlock(){ uint16_t blk=blockMs(); if(blk<10){ FADE_MS=(uint16_t)(FADE_MS+(10-blk)); } }
static inline uint16_t addClamped(uint16_t v,uint16_t add,uint16_t vmax){ uint32_t t=(uint32_t)v+add; if(t>vmax) t=vmax; return (uint16_t)t; }

enum BrState:uint8_t{ BR_OFF=0, BR_ON_ANIM, BR_HOLD, BR_OFF_ANIM };
BrState brState=BR_OFF;
uint32_t brLastMs=0, brT_ms=0;
uint32_t phaseMs=0, lastMs=0;

// Buttons / interaction for Rainbow path
const uint16_t LONG_HOLD_MS=500, MAX_TIME_MS=5000;
uint32_t rightPressStart=0, leftPressStart=0;
bool rightLong=false, leftLong=false;
bool inScrub=false;
float scrubPrev=0.5f;
const float SCRUB_DELTA_DB=0.003f, SCRUB_GAIN=1.875f; // (+25%)
const uint16_t STAG_MIN_MS = 20;
const uint16_t STAG_MAX_MS = 1000;

// Skip rainbow ON-animation once (used when wave→rainbow where rainbow was already ON)
bool g_skipRainbowOnOnce = false;

// Rainbow palette
namespace KR{
  struct RGB{ uint8_t r,g,b; };
  static const RGB RED={255,0,0}, ORANGE={255,50,0}, YELLOW={255,112,0},
                   GREEN={0,255,0}, BLUE={0,0,255}, INDIGO={75,0,130}, VIOLET={148,0,211};
  const RGB RING[7] PROGMEM = { {255,0,0}, {255,50,0}, {255,112,0}, {0,255,0}, {0,0,255}, {75,0,130}, {148,0,211} };
  static inline RGB ld(const RGB* p){ RGB o; memcpy_P(&o,p,sizeof(RGB)); return o; }
  static inline RGB mix(const RGB&a,const RGB&b,float t){ RGB o; o.r=mix8(a.r,b.r,t); o.g=mix8(a.g,b.g,t); o.b=mix8(a.b,b.b,t); return o; }
  static inline RGB colorAt(uint32_t t_ms,uint16_t HOLD,uint16_t FADE){
    uint16_t BLOCK=(uint16_t)(HOLD+FADE); uint32_t LOOP=(uint32_t)7*BLOCK;
    uint32_t t= t_ms%LOOP; uint32_t blk=t/BLOCK; uint32_t ti=t%BLOCK;
    RGB A=ld(&RING[blk]); RGB B=ld(&RING[(blk+1)%7]);
    if(ti<HOLD) return A; float u=ease01((float)(ti-HOLD)/(float)FADE); return mix(A,B,u);
  }
}
static inline float fadeStep(uint32_t t, uint16_t stag, uint16_t fadeMs, bool invert){
  int32_t local=(int32_t)t-(int32_t)stag;
  if(invert){ if(local<=0) return 1.f; if(local>=fadeMs) return 0.f; return 1.f - (float)local/(float)fadeMs; }
  else{       if(local<=0) return 0.f; if(local>=fadeMs) return 1.f; return (float)local/(float)fadeMs; }
}
static inline float ledBrightAtRainbow(uint8_t i){
  switch(brState){
    case BR_HOLD: return 1.f;
    case BR_OFF:  return 0.f;
    case BR_ON_ANIM:  return fadeStep(brT_ms, STAG_CENTER20_MS(i), 30, false);
    case BR_OFF_ANIM: return fadeStep(brT_ms, STAG_CENTER20_MS(i), 30, true );
  }
  return 1.f;
}

// ========================= NEW WAVE (integrated) =========================
namespace NewWave {
  static inline void colorDefault(uint32_t, uint8_t&, uint8_t&, uint8_t&);
  static inline void colorModifier(uint32_t, uint8_t, uint8_t&, uint8_t&, uint8_t&);
  static inline void colorRainbow(uint32_t, uint8_t, uint8_t&, uint8_t&, uint8_t&);
  static inline void colorEpic(uint32_t, int64_t, uint8_t&, uint8_t&, uint8_t&);
  static inline uint8_t brightnessAt(uint32_t);
  static inline uint8_t brightnessEpic(uint32_t);

  const uint32_t FADE_US        = 650000UL;
  const uint32_t PAUSE_US       = 860000UL;
  const uint32_t ZERO_PAUSE_US  =  20000UL;
  const uint32_t STAGGER_US     =  30000UL;
  const uint32_t CYCLE_US = FADE_US + PAUSE_US + FADE_US + ZERO_PAUSE_US;

  const uint32_t RAIN_HOLD_US = 1210000UL; // 1210 ms
  const uint32_t RAIN_FADE_US =   90000UL; //  90 ms
  const uint32_t RAIN_CYCLE_US = RAIN_HOLD_US + RAIN_FADE_US + RAIN_HOLD_US + RAIN_FADE_US;

  // EPIC timing
  const uint32_t EPIC_FLASH_US =  90000UL;
  const uint32_t EPIC_FADE1_US =  40000UL;
  const uint32_t EPIC_HOLD_US  =2550000UL;
  const uint32_t EPIC_STEPC_US =  40000UL;
  const uint32_t EPIC_CYCLE_US = EPIC_FLASH_US + EPIC_FADE1_US + EPIC_HOLD_US + EPIC_STEPC_US;

  const uint32_t EPIC_BR_FULL_A = 100000UL;
  const uint32_t EPIC_BR_FADE_D =2150000UL;
  const uint32_t EPIC_BR_ZERO_H = 430000UL;
  const uint32_t EPIC_BR_FADE_U =  40000UL;

  // EPIC colors / Modifier pairs
  const uint8_t BLUE_R=0,  BLUE_G=0,   BLUE_B=255;
  const uint8_t GREEN_R=0, GREEN_G=255, GREEN_B=0;
  const uint8_t YELL_R=255, YELL_G=130, YELL_B=0;
  const uint8_t ORNG_R=255, ORNG_G=50,  ORNG_B=0;
  const uint8_t RED_R=255,  RED_G=0,    RED_B=0;
  const uint8_t PURP_R=170, PURP_G=0,   PURP_B=255;

  static uint32_t lastRealUs = 0;
  static double   vNowUs     = 0.0;
  static double   vColorUs   = 0.0;

  static bool     running     = false;
  static bool     pendingStop = false;
  static bool     paused      = false;
  static bool     latchedReverse = false;

  static uint8_t haveLitBits[(LED_COUNT+7)/8];
  static uint8_t lockedBits [(LED_COUNT+7)/8];
  #define NW_BIT_SET(arr,i)   ( (arr)[(i)>>3] |=  (uint8_t)(1u<<((i)&7)) )
  #define NW_BIT_CLR(arr,i)   ( (arr)[(i)>>3] &= (uint8_t)~(1u<<((i)&7)) )
  #define NW_BIT_TST(arr,i)   ( ((arr)[(i)>>3] & (uint8_t)(1u<<((i)&7))) != 0 )

  static bool     finishOffThenRestart = false;
  static bool     restartWantModifier  = false;
  static bool     restartWantKey       = false;

  enum ModeSel : uint8_t { M_DEFAULT=0, M_MOD=1, M_RAINBOW=2, M_EPIC=3 };
  // 2 bits per LED (was one byte per LED)
  static uint8_t  curModeBits[(LED_COUNT+3)/4];
  static inline ModeSel getMode(uint16_t i){ return (ModeSel)((curModeBits[i>>2] >> ((i&3)*2)) & 3); }
  static inline void setMode(uint16_t i, ModeSel m){ uint8_t sh=(i&3)*2; curModeBits[i>>2]=(uint8_t)((curModeBits[i>>2] & ~(3<<sh)) | ((uint8_t)m<<sh)); }

  static inline uint8_t ease_to_byte(float u){
    if(u<0)u=0; if(u>1)u=1;
    float e = u*u*(3.f - 2.f*u);
    int v = (int)(e*255.f + 0.5f);
    if(v<0)v=0; if(v>255)v=255; return (uint8_t)v;
  }

  const float KNOB_EMA  = 0.45f;
  const float KNOB_DB   = 0.006f;
  const float SPEED_FAST_OTHER = 1.0f/8.0f;
  const float SPEED_FAST_EPIC  = 1.0f/16.0f;
  const float SPEED_SLOW_MAX   = 6.0f;
  const float KNOB_CENTER = 0.30f;
  static float lastNorm = 0.30f;

  static inline float readKnobNorm(){
    int raw = readKnobRaw();
    float norm = raw / 1023.0f;
    if (fabsf(norm - lastNorm) < KNOB_DB) norm = lastNorm;
    norm = (1.0f - KNOB_EMA) * lastNorm + KNOB_EMA * norm;
    lastNorm = norm; return norm;
  }
  static inline void snapKnob(float n){
    if (n < 0.f) n = 0.f;
    if (n > 1.f) n = 1.f;
    lastNorm = n;
  }
  static inline float mapNormToScale(float norm, bool epic){
    if (norm < KNOB_CENTER){
      float spanL = (KNOB_CENTER > 0.0f) ? KNOB_CENTER : 1.0f;
      float t = (KNOB_CENTER - norm) / spanL;
      return 1.0f + t * (SPEED_SLOW_MAX - 1.0f);
    } else if (norm > KNOB_CENTER){
      float spanR = (1.0f - KNOB_CENTER > 0.0f) ? (1.0f - KNOB_CENTER) : 1.0f;
      float fastMin = epic ? SPEED_FAST_EPIC : SPEED_FAST_OTHER;
      float t = (norm - KNOB_CENTER) / spanR;
      return 1.0f + t * (fastMin - 1.0f);
    } else return 1.0f;
  }

  static inline uint8_t brightnessAt(uint32_t t){
    if (t < FADE_US){ float u=(float)t/(float)FADE_US; return ease_to_byte(u); }
    t -= FADE_US;
    if (t < PAUSE_US) return 255; t -= PAUSE_US;
    if (t < FADE_US){ float u=(float)t/(float)FADE_US; return ease_to_byte(1.0f - u); }
    t -= FADE_US;
    if (t < ZERO_PAUSE_US) return 0;
    return 0;
  }
  static inline bool inZeroWindow(uint32_t localUs){
    uint32_t t=localUs;
    if (t < FADE_US) return false; t -= FADE_US;
    if (t < PAUSE_US) return false; t -= PAUSE_US;
    if (t < FADE_US) return false; t -= FADE_US;
    return (t < ZERO_PAUSE_US);
  }
  static inline bool inZeroWindowEpic(uint32_t localUs){
    uint32_t t=localUs;
    if (t < EPIC_BR_FULL_A) return false; t -= EPIC_BR_FULL_A;
    if (t < EPIC_BR_FADE_D) return false; t -= EPIC_BR_FADE_D;
    return (t < EPIC_BR_ZERO_H);
  }

  static inline void colorDefault(uint32_t /*tLocalUs*/, uint8_t &r, uint8_t &g, uint8_t &b){
    if (g_mode==MODE_CLASSIC){
      uint8_t rr,gg,bb;
      if(bridge.active){ uint8_t rb,gb,bb2; uint32_t hold=bridge.lastMs; bridge.update(bridge.lastMs,0.f,rb,gb,bb2); bridge.lastMs=hold; rr=rb; gg=gb; bb=bb2; }
      else             { classicColorFromKnob(g_lastKnobNorm, rr,gg,bb); }
      r=rr; g=gg; b=bb;
    }else{
      r = g_lastJumboR; g = g_lastJumboG; b = g_lastJumboB;
    }
  }

  static inline void mixColors(uint8_t aR,uint8_t aG,uint8_t aB,
                               uint8_t bR,uint8_t bG,uint8_t bB,
                               uint8_t w, uint8_t &r,uint8_t &g,uint8_t &b){
    r = (uint8_t)(((uint16_t)(255-w)*aR + (uint16_t)w*bR)/255);
    g = (uint8_t)(((uint16_t)(255-w)*aG + (uint16_t)w*bG)/255);
    b = (uint8_t)(((uint16_t)(255-w)*aB + (uint16_t)w*bB)/255);
  }
  static inline void selectModifierPair(uint8_t step, uint8_t &aR,uint8_t &aG,uint8_t &aB, uint8_t &bR,uint8_t &bG,uint8_t &bB){
    switch (step % 6){
      case 0: aR=BLUE_R;  aG=BLUE_G;  aB=BLUE_B;  bR=GREEN_R; bG=GREEN_G; bB=GREEN_B; break;
      case 1: aR=GREEN_R; aG=GREEN_G; aB=GREEN_B; bR=YELL_R;  bG=YELL_G;  bB=YELL_B;  break;
      case 2: aR=YELL_R;  aG=YELL_G;  aB=YELL_B;  bR=ORNG_R;  bG=ORNG_G;  bB=ORNG_B;  break;
      case 3: aR=ORNG_R;  aG=ORNG_G;  aB=ORNG_B;  bR=RED_R;   bG=RED_G;   bB=RED_B;   break;
      case 4: aR=RED_R;   aG=RED_G;   aB=RED_B;   bR=PURP_R;  bG=PURP_G;  bB=PURP_B;  break;
      default: aR=PURP_R; aG=PURP_G;  aB=PURP_B;  bR=BLUE_R;  bG=BLUE_G;  bB=BLUE_B;  break;
    }
  }
  static inline void colorModifier(uint32_t tLocalUs, uint8_t step, uint8_t &r, uint8_t &g, uint8_t &b){
    uint8_t aR,aG,aB,bR,bG,bB; selectModifierPair(step, aR,aG,aB, bR,bG,bB);
    uint32_t t=tLocalUs;
    const uint32_t COL_HOLD_A_US  = 500000UL;
    const uint32_t COL_XFADE_US   =1180000UL;
    const uint32_t COL_HOLD_B_US  = 500000UL;
    if (t < COL_HOLD_A_US){ r=aR; g=aG; b=aB; return; }
    t -= COL_HOLD_A_US;
    if (t < COL_XFADE_US){ uint8_t w=ease_to_byte((float)t/(float)COL_XFADE_US);
      mixColors(aR,aG,aB, bR,bG,bB, w, r,g,b); return; }
    t -= COL_XFADE_US;
    if (t < COL_HOLD_B_US){ r=bR; g=bG; b=bB; return; }
    r=bR; g=bG; b=bB;
  }

  static inline void colorRainbow(uint32_t tLocalUs, uint8_t step, uint8_t &r, uint8_t &g, uint8_t &b){
    uint8_t A1r,A1g,A1b, B1r,B1g,B1b, nextAr,nextAg,nextAb;
    switch (step % 3){
      case 0: A1r=255; A1g=  0; A1b=  0;  B1r=255; B1g= 50; B1b=  0;  nextAr=255; nextAg=130; nextAb=0; break;
      case 1: A1r=255; A1g=130; A1b=  0;  B1r=  0; B1g=255; B1b=  0;  nextAr=  0; nextAg=  0; nextAb=255; break;
      default:A1r=  0; A1g=  0; A1b=255;  B1r=170; B1g=  0; B1b=255;  nextAr=255; nextAg=  0; nextAb=  0; break;
    }
    uint32_t t=tLocalUs;
    if (t < RAIN_HOLD_US) { r=A1r; g=A1g; b=A1b; return; }
    t -= RAIN_HOLD_US;
    if (t < RAIN_FADE_US){ uint8_t w=ease_to_byte((float)t/(float)RAIN_FADE_US);
      mixColors(A1r,A1g,A1b, B1r,B1g,B1b, w, r,g,b); return; }
    t -= RAIN_FADE_US;
    if (t < RAIN_HOLD_US) { r=B1r; g=B1g; b=B1b; return; }
    t -= RAIN_HOLD_US;
    if (t < RAIN_FADE_US){ uint8_t w=ease_to_byte((float)t/(float)RAIN_FADE_US);
      mixColors(B1r,B1g,B1b, nextAr,nextAg,nextAb, w, r,g,b); return; }
    r=nextAr; g=nextAg; b=nextAb;
  }
  static inline void colorEpic(uint32_t tLocalUs, int64_t cyclesWhole, uint8_t &r, uint8_t &g, uint8_t &b){
    static const uint8_t Bcol[6][3] PROGMEM = {
      {255,  0,  0}, {255, 50,  0}, {255,130,  0},
      {  0,255,  0}, {  0,  0,255}, {170,  0,255}
    };
    static const uint8_t Ccol[6][3] PROGMEM = {
      {  0,255,  0}, {  0,  0,255}, {255,  0,  0},
      {255,  0,  0}, {255,130,  0}, {  0,  0,255}
    };
    uint8_t step = (uint8_t)(((cyclesWhole % 6) + 6) % 6);
    uint8_t C[3], Bc[3]; memcpy_P(C,Ccol[step],3); memcpy_P(Bc,Bcol[step],3);
    uint32_t t=tLocalUs;
    if (t <  EPIC_FLASH_US){ r=C[0]; g=C[1]; b=C[2]; return; }
    t -= EPIC_FLASH_US;
    if (t < EPIC_FADE1_US) { uint8_t w=ease_to_byte((float)t/(float)EPIC_FADE1_US);
      mixColors(C[0],C[1],C[2], Bc[0],Bc[1],Bc[2], w, r,g,b); return; }
    t -= EPIC_FADE1_US;
    if (t < EPIC_HOLD_US) { r=Bc[0]; g=Bc[1]; b=Bc[2]; return; }
    t -= EPIC_HOLD_US;
    if (t < EPIC_STEPC_US){ r=C[0]; g=C[1]; b=C[2]; return; }
    r=C[0]; g=C[1]; b=C[2];
  }
  static inline uint8_t brightnessEpic(uint32_t tLocalUs){
    uint32_t t=tLocalUs;
    if (t < EPIC_BR_FULL_A) return 255; t -= EPIC_BR_FULL_A;
    if (t < EPIC_BR_FADE_D) { float u=(float)t/(float)EPIC_BR_FADE_D; uint8_t w=(uint8_t)(u*255.f+0.5f); return (uint8_t)(255 - w); }
    t -= EPIC_BR_FADE_D;
    if (t < EPIC_BR_ZERO_H) return 0; t -= EPIC_BR_ZERO_H;
    if (t < EPIC_BR_FADE_U) { float u=(float)t/(float)EPIC_BR_FADE_U; return (uint8_t)(u*255.f+0.5f); }
    return 255;
  }

  static inline double pos_mod(double x, double m){ double r=fmod(x,m); if(r<0) r+=m; return r; }
  static inline int64_t floor_div(double x, double d){ return (int64_t)floor(x / d); }

  void initOnce(){ lastRealUs = micros(); vNowUs = 0.0; vColorUs = 0.0; lastNorm = 0.30f; }

  void startFresh(bool modifierOn, bool keyOn){
    running = true; pendingStop=false; paused=false; latchedReverse=false;
    vNowUs=0.0; vColorUs=0.0; lastRealUs=micros();
    memset(haveLitBits,0,sizeof(haveLitBits));
    memset(lockedBits, 0,sizeof(lockedBits));
    for (uint16_t i=0;i<LED_COUNT;i++){
      setMode(i, (keyOn && modifierOn) ? M_EPIC
                   : (keyOn ? M_RAINBOW : (modifierOn ? M_MOD : M_DEFAULT)));
    }
    strip.clear();
  }
  void requestStop(){ pendingStop = true; }
  bool isPendingStop(){ return pendingStop; }
  bool isRunning(){ return running || pendingStop; }
  void hardStop(){
    running = false;
    pendingStop = false;
    finishOffThenRestart = false;
    paused = false;
    memset(haveLitBits, 0, sizeof haveLitBits);
    memset(lockedBits, 0, sizeof lockedBits);
  }
  void scheduleFinishThenRestart(bool modifierOn, bool keyOn){
    finishOffThenRestart = true; restartWantModifier=modifierOn; restartWantKey=keyOn;
  }
  static inline bool anyLocked(){ for(uint16_t i=0;i<LED_COUNT;i++) if(NW_BIT_TST(lockedBits,i)) return true; return false; }
  void maybeFinishStop(){
    for (uint16_t i=0;i<LED_COUNT;i++){ if (!NW_BIT_TST(lockedBits,i)) return; }
    running=false; pendingStop=false; strip.clear(); strip.show();
    if (finishOffThenRestart){ finishOffThenRestart=false; startFresh(restartWantModifier, restartWantKey); }
  }

  void tickAndRender(bool modifierDesired, bool keyDesired, uint8_t whiteEdge, bool redHeld){
    if (!isRunning()) return;
    if (whiteEdge == 1) { if (redHeld) { latchedReverse = !latchedReverse; } else { paused = !paused; } }

    uint32_t nowUs = micros();
    uint32_t dtUs  = nowUs - lastRealUs;
    lastRealUs = nowUs; if (dtUs > 50000UL) dtUs = 50000UL;

    const bool epicDesired           = (keyDesired && modifierDesired);
    const bool desiredRainbowFamily  = (keyDesired || epicDesired);

    float norm  = readKnobNorm();
    float scale = mapNormToScale(norm, epicDesired);

    bool wantReverse = latchedReverse ^ redHeld;

    double baseAdvance = (double)dtUs / (double)scale;
    double signedAdvance = paused ? (redHeld ? (wantReverse ? -baseAdvance : baseAdvance) : 0.0)
                                  : (wantReverse ? -baseAdvance : baseAdvance);

    vNowUs   += signedAdvance;
    if (desiredRainbowFamily) vColorUs += signedAdvance;
    else                      vColorUs  = vNowUs;

    // Apply fader in Wave mode too
    const uint8_t f=(uint8_t)(g_fader*255.f+0.5f);

    for (uint16_t i=0;i<LED_COUNT;i++){
      if (NW_BIT_TST(lockedBits,i)) { strip.setPixelColor(i,0,0,0); continue; }

      ModeSel desired = epicDesired ? M_EPIC
                          : (keyDesired ? M_RAINBOW : (modifierDesired ? M_MOD : M_DEFAULT));

      uint16_t phys = i;
      uint32_t offsetUs = (uint32_t)phys * STAGGER_US;

      bool isRainbowNow = (desired == M_RAINBOW || desired == M_EPIC);
      double baseClock = isRainbowNow ? vColorUs : vNowUs;

      bool reached = (baseClock >= (double)offsetUs);
      if (!reached && (signedAdvance >= 0) && !NW_BIT_TST(haveLitBits,i)) { strip.setPixelColor(i,0,0,0); continue; }

      double rel = baseClock - (double)offsetUs;

      uint32_t cycleUs = (desired == M_RAINBOW) ? RAIN_CYCLE_US
                            : (desired == M_EPIC ? EPIC_CYCLE_US : CYCLE_US);

      uint32_t localUs     = (uint32_t)(pos_mod(rel, (double)cycleUs) + 0.5);
      int64_t  cyclesWhole = (int64_t)floor(rel / (double)cycleUs);

      // Zero-window check must use the LED's CURRENT mode (fix from V2, reverted in V4)
      ModeSel cm = getMode(i);
      bool zeroNow = (cm == M_EPIC) ? inZeroWindowEpic(localUs) : inZeroWindow(localUs);
      if (cm != desired && zeroNow){ cm = desired; setMode(i, cm); }

      uint8_t cr=255,cg=255,cb=255;
      uint8_t br=255;

      if (cm == M_RAINBOW) {
        uint8_t step3 = (uint8_t)(((cyclesWhole % 3) + 3) % 3);
        colorRainbow(localUs, step3, cr,cg,cb); br=255;
      } else if (cm == M_EPIC) {
        colorEpic(localUs, cyclesWhole, cr,cg,cb); br = brightnessEpic(localUs);
      } else if (cm == M_MOD) {
        uint8_t step6 = (uint8_t)(((cyclesWhole % 6) + 6) % 6);
        colorModifier(localUs, step6, cr,cg,cb); br = brightnessAt(localUs);
      } else {
        colorDefault(localUs, cr,cg,cb); br = brightnessAt(localUs);
      }

      if (br > 0) NW_BIT_SET(haveLitBits,i);

      if (pendingStop && NW_BIT_TST(haveLitBits,i)) {
        bool zeroForStop = (cm == M_EPIC) ? inZeroWindowEpic(localUs) : inZeroWindow(localUs);
        if (zeroForStop){ NW_BIT_SET(lockedBits,i); strip.setPixelColor(i,0,0,0); continue; }
      }

      // Apply brightness (br) then fader, then calibration
      uint16_t r = (uint16_t)cr * br / 255;
      uint16_t g = (uint16_t)cg * br / 255;
      uint16_t b = (uint16_t)cb * br / 255;

      r = (uint16_t)((uint16_t)r * f / 255);
      g = (uint16_t)((uint16_t)g * f / 255);
      b = (uint16_t)((uint16_t)b * f / 255);

      strip.setPixelColor(i, clamp8i((int)(r*CAL_R_GAIN+0.5f)),
                             clamp8i((int)(g*CAL_G_GAIN+0.5f)),
                             clamp8i((int)(b*CAL_B_GAIN+0.5f)));
    }

    strip.show();
    if (pendingStop) maybeFinishStop();
  }
} // namespace NewWave

// ================== Jumbo↔Rainbow handoff ==================
enum HandoverState:uint8_t{ HO_IDLE=0, HO_J2R_OFF, HO_R2J_ON };
HandoverState hoState=HO_IDLE;
uint32_t hoLastMs=0, hoT_ms=0;
static inline float ledBrightHandoff(uint8_t i, bool offPhase){
  return fadeStep(hoT_ms, STAG_CENTER8_MS(i), 30, offPhase);
}

// Shared edge tracker for the Jumbo colour cycle (was two separate function-local statics)
static bool g_seqActivePrev=false;
static inline void trackJumboSeq(uint32_t now,bool seqActive){
  if(!g_seqActivePrev && seqActive) colorSeq.onActiveRising(now);
  else if(g_seqActivePrev && !seqActive) colorSeq.onActiveFalling(now);
  g_seqActivePrev=seqActive;
}

// ================== Globals / IO ==================
DebouncedInput inJumbo,inToggle,inLeft,inRight,inKey,inWave,inChaos;

// ========= remembered framebuffer (for prerolls & dots) =========
uint8_t g_lastShownR[LED_COUNT], g_lastShownG[LED_COUNT], g_lastShownB[LED_COUNT];

static inline void setPixelRGB(uint16_t i, uint8_t r, uint8_t g, uint8_t b){
  uint8_t f=(uint8_t)(g_fader*255.f+0.5f);
  r = (uint8_t)((uint16_t)r*f/255);
  g = (uint8_t)((uint16_t)g*f/255);
  b = (uint8_t)((uint16_t)b*f/255);
  uint8_t rc = clamp8i((int)(r * CAL_R_GAIN + 0.5f));
  uint8_t gc = clamp8i((int)(g * CAL_G_GAIN + 0.5f));
  uint8_t bc = clamp8i((int)(b * CAL_B_GAIN + 0.5f));
  strip.setPixelColor(i, rc, gc, bc);
}
static inline void setPixelCalibratedRemember(uint16_t i, uint8_t r, uint8_t g, uint8_t b){
  g_lastShownR[i]=r; g_lastShownG[i]=g; g_lastShownB[i]=b;
  setPixelRGB(i,r,g,b);
}
static inline void clearFrame(){ for (uint16_t i=0;i<LED_COUNT;i++){ g_lastShownR[i]=g_lastShownG[i]=g_lastShownB[i]=0; strip.setPixelColor(i,0,0,0);} }
static inline void setPixelCalibratedNoFader(uint16_t i, uint8_t r, uint8_t g, uint8_t b){
  uint8_t rc = clamp8i((int)(r * CAL_R_GAIN + 0.5f));
  uint8_t gc = clamp8i((int)(g * CAL_G_GAIN + 0.5f));
  uint8_t bc = clamp8i((int)(b * CAL_B_GAIN + 0.5f));
  strip.setPixelColor(i, rc, gc, bc);
}

// ================== Wave pre/post rolls ==================
struct WavePreroll {
  bool active=false;
  uint32_t startMs=0;
  bool wantModifier=false, wantKey=false;

  void begin(uint32_t now, bool modifierOn, bool keyOn){
    active=true; startMs=now; wantModifier=modifierOn; wantKey=keyOn;
  }
  bool tick(uint32_t now){
    if(!active) return false;
    uint32_t t = now - startMs;
    if (t >= 800){ active=false; return false; }
    uint8_t seg = (t<400)?0:1;
    float u = ease01((float)(t - (seg?400:0)) / 400.0f);

    for (int i=0;i<LED_COUNT;i++){
      bool firstPair = ((i/2)%2==0);
      float a = (seg==0) ? (firstPair ? u : 0.f)
                         : (firstPair ? 1.f : u);
      uint8_t r = (uint8_t)((1.f - a) * g_lastShownR[i] + 0.5f);
      uint8_t g = (uint8_t)((1.f - a) * g_lastShownG[i] + 0.5f);
      uint8_t b = (uint8_t)((1.f - a) * g_lastShownB[i] + 0.5f);
      setPixelCalibratedRemember(i, r,g,b);
    }
    strip.show();
    return true;
  }
  bool anyLitBeforeStart() const {
    for(int i=0;i<LED_COUNT;i++){
      if(g_lastShownR[i]|g_lastShownG[i]|g_lastShownB[i]) return true;
    }
    return false;
  }
} g_wavePreroll;

struct WavePostrollUp {
  bool active=false;
  uint32_t startMs=0;

  enum PT:uint8_t{ PT_NONE=0, PT_RAINBOW, PT_CLASSIC, PT_JUMBO } type=PT_NONE;

  uint32_t snapPhaseMs=0;
  uint16_t snapHOLD=0, snapFADE=0, snapSTAG=0;
  uint8_t  snapCr=255, snapCg=255, snapCb=255;

  void begin(uint32_t now, bool rockerOn, bool /*toggleOn*/, bool keyOn){
    if (keyOn){
      type=PT_RAINBOW;
      // We are coming back to Rainbow that is already ON -> skip ON animation once
      g_skipRainbowOnOnce = true;
      snapPhaseMs = phaseMs;
      snapHOLD    = HOLD_MS;
      snapFADE    = FADE_MS;
      snapSTAG    = STAG_MS;
    } else if (g_mode==MODE_CLASSIC){
      type=PT_CLASSIC;
      uint8_t rc,gc,bc;
      if (bridge.active){
        uint8_t rb,gb,bb; uint32_t hold=bridge.lastMs;
        bridge.update(now, 0.f, rb,gb,bb); bridge.lastMs=hold;
        rc=rb; gc=gb; bc=bb;
      } else {
        classicColorFromKnob(g_lastKnobNorm, rc,gc,bc);
      }
      snapCr=rc; snapCg=gc; snapCb=bc;
    } else if (rockerOn){
      type=PT_JUMBO;
      colorSeq.update(now, g_speedScale);
      colorSeq.get(snapCr, snapCg, snapCb);
    } else {
      type=PT_NONE;
    }

    if (type==PT_NONE){ active=false; return; }
    for (int i=0;i<LED_COUNT;i++) setPixelCalibratedRemember(i, 0,0,0);
    strip.show();
    active=true; startMs=now;
  }

  inline void targetAt(uint16_t i, uint8_t& r,uint8_t& g,uint8_t& b){
    if (type==PT_RAINBOW){
      uint32_t LOOP = (uint32_t)7*((uint32_t)snapHOLD + (uint32_t)snapFADE);
      int32_t tLocal = wrapLoop((int32_t)snapPhaseMs - (int32_t)i*(int32_t)snapSTAG, (int32_t)LOOP);
      KR::RGB c = KR::colorAt((uint32_t)tLocal, snapHOLD, snapFADE);
      r=c.r; g=c.g; b=c.b;
    } else {
      r=snapCr; g=snapCg; b=snapCb;
    }
  }

  bool tick(uint32_t now){
    if(!active) return false;
    uint32_t t = now - startMs;
    if (t >= 800){
      for (int i=0;i<LED_COUNT;i++){
        uint8_t r,g,b; targetAt(i,r,g,b);
        setPixelCalibratedRemember(i, r,g,b);
      }
      strip.show(); active=false; return false;
    }
    uint8_t seg = (t<400)?0:1;
    float u = ease01((float)(t - (seg?400:0)) / 400.0f);

    for (int i=0;i<LED_COUNT;i++){
      bool firstPair = ((i/2)%2==0);
      float a = (seg==0) ? (firstPair ? u : 0.f)
                         : (firstPair ? 1.f : u);
      uint8_t r,g,b; targetAt(i,r,g,b);
      uint8_t R = (uint8_t)(r*a + 0.5f);
      uint8_t G = (uint8_t)(g*a + 0.5f);
      uint8_t B = (uint8_t)(b*a + 0.5f);
      setPixelCalibratedRemember(i, R,G,B);
    }
    strip.show();
    return true;
  }
} g_wavePostUp;

bool g_startPostrollPending = false;

// ---------- SECRET MODE (priority override when 4 switches ON) ----------
float g_secretEntryFader = 1.0f; // brightness snapshot at entry

static inline void secretGradientAtIndex(uint16_t i, uint8_t& r, uint8_t& g, uint8_t& b){
  namespace K = KR;
  // VIOLET, INDIGO, BLUE, GREEN, YELLOW, ORANGE, RED (in flash)
  static const K::RGB GRAD[7] PROGMEM = { {148,0,211}, {75,0,130}, {0,0,255}, {0,255,0}, {255,112,0}, {255,50,0}, {255,0,0} };
  if (LED_COUNT <= 1){ K::RGB c=K::ld(&GRAD[0]); r=c.r; g=c.g; b=c.b; return; }
  float pos = (float)i / (float)(LED_COUNT - 1);   // 0..1 bottom->top
  float f   = pos * 6.0f;                          // 6 segments between 7 stops
  int   k   = (int)f; if(k<0) k=0; if(k>5) k=5;
  float t   = f - (float)k;
  K::RGB A = K::ld(&GRAD[k]), C = K::ld(&GRAD[k+1]);
  K::RGB M = K::mix(A, C, t);
  r=M.r; g=M.g; b=M.b;
}
static inline void secretSolidFromFader(float u, uint8_t& r, uint8_t& g, uint8_t& b){
  namespace K = KR;
  // Solid sweep: BLUE -> GREEN -> YELLOW -> ORANGE -> RED -> VIOLET
  static const K::RGB STOPS[6] PROGMEM = { {0,0,255}, {0,255,0}, {255,112,0}, {255,50,0}, {255,0,0}, {148,0,211} };
  u = clamp01(u);
  float f = u * 5.0f;               // 5 segments between 6 stops
  int   k = (int)f; if(k<0) k=0; if(k>4) k=4;
  float t = f - (float)k;
  K::RGB A = K::ld(&STOPS[k]), B = K::ld(&STOPS[k+1]);
  K::RGB M = K::mix(A, B, t);
  r=M.r; g=M.g; b=M.b;
}
static inline uint8_t scaleSecret(uint8_t v){
  uint16_t s = (uint16_t)(clamp01(g_secretEntryFader)*255.f + 0.5f);
  return (uint8_t)((uint16_t)v * s / 255);
}
static inline void renderSecret(){
  int lit = (int)lrintf(g_lastKnobNorm * (float)LED_COUNT);
  if(lit < 0) lit = 0; if(lit > LED_COUNT) lit = LED_COUNT;

  const float u = clamp01(g_fader);

  const float RAINBOW_ZONE_END = 0.15f; // left edge rainbow mix
  float w = 0.0f;
  if (u <= RAINBOW_ZONE_END){
    float t = 1.0f - (u / RAINBOW_ZONE_END);
    w = ease01(t);
  }

  uint8_t sR,sG,sB; secretSolidFromFader(u, sR,sG,sB);

  for(int i=0;i<LED_COUNT;i++){
    if(i < lit){
      uint8_t R,G,B;
      if (w <= 0.0f){
        R=sR; G=sG; B=sB;
      }else if (w >= 1.0f){
        secretGradientAtIndex(i, R,G,B);
      }else{
        uint8_t gR,gG,gB; secretGradientAtIndex(i, gR,gG,gB);
        R = mix8(sR, gR, w);
        G = mix8(sG, gG, w);
        B = mix8(sB, gB, w);
      }
      uint8_t Rb = scaleSecret(R);
      uint8_t Gb = scaleSecret(G);
      uint8_t Bb = scaleSecret(B);

      setPixelCalibratedNoFader(i, Rb,Gb,Bb);
      g_lastShownR[i]=Rb; g_lastShownG[i]=Gb; g_lastShownB[i]=Bb;
    }else{
      setPixelCalibratedNoFader(i, 0,0,0);
      g_lastShownR[i]=g_lastShownG[i]=g_lastShownB[i]=0;
    }
  }
  strip.show();
}

// ========================= Dots overlay =========================
namespace Dots {
  const uint16_t BASE_IN_MS=5, BASE_HOLD_MS=30, BASE_OUT_MS=5, BASE_STAG_MS=25;
  const float L_MULT_IN=15.0f, L_MULT_HOLD=4.0f, L_MULT_OUT=15.0f, L_MULT_STAG=4.0f;
  const float R_MULT_IN=0.125f, R_MULT_HOLD=(1.0f/6.0f), R_MULT_OUT=0.125f, R_MULT_STAG=0.125f;

  uint16_t TO_CLR_TO_COL_MS=5, HOLD_COL_MS=30, TO_COL_TO_CLR_MS=5, g_staggerMs=25;
  uint16_t g_t1=5, g_t2=35, g_t3=40;

  float    g_ledsPerMs        = 1.0f / 25.0f;
  float    g_invSpeedMsPerLED = 25.0f;

  uint32_t redHoldStartMs=0; bool redHoldArmed=false, redHoldFired=false;

  struct Dot {
    uint8_t  active = 0;
    float    pos    = 0.f;
    int8_t   dir    = +1;
    uint16_t lastMs = 0;   // low 16 bits of millis(); dt is capped at 40 ms anyway
    uint8_t  r=255, g=255, b=255;
    uint16_t seq    = 0;
  };
  static const uint8_t MAX_DOTS = 16;
  Dot dots[MAX_DOTS];
  uint16_t g_seqCounter = 1;

  const uint8_t PAL[6][3] PROGMEM = {
    {170,  0,255}, {0,0,255}, {0,255,0},
    {255,130,0}, {255,50,0}, {255,0,0}
  };
  uint8_t palIdx = 0;

  static inline float clamp01f(float x){ return x<0.f?0.f:(x>1.f?1.f:x); }
  static float smoother5(float u){ u=clamp01f(u); return u*u*u*(u*(u*6.f - 15.f) + 10.f); }
  static uint16_t iroundf16(float x){ return (uint16_t)(x + 0.5f); }

  static float scaleFromT(float t, float Lmult, float Rmult){
    t = clamp01f(t);
    if (t <= 0.5f){ float u=t/0.5f; return Lmult + u*(1.0f - Lmult); }
    else { float u=(t - 0.5f)/0.5f; return 1.0f + u*(Rmult - 1.0f); }
  }
  static void updateTimingsFromKnob(){
    float t = readKnobRaw() / 1023.0f;
    uint16_t inMs   = iroundf16(BASE_IN_MS   * scaleFromT(t, L_MULT_IN,   R_MULT_IN));
    uint16_t holdMs = iroundf16(BASE_HOLD_MS * scaleFromT(t, L_MULT_HOLD, R_MULT_HOLD));
    uint16_t outMs  = iroundf16(BASE_OUT_MS  * scaleFromT(t, L_MULT_OUT,  R_MULT_OUT));
    uint16_t stagMs = iroundf16(BASE_STAG_MS * scaleFromT(t, L_MULT_STAG, R_MULT_STAG));
    if (stagMs < 1) stagMs = 1;
    if (inMs!=TO_CLR_TO_COL_MS || holdMs!=HOLD_COL_MS || outMs!=TO_COL_TO_CLR_MS || stagMs!=g_staggerMs){
      TO_CLR_TO_COL_MS = inMs; HOLD_COL_MS = holdMs; TO_COL_TO_CLR_MS = outMs; g_staggerMs = stagMs;
      g_ledsPerMs        = 1.0f / (float)g_staggerMs;
      g_invSpeedMsPerLED = (float)g_staggerMs;
      g_t1 = TO_CLR_TO_COL_MS; g_t2 = g_t1 + HOLD_COL_MS; g_t3 = g_t2 + TO_COL_TO_CLR_MS;
    }
  }
  static float kernelWeight(float dt_ms){
    if (dt_ms <= 0.f) return 0.f;
    if (dt_ms < (float)g_t1){ if (g_t1==0) return 1.f; return smoother5(dt_ms/(float)g_t1); }
    if (dt_ms < (float)g_t2) return 1.f;
    if (dt_ms < (float)g_t3){
      uint16_t fd = TO_COL_TO_CLR_MS; if (fd==0) return 0.f;
      float u=(dt_ms-(float)g_t2)/(float)fd; return 1.f - smoother5(u);
    }
    return 0.f;
  }
  static float trailFrom(float ledIndex, float headPos, int8_t headDir){
    const float stepMs = g_invSpeedMsPerLED;
    if (headDir < 0){
      if (ledIndex + 0.5f < headPos) return 0.f;
      float dist = (ledIndex - headPos);
      return kernelWeight(dist * stepMs);
    }else{
      if (ledIndex - 0.5f > headPos) return 0.f;
      float dist = (headPos - ledIndex);
      return kernelWeight(dist * stepMs);
    }
  }
  static void reflectAdvance(Dot& d, float dt_ms){
    if (dt_ms <= 0.f) return;
    const float L = (float)(LED_COUNT - 1);
    float v = (d.dir >= 0) ? +g_ledsPerMs : -g_ledsPerMs;
    float p = d.pos + v * dt_ms;
    for (uint8_t g=0; g<6; ++g){
      if (p < 0.f)   { p = -p;        d.dir = -d.dir; continue; }
      if (p > L)     { p = 2.f*L - p; d.dir = -d.dir; continue; }
      break;
    }
    if (p < 0.f) p = 0.f; else if (p > L) p = L;
    d.pos = p;
  }
  static void initDot(Dot& d, uint32_t now, int8_t dir, uint8_t r,uint8_t g,uint8_t b, uint16_t seq){
    d.active=1; d.pos=0.f; d.dir=dir; d.lastMs=(uint16_t)now; d.r=r; d.g=g; d.b=b; d.seq=seq;
  }
  static void spawnDot(uint32_t now){
    uint8_t r = pgm_read_byte(&PAL[palIdx][0]);
    uint8_t g = pgm_read_byte(&PAL[palIdx][1]);
    uint8_t b = pgm_read_byte(&PAL[palIdx][2]);
    palIdx = (uint8_t)((palIdx + 1) % 6);
    for (uint8_t i=0;i<MAX_DOTS;i++){
      if (!dots[i].active){ initDot(dots[i], now, +1, r,g,b, g_seqCounter++); return; }
    }
    initDot(dots[0], now, +1, r,g,b, g_seqCounter++);
  }
  static bool deleteOldest(){
    int8_t best=-1; uint16_t bestSeq=0xFFFFu;
    for (uint8_t i=0;i<MAX_DOTS;i++) if (dots[i].active && dots[i].seq<bestSeq){ bestSeq=dots[i].seq; best=i; }
    if (best>=0){ dots[best].active=0; return true; } return false;
  }
  static void deleteAll(){ for (uint8_t i=0;i<MAX_DOTS;i++) dots[i].active=0; }

  static inline uint8_t cal(uint8_t v, float gain){
    int x = (int)(v * gain + 0.5f); if (x<0) x=0; if (x>255) x=255; return (uint8_t)x;
  }

  void updateAndOverlay(uint32_t now, bool allowInput, uint8_t edgeLeft, uint8_t edgeRight, bool redHeld){
    updateTimingsFromKnob();

    if (allowInput){
      if (edgeRight==2){ spawnDot(now); }
      if (edgeLeft==2){ deleteOldest(); redHoldArmed=true; redHoldFired=false; redHoldStartMs=now; }
      if (redHoldArmed && redHeld && !redHoldFired){
        if (now - redHoldStartMs >= 500){ deleteAll(); redHoldFired=true; }
      }
      if (edgeLeft==1){ redHoldArmed=false; redHoldFired=false; }
    }

    const uint32_t MAX_DT = 40;
    for (uint8_t i=0;i<MAX_DOTS;i++){
      Dot& d = dots[i]; if (!d.active) continue;
      uint16_t dt = (uint16_t)((uint16_t)now - d.lastMs); d.lastMs = (uint16_t)now; if (dt > MAX_DT) dt = MAX_DT;
      reflectAdvance(d, (float)dt);
    }

    for (int i=0;i<LED_COUNT;i++){
      float prod = 1.f, accR=0.f, accG=0.f, accB=0.f;
      for (uint8_t k=0;k<MAX_DOTS;k++){
        const Dot& d = dots[k]; if (!d.active) continue;
        float w = trailFrom((float)i, d.pos, d.dir); if (w <= 0.f) continue;
        prod *= (1.f - w);
        accR += w * cal(d.r, CAL_R_GAIN);
        accG += w * cal(d.g, CAL_G_GAIN);
        accB += w * cal(d.b, CAL_B_GAIN);
      }
      float wTotal = 1.f - prod;
      uint8_t outR, outG, outB;
      if (wTotal > 0.f){
        float inv = 1.f / wTotal;
        float tr = accR * inv;
        float tg = accG * inv;
        float tb = accB * inv;
        float baseR = (float)g_lastShownR[i];
        float baseG = (float)g_lastShownG[i];
        float baseB = (float)g_lastShownB[i];
        outR = (uint8_t)(baseR*(1.f - wTotal) + tr*wTotal + 0.5f);
        outG = (uint8_t)(baseG*(1.f - wTotal) + tg*wTotal + 0.5f);
        outB = (uint8_t)(baseB*(1.f - wTotal) + tb*wTotal + 0.5f);
      } else {
        outR = g_lastShownR[i]; outG = g_lastShownG[i]; outB = g_lastShownB[i];
      }
      strip.setPixelColor(i, outR, outG, outB);
      g_lastShownR[i]=outR; g_lastShownG[i]=outG; g_lastShownB[i]=outB;
    }
    strip.show();
  }
} // namespace Dots

static inline bool dotsAllowed(bool waveOnOrRunning, bool rainbowActive){
  return (!waveOnOrRunning) && (!rainbowActive);
}
static inline void overlayDotsAndShow(uint32_t now, bool allowInput, uint8_t eL, uint8_t eR, bool redHeld){
  Dots::updateAndOverlay(now, allowInput, eL, eR, redHeld);
}

// ================== LAVA LAMP (Chaos priority) ==================
// Counts per LED. 512 is the original resolution. A longer strip uses a coarser
// scale so a toss to the centre still fits in the int16 ball position
// (largest safe apex is 256*255/2 = 32640).
#if LED_COUNT <= 1
#define LAVA_FIX_SCALE 512
#elif ((LED_COUNT - 1) * 512 <= 65280)
#define LAVA_FIX_SCALE 512
#else
#define LAVA_FIX_SCALE (65280 / (LED_COUNT - 1))
#endif
namespace Lava {
  // Physics constants (tweakable)
  static const int16_t  FIX_SCALE        = LAVA_FIX_SCALE;
  static const int16_t  GRAVITY          = -1;     // accel per step (fixed units)
  static const uint16_t BASE_INTERVAL_MS = 10;     // baseline speed @ knob center

  static const int16_t RADIUS_FIX      = (FIX_SCALE * 3) / 2; // ~1.5 LEDs radius
  static const uint8_t MAX_BRIGHTNESS  = 4;

  // Bounce “squash” (temporary smaller radius to suggest elasticity)
  static const uint8_t SQUASH_FRAMES    = 6;
  static const uint8_t SQUASH_SCALE_NUM = 4; // 80%
  static const uint8_t SQUASH_SCALE_DEN = 5;

  struct Blob {
    int16_t pos;      // distance from its own floor, fixed units
    int16_t vel;      // velocity in fixed units
    uint8_t colorIdx; // 0..6
  };
  static Blob    blobs[2];
  static uint8_t squashTimer[2];

#ifdef HOST_LAVA_HARNESS
  // Host-only peak tracker. Not compiled into the Uno sketch, so SRAM is unchanged.
  static int16_t hostPeakPos[2];
  static int16_t hostPeakVel[2];
  static uint32_t hostSteps;
  static uint32_t hostTicks;
  static const uint8_t HOST_TOSS_CAP = 96;
  static int16_t hostTossPeak[2];
  static int16_t hostTossLaunch[2];
  static uint8_t hostTossN[2];
  static int16_t hostTossPeaks[2][HOST_TOSS_CAP];
  static int16_t hostTossVels[2][HOST_TOSS_CAP];
#endif

  static const uint8_t PAL[7][3] PROGMEM = {
    {255,   0,   0},  // Red
    {170,   0, 255},  // Purple
    {  0,   0, 255},  // Blue
    {  0, 255,   0},  // Green
    {255, 112,   0},  // Yellow (warm)
    {255,  50,   0},  // Orange (hot)
    {  0,   0,   0}   // Off
  };

  // Robust knob -> speed multiplier with EMA + deadband
  static float  k_last = 0.5f;              // smoothed knob (0..1)
  static const float K_EMA = 0.35f;
  static const float K_DB  = 0.01f;

  static inline float readKnobNormSmooth(){
    float raw = readKnobRaw() / 1023.0f;
    if (fabsf(raw - k_last) < K_DB) raw = k_last;
    k_last = (1.0f - K_EMA) * k_last + K_EMA * raw;
    if (k_last < 0.f) k_last = 0.f; else if (k_last > 1.f) k_last = 1.f;
    return k_last;
  }

  // Map: left = 0.25×, center = 1×, right = 8×
  static inline float knobToMultiplier(float n){
    if (n <= 0.5f){
      float t = n / 0.5f;                   // 0..1
      return 0.25f + t * (1.0f - 0.25f);    // 0.25 → 1.0
    } else {
      float t = (n - 0.5f) / 0.5f;          // 0..1
      return 1.0f + t * (8.0f - 1.0f);      // 1.0 → 8.0
    }
  }

  // Time-accumulated stepping so 8× always shows up
  static uint32_t lastMs      = 0;
  static float    accMs       = 0.0f;       // leftover time bucket
  static float    curInterval = (float)BASE_INTERVAL_MS; // ms per physics step (dynamic)

  static inline void updateIntervalFromKnob(){
    float mult = knobToMultiplier(readKnobNormSmooth());  // 0.25× … 8×
    float interval = (float)BASE_INTERVAL_MS / mult;      // smaller interval = faster
    if (interval < 0.5f) interval = 0.5f;                 // safety clamp
    curInterval = interval;
  }

  // Distance from either end to the middle of the strip, in fixed units.
  // Capped at the largest apex that fits in int16 (V = 256).
  static inline int32_t centerReachFix(){
    if (LED_COUNT <= 1) return 0;
    int32_t h = ((int32_t)(LED_COUNT - 1) * FIX_SCALE) / 2;
    if (h > 32640) h = 32640;
    return h;
  }
  // Apex of a toss launched at V, after gravity is applied before each move, is V*(V-1)/2.
  static inline int16_t velForApex(int32_t hFix){
    if (hFix <= 0) return 1;
    int32_t lo = 1, hi = 256;
    while (lo < hi){
      int32_t mid = (lo + hi) >> 1;
      if (mid * (mid - 1) / 2 < hFix) lo = mid + 1;
      else hi = mid;
    }
    return (int16_t)lo;
  }
  // Rise, hit centre, ease down. Fractions of 255, so 255 is exactly the centre.
  // 192/255 is about 3/4 of the way there: on this 160-LED strip that is the old ~59 LED toss.
  static inline uint8_t tossSpan(uint8_t slot){
    // if/else, not a switch: avr-gcc puts a small switch table in RAM.
    uint8_t s = (uint8_t)(slot % 5);
    if (s == 0) return 192;
    if (s == 1) return 213;
    if (s == 2) return 255;
    if (s == 3) return 223;
    return 204;
  }
  // Not inline: one copy of the apex search, called a few times per bounce.
  static int16_t launchForSlot(uint8_t slot){
    return velForApex(centerReachFix() * (int32_t)tossSpan(slot) / 255);
  }
  // This integrator lands at velocity -V, where V is the launch speed.
  // The next span is the one after that V, so the five heights repeat in order.
  // millis()/900 did not: at the knob centre the flight time stayed inside one
  // 900 ms bucket and every later toss was the short one (~60 LEDs).
  static int16_t nextLaunchAfter(int16_t prev){
    for (uint8_t s = 0; s < 5; ++s){
      if (launchForSlot(s) == prev)
        return launchForSlot((uint8_t)((s + 1u) % 5u));
    }
    return launchForSlot(2); // unknown speed → the centre toss
  }

  static inline void stepBlobsOnce(){
    for (uint8_t i = 0; i < 2; ++i){
      Blob &b = blobs[i];
      int32_t vel = (int32_t)b.vel + GRAVITY;
      int32_t pos = (int32_t)b.pos + vel;

      if (pos < 0){
        int16_t prevLaunch = (int16_t)(-vel);
        b.pos = 0;
        b.vel = nextLaunchAfter(prevLaunch);
        squashTimer[i] = SQUASH_FRAMES; // trigger temporary shrink on bounce
#ifdef HOST_LAVA_HARNESS
        if (hostTossN[i] < HOST_TOSS_CAP){
          hostTossPeaks[i][hostTossN[i]] = hostTossPeak[i];
          hostTossVels[i][hostTossN[i]] = hostTossLaunch[i];
        }
        if (hostTossN[i] < 255) hostTossN[i]++;
        hostTossLaunch[i] = b.vel;
        hostTossPeak[i] = 0;
#endif
      } else {
        if (pos > 32767) pos = 32767;
        b.pos = (int16_t)pos;
        b.vel = (int16_t)vel;
        if (squashTimer[i] > 0) squashTimer[i]--;
#ifdef HOST_LAVA_HARNESS
        if (b.pos > hostTossPeak[i]) hostTossPeak[i] = b.pos;
#endif
      }
#ifdef HOST_LAVA_HARNESS
      hostSteps++;
      if (b.pos > hostPeakPos[i]) hostPeakPos[i] = b.pos;
      if (b.vel > hostPeakVel[i]) hostPeakVel[i] = b.vel;
#endif
    }
  }

  // Tail length at |vel|==256, in LEDs. Apex (|vel| near 0) draws nothing.
  // 12/256 = 3/64, so the scale multiply stays in int32.
  static const int16_t TAIL_LEDS_NUM = 3;
  static const int16_t TAIL_LEDS_DEN = 64;

  // Brightness wobble 200..255 from the LED index and the clock. No stored state.
  static inline uint8_t flameGain(uint16_t led, uint8_t ball){
    uint16_t x = (uint16_t)(led * 73u);
    x = (uint16_t)(x + (uint16_t)ball * 19u);
    uint16_t clk = (uint16_t)(millis() >> 4); // ~16 ms, slow enough to read as flame
    x = (uint16_t)(x + clk * 47u);
    x ^= (uint16_t)(x << 5);
    x ^= (uint16_t)(x >> 7);
    x ^= (uint16_t)(x << 3);
    return (uint8_t)(200u + (x & 55u));
  }
  // t = 0 beside the ball (orange), then yellow, then white. The last stretch
  // fades that white out so the tip does not end on a hard edge.
  static inline void fireAt(uint8_t t, uint8_t &cr, uint8_t &cg, uint8_t &cb){
    if (t < 80){
      cr = 255;
      cg = (uint8_t)(40u + (uint16_t)50u * t / 80u); // 40..89, orange
      cb = 0;
    } else if (t < 150){
      uint8_t u = (uint8_t)(t - 80);
      cr = 255;
      cg = (uint8_t)(90u + (uint16_t)165u * u / 70u); // 90..255, into yellow
      cb = 0;
    } else if (t < 210){
      uint8_t u = (uint8_t)(t - 150);
      cr = 255;
      cg = 255;
      cb = (uint8_t)((uint16_t)255u * u / 60u); // yellow → white
    } else {
      uint8_t u = (uint8_t)(t - 210);
      uint8_t s = (uint8_t)(255u - (uint16_t)255u * u / 45u);
      cr = s;
      cg = s;
      cb = s;
    }
  }
  static inline void addClamp(uint8_t &dst, uint8_t add){
    uint16_t s = (uint16_t)dst + add;
    dst = (s > 255u) ? 255 : (uint8_t)s;
  }

  static inline void render(){
    for (uint16_t i=0;i<LED_COUNT;i++){
      uint8_t r=0,g=0,b=0;
      uint8_t tr=0, tg=0, tb=0;
      int32_t ledFix = (int32_t)i * (int32_t)FIX_SCALE;

      for (uint8_t bi=0; bi<2; ++bi){
        Blob &blob = blobs[bi];
        if (blob.colorIdx >= 7) continue;
        uint8_t col[3]; memcpy_P(col, PAL[blob.colorIdx], 3);
        if (col[0]==0 && col[1]==0 && col[2]==0) continue;

        int32_t centerFix = (bi==0)
          ? (0 * (int32_t)FIX_SCALE + blob.pos)                         // bottom blob
          : (((int32_t)LED_COUNT - 1) * (int32_t)FIX_SCALE - blob.pos); // top blob

        if (centerFix < 0) centerFix = 0;
        int32_t maxFix = ((int32_t)LED_COUNT - 1) * (int32_t)FIX_SCALE;
        if (centerFix > maxFix) centerFix = maxFix;

        int32_t radFix = RADIUS_FIX;
        if (squashTimer[bi] > 0){ radFix = (RADIUS_FIX * SQUASH_SCALE_NUM) / SQUASH_SCALE_DEN; }

        int32_t distFix = centerFix - ledFix; if (distFix < 0) distFix = -distFix;
        uint8_t onBall = 0;
        if (distFix <= radFix){
          int32_t span  = radFix - distFix;
          uint8_t level = (uint8_t)((span * MAX_BRIGHTNESS) / radFix);
          if (level > MAX_BRIGHTNESS) level = MAX_BRIGHTNESS;
          if (level > 0){
            uint8_t pr = (uint8_t)(((uint16_t)col[0] * level) / MAX_BRIGHTNESS);
            uint8_t pg = (uint8_t)(((uint16_t)col[1] * level) / MAX_BRIGHTNESS);
            uint8_t pb = (uint8_t)(((uint16_t)col[2] * level) / MAX_BRIGHTNESS);
            // max blend so two blobs can overlap nicely; the ball replaces any trail
            r = (pr > r) ? pr : r;
            g = (pg > g) ? pg : g;
            b = (pb > b) ? pb : b;
            onBall = 1;
          }
        }
        // Strip direction: bottom pos grows toward higher LEDs; top pos grows the other way.
        if (g_fireTrail && !onBall && blob.vel != 0){
          int8_t stripDir = (blob.vel > 0) ? (int8_t)1 : (int8_t)-1;
          if (bi != 0) stripDir = (int8_t)(-stripDir);
          int16_t spd = blob.vel;
          if (spd < 0) spd = (int16_t)(-spd);
          int32_t tailFix = ((int32_t)spd * (int32_t)FIX_SCALE * TAIL_LEDS_NUM) / TAIL_LEDS_DEN;
          // Ball light ends near 3/4 of the radius. The tail starts there.
          int32_t edge = (radFix * 3) / 4;
          int32_t behind = (int32_t)stripDir * (centerFix - ledFix);
          if (tailFix >= (int32_t)FIX_SCALE / 2 && behind > edge){
            int32_t along = behind - edge;
            if (along <= tailFix){
              // Same 0..MAX_BRIGHTNESS steps as the ball. The last quarter would
              // otherwise quantize to 0 and clip the white fade, so the tip stays
              // at 1 until fireAt() itself reaches black.
              uint8_t level = (uint8_t)(((tailFix - along) * MAX_BRIGHTNESS) / tailFix);
              if (level > MAX_BRIGHTNESS) level = MAX_BRIGHTNESS;
              if (level < 1) level = 1;
              uint8_t t = (uint8_t)((along * 255) / tailFix);
              uint8_t fr, fg, fb;
              fireAt(t, fr, fg, fb);
              uint8_t gain = flameGain(i, bi);
              uint8_t pr = (uint8_t)(((uint16_t)fr * level) / MAX_BRIGHTNESS);
              uint8_t pg = (uint8_t)(((uint16_t)fg * level) / MAX_BRIGHTNESS);
              uint8_t pb = (uint8_t)(((uint16_t)fb * level) / MAX_BRIGHTNESS);
              pr = (uint8_t)((uint16_t)pr * gain / 255u);
              pg = (uint8_t)((uint16_t)pg * gain / 255u);
              pb = (uint8_t)((uint16_t)pb * gain / 255u);
              addClamp(tr, pr); addClamp(tg, pg); addClamp(tb, pb);
            }
          }
        }
      }

      // Ball colour wins on its own pixels. Overlapping trails already added into tr/tg/tb.
      if (g_fireTrail && !(r | g | b)) { r = tr; g = tg; b = tb; }
      // Remember framebuffer so Wave preroll can blend from Lava's last frame
      setPixelCalibratedRemember(i, r, g, b);
    }
    strip.show();
  }

  void init(){
    blobs[0].pos=0; blobs[0].vel=launchForSlot(2); blobs[0].colorIdx=0; // bottom, span 255, reaches centre
    blobs[1].pos=0; blobs[1].vel=launchForSlot(0); blobs[1].colorIdx=0; // top, offset so peaks don't coincide
#ifdef HOST_LAVA_HARNESS
    hostTossLaunch[0]=blobs[0].vel;
    hostTossLaunch[1]=blobs[1].vel;
    hostTossPeak[0]=hostTossPeak[1]=0;
    hostTossN[0]=hostTossN[1]=0;
#endif
    squashTimer[0]=0; squashTimer[1]=0;
    lastMs = millis();
    accMs  = 0.0f;
    updateIntervalFromKnob();
  }

  // Call while Chaos is ON
  void tick(uint8_t eLeft, uint8_t eRight, uint32_t nowMs){
#ifdef HOST_LAVA_HARNESS
    hostTicks++;
#endif
    // Button edges cycle colors (including OFF)
    if (eLeft==2){  blobs[0].colorIdx = (uint8_t)((blobs[0].colorIdx + 1) % 7); }
    if (eRight==2){ blobs[1].colorIdx = (uint8_t)((blobs[1].colorIdx + 1) % 7); }

    // Update speed interval from knob every frame (smoothed)
    updateIntervalFromKnob();

    // Time-accumulated stepping so high multipliers still advance correctly
    uint32_t dt = nowMs - lastMs; lastMs = nowMs;
    if (dt > 50u) dt = 50u;             // lag safety (don’t overrun)
    accMs += (float)dt;

    // Do as many fixed steps as needed to “catch up” (capped)
    uint8_t steps = 0;
    const uint8_t MAX_STEPS_PER_FRAME = 12;
    while (accMs >= curInterval && steps < MAX_STEPS_PER_FRAME){
      stepBlobsOnce();
      accMs -= curInterval;
      steps++;
    }

    render();
  }

  void setColorIndex(uint8_t ball, uint8_t idx){
    if (ball > 1) return;
    blobs[ball].colorIdx = (uint8_t)(idx % 7);
  }
  void cycleColor(uint8_t ball){
    if (ball > 1) return;
    blobs[ball].colorIdx = (uint8_t)((blobs[ball].colorIdx + 1) % 7);
  }
  uint8_t colorIndex(uint8_t ball){
    if (ball > 1) return 0;
    return blobs[ball].colorIdx;
  }
  void snapKnob(float n){
    if (n < 0.f) n = 0.f;
    if (n > 1.f) n = 1.f;
    k_last = n;
  }

#ifdef HOST_LAVA_HARNESS
  struct HostView {
    int16_t pos0, vel0, pos1, vel1;
    int16_t peak0, peak1;
    int16_t peakVel0, peakVel1;
    int16_t fixScale;
    int32_t centerFix;
    float interval;
    uint32_t steps, ticks;
    uint8_t tossN0, tossN1;
    int16_t openPeak0, openPeak1;
    int16_t openVel0, openVel1;
  };
  static inline HostView hostView(){
    HostView v;
    v.pos0=blobs[0].pos; v.vel0=blobs[0].vel;
    v.pos1=blobs[1].pos; v.vel1=blobs[1].vel;
    v.peak0=hostPeakPos[0]; v.peak1=hostPeakPos[1];
    v.peakVel0=hostPeakVel[0]; v.peakVel1=hostPeakVel[1];
    v.fixScale=FIX_SCALE;
    v.centerFix=centerReachFix();
    v.interval=curInterval;
    v.steps=hostSteps;
    v.ticks=hostTicks;
    v.tossN0=hostTossN[0]; v.tossN1=hostTossN[1];
    v.openPeak0=hostTossPeak[0]; v.openPeak1=hostTossPeak[1];
    v.openVel0=hostTossLaunch[0]; v.openVel1=hostTossLaunch[1];
    return v;
  }
  static inline void hostToss(uint8_t ball, uint8_t i, int16_t *peak, int16_t *vel){
    *peak = hostTossPeaks[ball][i];
    *vel = hostTossVels[ball][i];
  }
#endif
} // namespace Lava
#undef LAVA_FIX_SCALE

// Chaos from the debounced input. NC mushroom (CHAOS_ACTIVE_HIGH): pressed = HIGH,
// but an unwired D11 is also HIGH, so Chaos arms only after the pin has been LOW
// once. One byte; not a field on DebouncedInput (that would cost a byte per switch).
#if CHAOS_ACTIVE_HIGH
static uint8_t chaosSeenLow;
static inline void noteChaosLow(){ if(inChaos.stable==LOW) chaosSeenLow=1; }
static inline bool chaosOn(){ return chaosSeenLow && inChaos.pressed(); }
#else
static inline void noteChaosLow(){}
static inline bool chaosOn(){ return inChaos.pressed(); }
#endif

#include "music_mode.h"
#include "lamp_wifi.h"

// ================== Setup ==================
void setup(){
#if !defined(__AVR__)
  // Pin the pots at 0..1023. The R4 default is already 10-bit; AVR has no API.
  analogReadResolution(10);
#endif
  Serial.begin(115200);
  Serial.println(F("Spiral Lamp R4 FireTrail WiFi MIDI starting"));
  strip.begin(); strip.setBrightness(BRIGHTNESS_CAP); clearFrame(); strip.show();

  inJumbo.begin(PIN_ROCKER,true,F("Rocker"));  inToggle.begin(PIN_TOGGLE,true,F("Toggle"));
  inLeft.begin(PIN_LEFT,true,F("Red btn"));    inRight.begin(PIN_RIGHT,true,F("White btn"));
  inKey.begin(PIN_KEY,true,F("Rainbow key"));  inWave.begin(PIN_WAVE,true,F("Wave sw"));
  inChaos.begin(PIN_CHAOS,!CHAOS_ACTIVE_HIGH,F("Chaos sw"));
  noteChaosLow();

#if DEBUG_SERIAL
  Serial.print(F("Rocker ")); Serial.print(inJumbo.pressed()?F("ON"):F("OFF"));
  Serial.print(F(" | Chaos "));
#if CHAOS_ACTIVE_HIGH
  if(!chaosSeenLow) Serial.println(F("unwired (arms once D11 reads LOW)"));
  else Serial.println(inChaos.pressed()?F("ON (Lava takes over)"):F("OFF"));
#else
  Serial.println(inChaos.pressed()?F("ON (Lava takes over)"):F("OFF"));
#endif
  if(!inJumbo.pressed()) Serial.println(F("Note: strip stays dark until the rocker (D7) is ON / grounded."));
#endif

  uint32_t now=millis(); g_lastMsBright=now; colorSeq.lastMs=now; lastMs=now; brLastMs=now; hoLastMs=now;

  bool rockerOn=inJumbo.pressed();
  bool toggleOn=inToggle.pressed();
  bool keyOn=inKey.pressed();
  bool waveOn=inWave.pressed();

  g_wantOn=rockerOn;
  if(rockerOn && toggleOn && (g_mode==MODE_JUMBO)) colorSeq.onActiveRising(now);

  // Rainbow latch at boot
  if(keyOn){ brState=BR_HOLD; phaseMs=((LED_COUNT-1)*DEFAULT_STAG_MS)%loopMs(); }
  else      brState=BR_OFF;

  // Wave init
  NewWave::initOnce();
  if (waveOn){
    if (g_wavePreroll.anyLitBeforeStart()){
      g_wavePreroll.begin(now, toggleOn, keyOn); // pre-roll first; Wave will start after
    }else{
      NewWave::startFresh(toggleOn, keyOn);
    }
  }

  // Lava init
  Lava::init();
  webSetup();
  webCaptureBoot();
}

// ================== Main loop ==================
void loop(){
  uint32_t now=millis(); uint32_t dt=now-lastMs; lastMs=now;
  webPoll(now);
  Music::poll(now);
  updateSpeed(); updateFader();

  // Edges. resolveControls may replace the mode-switch edges with the
  // web picture, so Wave start and Chaos-off still animate.
  uint8_t eJ=inJumbo.update(now);
  uint8_t eT=inToggle.update(now);
  uint8_t eL=inLeft.update(now);
  uint8_t eR=inRight.update(now);
  uint8_t eK=inKey.update(now);
  uint8_t eW=inWave.update(now);
  uint8_t eC=inChaos.update(now);
#if CHAOS_ACTIVE_HIGH
  uint8_t chaosWasArmed=chaosSeenLow;   // arming edge (first LOW) is not "Chaos just turned off"
#endif
  noteChaosLow();

  bool rockerOn, toggleOn, keyOn, waveOn, chaos;
  resolveControls(now, eJ, eT, eK, eW, eC,
                  rockerOn, toggleOn, keyOn, waveOn, chaos,
                  eT, eK, eW, eC);
  static uint8_t wasMusic = 0;
  if (g_reportedMode == WM_MUSIC) {
    if (!wasMusic) {
      if (NewWave::isRunning()) NewWave::hardStop();
      brState = BR_OFF;
      hoState = HO_IDLE;
      g_wavePreroll.active = false;
      g_wavePostUp.active = false;
      g_startPostrollPending = false;
      wasMusic = 1;
    }
    Music::render(now);
    return;
  }
  if (wasMusic) {
    Music::noteLeft();
    wasMusic = 0;
  }


  // ==================== LAVA LAMP PRIORITY ====================
  if (chaos){
    // Full takeover: run Lava and return (no dots / no other modes)
    Lava::tick(eL, eR, now);
    return;
  }

  // If Chaos just turned OFF and Wave switch is ON, kick Wave's ON sequence
#if CHAOS_ACTIVE_HIGH
  bool chaosJustOff = chaosWasArmed && (eC==2 /*HIGH->LOW, already armed*/);
#else
  bool chaosJustOff = (eC==1 /*LOW->HIGH*/);
#endif
  if (chaosJustOff && waveOn){
    if (g_wavePreroll.anyLitBeforeStart()){
      g_wavePreroll.begin(now, toggleOn, keyOn);
    } else {
      if (NewWave::isPendingStop()) NewWave::scheduleFinishThenRestart(toggleOn, keyOn);
      else if (!NewWave::isRunning()) NewWave::startFresh(toggleOn, keyOn);
    }
    // fall through — next sections will preroll or run Wave as usual
  }

  // ==================== SECRET MODE PRIORITY CHECK ====================
  if (waveOn && toggleOn && rockerOn && keyOn){
    if (g_mode != MODE_SECRET){
      g_secretEntryFader = g_fader;
    }
    g_mode = MODE_SECRET;
    renderSecret();
    overlayDotsAndShow(now, /*allowInput=*/true, eL, eR, inLeft.pressed());
    return;
  } else if (g_mode == MODE_SECRET){
    g_mode = MODE_JUMBO;
  }

  // ==================== WAVE (cover takes visual priority) ====================
  if (eW==2){ // cover ON
    if (g_wavePreroll.anyLitBeforeStart()){
      g_wavePreroll.begin(now, toggleOn, keyOn);
    } else {
      if (NewWave::isPendingStop()) NewWave::scheduleFinishThenRestart(toggleOn, keyOn);
      else if (!NewWave::isRunning()) NewWave::startFresh(toggleOn, keyOn);
    }
  } else if (eW==1){ // cover OFF
    if (NewWave::isRunning()) NewWave::requestStop();
    g_startPostrollPending = true;
  }

  if (g_wavePreroll.active){
    if (!g_wavePreroll.tick(now)){
      if (NewWave::isPendingStop()) NewWave::scheduleFinishThenRestart(g_wavePreroll.wantModifier, g_wavePreroll.wantKey);
      else                          NewWave::startFresh(g_wavePreroll.wantModifier, g_wavePreroll.wantKey);
    }
    return;
  }

  if (waveOn || NewWave::isRunning()){
    // Wave takes priority (no dots overlay). Wave obeys fader now.
    NewWave::tickAndRender(toggleOn, keyOn, /*whiteEdge*/ eR, /*redHeld*/ inLeft.pressed());
    return;
  }

  if (g_startPostrollPending && !g_wavePostUp.active){
    bool backgroundWillLight = keyOn || (g_mode==MODE_CLASSIC) || rockerOn;
    if (backgroundWillLight){
      g_wavePostUp.begin(now, rockerOn, toggleOn, keyOn);
    }
    g_startPostrollPending = false;
  }

  if (g_wavePostUp.active){
    g_wavePostUp.tick(now);
    if (g_wavePostUp.type==WavePostrollUp::PT_JUMBO || g_wavePostUp.type==WavePostrollUp::PT_CLASSIC){
      overlayDotsAndShow(now, /*allowInput=*/true, eL, eR, inLeft.pressed());
    }
    return;
  }

  // ==================== (No Wave) — Original paths remain ====================
  // ===== Handover triggers =====
  if(hoState==HO_IDLE && rockerOn && (eK==2) && (brState==BR_OFF)){ hoState=HO_J2R_OFF; hoT_ms=0; hoLastMs=now; }
  uint32_t brDt=now-brLastMs; brLastMs=now;
  bool blockRainbowOn=(hoState==HO_J2R_OFF);
  BrState brPrev=brState;

  switch(brState){
    case BR_OFF:
      if(keyOn && !blockRainbowOn){
        if (g_skipRainbowOnOnce){
          // Skip ON animation once and go straight to HOLD
          brState=BR_HOLD; g_skipRainbowOnOnce=false;
        } else {
          brState=BR_ON_ANIM; brT_ms=0; phaseMs=((LED_COUNT-1)*STAG_MS)%loopMs();
        }
      }
      break;
    case BR_ON_ANIM:
      if(keyOn){ brT_ms+=brDt; if(brT_ms >= (uint32_t)STAG_CENTER20_MS(0) + 30) brState=BR_HOLD; }
      else{ brState=BR_OFF_ANIM; brT_ms=0; }
      break;
    case BR_HOLD:
      if(!keyOn){ brState=BR_OFF_ANIM; brT_ms=0; }
      break;
    case BR_OFF_ANIM:
      brT_ms+=brDt; if(brT_ms >= (uint32_t)STAG_CENTER20_MS(0) + 30) brState=BR_OFF;
      if(keyOn && brState==BR_OFF_ANIM){ brState=BR_ON_ANIM; brT_ms=0; }
      break;
  }
  if(brPrev==BR_OFF_ANIM && brState==BR_OFF){
    STAG_MS=DEFAULT_STAG_MS; HOLD_MS=DEFAULT_HOLD_MS; FADE_MS=DEFAULT_FADE_MS; enforceMinBlock();
    inScrub=false; rightLong=false; leftLong=false;
    if(rockerOn){ hoState=HO_R2J_ON; hoT_ms=0; hoLastMs=now; }
  }

  bool rainbowActive = (hoState!=HO_IDLE) || (brState==BR_ON_ANIM)||(brState==BR_HOLD)||(brState==BR_OFF_ANIM) || keyOn;

  // Secret CLASSIC only when Rainbow not active; feed sequence from buttons
  if(!rainbowActive && !webOwnsMode){ if(eL==2) pushSeqChar('l'); if(eR==2) pushSeqChar('r'); }

  // ===== 1) Handover render (center-out fade) =====
  if(hoState!=HO_IDLE){
    uint32_t hoDt=now-hoLastMs; hoLastMs=now; hoT_ms+=hoDt;

    uint8_t jr=255,jg=255,jb=255;
    if(g_mode==MODE_JUMBO){
      trackJumboSeq(now, rockerOn && toggleOn);
      colorSeq.update(now,g_speedScale); colorSeq.get(jr,jg,jb);
    }else{
      uint8_t rb,gb,bb;
      if(bridge.update(now,g_speedScale,rb,gb,bb)){ jr=rb;jg=gb;jb=bb; }
      else if(!bridge.active && toggleOn){ exitClassicToJumboAtRed(now); colorSeq.get(jr,jg,jb); }
      else{ classicColorFromKnob(g_lastKnobNorm,jr,jg,jb); }
    }

    const uint8_t f=(uint8_t)(g_fader*255.f+0.5f);
    bool offPhase=(hoState==HO_J2R_OFF);
    for(int i=0;i<LED_COUNT;i++){
      float br=ledBrightHandoff((uint8_t)i, offPhase);
      uint8_t R=(uint8_t)((uint16_t)((uint8_t)(jr*br+0.5f))*f/255);
      uint8_t G=(uint8_t)((uint16_t)((uint8_t)(jg*br+0.5f))*f/255);
      uint8_t B=(uint8_t)((uint16_t)((uint8_t)(jb*br+0.5f))*f/255);
      strip.setPixelColor(i,R,G,B);
      g_lastShownR[i]=R; g_lastShownG[i]=G; g_lastShownB[i]=B;
    }
    strip.show();

    uint32_t hoMax=(uint32_t)STAG_CENTER8_MS(0)+30;
    if(hoT_ms>=hoMax){
      if(hoState==HO_J2R_OFF){ hoState=HO_IDLE; if(keyOn){ 
        if (g_skipRainbowOnOnce){ brState=BR_HOLD; g_skipRainbowOnOnce=false; }
        else { brState=BR_ON_ANIM; brT_ms=0; phaseMs=((LED_COUNT-1)*STAG_MS)%loopMs(); }
      } }
      else                    { hoState=HO_IDLE; }
    }

    if (!rainbowActive){
      overlayDotsAndShow(now, /*allowInput=*/true, eL, eR, inLeft.pressed());
    }
    return;
  }

  // ===== 2) Rainbow active path =====
  if(rainbowActive){
    bool leftDown=inLeft.pressed(), rightDown=inRight.pressed(), bothDown=leftDown && rightDown;
    if((eR==2)){ rightPressStart=now; rightLong=false; }
    if((eL==2)){  leftPressStart=now;  leftLong=false; }
    bool interactive=(brState==BR_ON_ANIM)||(brState==BR_HOLD);

    // Scrub mode (both held)
    if(interactive && bothDown && !inScrub){ inScrub=true; scrubPrev=readKnobRaw()/1023.f; rightLong=leftLong=false; }
    else if((!interactive || !bothDown) && inScrub){ inScrub=false; }

    // Long holds
    if(interactive){
      if(leftDown && !rightDown){
        if(!leftLong && (now-leftPressStart>=LONG_HOLD_MS)) leftLong=true;
        if(leftLong){ uint16_t step=(uint16_t)((float)dt*0.35f);
          HOLD_MS=(HOLD_MS>step)?(uint16_t)(HOLD_MS-step):0; FADE_MS=(FADE_MS>step)?(uint16_t)(FADE_MS-step):0; enforceMinBlock(); }
      }
      if(rightDown && !leftDown){
        if(!rightLong && (now-rightPressStart>=LONG_HOLD_MS)) rightLong=true;
        if(rightLong){ uint16_t step=(uint16_t)((float)dt*0.35f);
          HOLD_MS=addClamped(HOLD_MS,step,MAX_TIME_MS); FADE_MS=addClamped(FADE_MS,step,MAX_TIME_MS); enforceMinBlock(); }
      }
    } else { rightLong=false; leftLong=false; }

    // Tap adjusts on release (skip if both held)
    if(interactive && !bothDown){
      if((eR==1) && !rightLong){
        if(toggleOn){ STAG_MS = clampU16((uint16_t)(STAG_MS+20), STAG_MIN_MS, STAG_MAX_MS); }
        else{ HOLD_MS=addClamped(HOLD_MS,10,MAX_TIME_MS); FADE_MS=addClamped(FADE_MS,10,MAX_TIME_MS); enforceMinBlock(); }
      }
      if((eL==1) && !leftLong ){
        if(toggleOn){ STAG_MS = clampU16((uint16_t)(STAG_MS>=20?STAG_MS-20:0), STAG_MIN_MS, STAG_MAX_MS); }
        else{ HOLD_MS=(HOLD_MS>=10)?(uint16_t)(HOLD_MS-10):0; FADE_MS=(FADE_MS>=10)?(uint16_t)(FADE_MS-10):0; enforceMinBlock(); }
      }
    }else{
      if(eR==1) rightLong=false;
      if(eL==1) leftLong=false;
    }

    // Play vs Scrub (toggle modifier: 2× speed & reverse)
    uint32_t LOOP=loopMs();
    if(inScrub){
      float raw=readKnobRaw()/1023.f;
      float delta=raw-scrubPrev;
      if(fabsf(delta)>SCRUB_DELTA_DB){
        int32_t dMs=(int32_t)(delta*(float)LOOP*SCRUB_GAIN);
        phaseMs=(uint32_t)wrapLoop((int32_t)phaseMs + dMs, (int32_t)LOOP);
        scrubPrev=raw;
      }
    }else if(interactive){
      float scale = toggleOn ? (-2.0f*g_speedScale) : (g_speedScale);
      int32_t adv=(int32_t)lrintf((float)dt*scale);
      phaseMs=(uint32_t)wrapLoop((int32_t)phaseMs + adv, (int32_t)LOOP);
    }

    // Render Rainbow with fader
    const uint8_t f=(uint8_t)(g_fader*255.f+0.5f);
    for(int i=0;i<LED_COUNT;i++){
      int32_t tLocal = wrapLoop((int32_t)phaseMs - (int32_t)i*(int32_t)STAG_MS, (int32_t)LOOP);
      KR::RGB c = KR::colorAt((uint32_t)tLocal, HOLD_MS, FADE_MS);
      float br  = ledBrightAtRainbow((uint8_t)i);
      uint16_t R=(uint16_t)((uint8_t)(c.r*br+0.5f));
      uint16_t G=(uint16_t)((uint8_t)(c.g*br+0.5f));
      uint16_t B=(uint16_t)((uint8_t)(c.b*br+0.5f));
      R = (uint16_t)(R * f / 255);
      G = (uint16_t)(G * f / 255);
      B = (uint16_t)(B * f / 255);
      strip.setPixelColor(i,
        clamp8i((int)(R*CAL_R_GAIN+0.5f)),
        clamp8i((int)(G*CAL_G_GAIN+0.5f)),
        clamp8i((int)(B*CAL_B_GAIN+0.5f)));
      g_lastShownR[i]=(uint8_t)R; g_lastShownG[i]=(uint8_t)G; g_lastShownB[i]=(uint8_t)B;
    }
    strip.show();
    return;
  }

  // ===== 3) Jumbo (and Classic) path =====
  g_wantOn=rockerOn;

  if(g_seqMatched){ if(!toggleOn) enterClassic(now); g_seqMatched=false; }
  if(g_mode==MODE_CLASSIC && eT==2){
    uint8_t rc,gc,bb; classicColorFromKnob(g_lastKnobNorm,rc,gc,bb); bridge.start(rc,gc,bb,now);
  }

  { uint32_t d=now-g_lastMsBright; g_lastMsBright=now; float ds=d*g_speedScale;
    float target=g_wantOn ? (float)SEQ_TOTAL_MS : 0.0f;
    if(g_progressMs<target){ g_progressMs+=ds; if(g_progressMs>target) g_progressMs=target; }
    else if(g_progressMs>target){ g_progressMs-=ds; if(g_progressMs<target) g_progressMs=target; }
  }
  const float jProg = clampJumboProgress(g_progressMs);

  uint8_t r=255,g=255,b=255;
  if(g_mode==MODE_CLASSIC){
    uint8_t rb,gb,bb;
    if(bridge.update(now,g_speedScale,rb,gb,bb)){ r=rb; g=gb; b=bb; }
    else if(!bridge.active && toggleOn){ exitClassicToJumboAtRed(now); colorSeq.get(r,g,b); }
    else{ classicColorFromKnob(g_lastKnobNorm,r,g,b); }
  }else{ // MODE_JUMBO
    trackJumboSeq(now, rockerOn && toggleOn);
    colorSeq.update(now,g_speedScale); colorSeq.get(r,g,b);
  }

  if (g_mode==MODE_JUMBO){ g_lastJumboR=r; g_lastJumboG=g; g_lastJumboB=b; }

  const uint8_t f=(uint8_t)(g_fader*255.f+0.5f);
  for(int i=0;i<LED_COUNT;i++){
    uint16_t vF=(uint16_t)jumboBrightAt(jProg,i)*f/255;
    uint8_t R=(uint8_t)((uint16_t)r*vF/255);
    uint8_t G=(uint8_t)((uint16_t)g*vF/255);
    uint8_t B=(uint8_t)((uint16_t)b*vF/255);
    strip.setPixelColor(i,R,G,B);
    g_lastShownR[i]=R; g_lastShownG[i]=G; g_lastShownB[i]=B;
  }
  overlayDotsAndShow(now, /*allowInput=*/true, eL, eR, inLeft.pressed());
}
