tbellenger/button-lamp/sketches/MatrixLamp_R4_Wifi/ota_ca.h

// ISRG Root X1, the trust anchor for release-assets.githubusercontent.com.
// Bridge firmware 0.6.0's OTA download uses WiFiClientSecure with the
// Amazon root baked into Arduino_ESP32_OTA unless setCACert replaces it.
// openssl s_client against that host (November 2026) verifies with this
// root: leaf *.github.io, Let's Encrypt YR1, ISRG Root YR, ISRG Root X1.
#pragma once

static const char OTA_CA_PEM[] =
R"PEM(-----BEGIN CERTIFICATE-----
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
-----END CERTIFICATE-----
)PEM";
