tbellenger/button-lamp/sketches/SpiralLamp_R4_FireTrail_WiFi_MIDI/secrets.example.h

// Copy this file to secrets.h (same folder) and put the home network in it.
// secrets.h is listed in .gitignore. Do not commit real WiFi credentials.
#pragma once

#define WIFI_SSID "your-ssid"
#define WIFI_PASS "your-password"

// Optional Mac running Audio MIDI Setup. "0.0.0.0" means do not invite;
// add the lamp from the Mac (its IP, port 5004) instead.
#define MAC_SESSION_IP "0.0.0.0"
