tbellenger/button-lamp/(commit log)

2026-10-17 Add spiral lamp sketches, wiring docs, and purchased plans.
    Keep the bench-test and cleaned full sketch, the current wiring notes, and the original purchased files, and ignore macOS and Arduino build output.
    [Enclosure.stl, Spiral (with base).stl, Spiral End Cap.stl, Switch Panel.stl]
2026-10-17 Add bench test v2: pots and all panel switches, step-by-step guide
2026-10-17 Arm Chaos only after D11 has been seen LOW
    The mushroom is wired on its NC contacts, so a press opens D11 and the
    pull-up reads HIGH. CHAOS_ACTIVE_HIGH is 1. An unwired D11 also reads
    HIGH, so Lava stays off until the pin has been debounced LOW once. That
    latch is one byte, not a field on every switch. The first LOW does not
    count as Chaos turning off, so Wave does not restart when the mushroom
    is first wired.
    Uno compile: globals 1236 -> 1237 B. After the 432 B strip buffer, about
    379 B remain for the stack.
2026-10-18 Add plywood enclosure plan and tube spiral holder. (#1)
    The BTF FCOB 160/m 5 mm strip is cut to 900 mm / 144 LEDs so LED_COUNT stays 144, held in the 13 mm JARBIH silicone tube.
    [bottom_block_x6.stl, clip_fit_test_tube13mm.stl, cutlist.csv, end_cap_tube13mm.stl, spiral_cage_tube13mm.stl, top_backer_plate.stl]
2026-10-19 Drive the lamp from the full 160-LED strip (#2)
    * Set the lamp to the full 160-LED FCOB strip.
    Tom's 5 mm strip was cut long, so the Uno sketches, power notes, and coil length now use 160 LEDs on the 5 V 3 A supply. Brightness stays capped at 50, about 1.9 A.
    * Scale the lava bounce so the highest toss reaches centre.
    Launch speed is derived from LED_COUNT. Peak height varies, and the strongest toss reaches the middle of the strip. Globals stay at 1293 bytes.
    ---------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
    [spiral_cage_tube13mm.stl]
2026-10-19 Stop lava bounces phase-locking short of centre (#3)
    The centre speed knob made each flight land in the same millis()/900
    bucket, so after the opening toss every bounce stayed near LED 60.
    Advance the toss span from the landing speed instead. A host harness
    under tools/lava_harness runs the sketch and records both balls peaking
    at 79.61 LEDs (visible LED 80) at every speed pot when the fader is up.
    Uno globals stay 1293 bytes.
    [Arduino.h, SpiralLamp_clean.ino, harness.cpp]
2026-10-19 Add a fire tail to the lava balls in SpiralLamp_v2 (#4)
    * Add a velocity-scaled fire tail behind the lava balls.
    The tail is drawn from each ball's position and velocity: white-yellow
    beside the ball, then orange, then red, gone at the apex. No per-LED
    buffer. LAVA_FIRE_TRAIL turns it off. The host harness prints rise,
    apex and fall frames.
    * Move the lava fire tail into SpiralLamp_v2.
    SpiralLamp_clean stays the known-good sketch from main. v2 is that
    sketch plus the tail. The host harness builds v2 by default and can
    still build clean.
    ---------
    Co-a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
2026-10-19 Port SpiralLamp_v2 to the Uno R4 WiFi. (#5)
    SpiralLamp_R4_v0 keeps the same pins, modes, and lava fire trail.
    AVR flash helpers are guarded, the pots stay 10-bit, and the strip
    pin macro no longer clashes with the R4 onboard LED. clean and v2
    are unchanged.
    [Arduino.h]
2026-10-19 Reverse the lava fire-trail colours. (#6)
    Orange sits beside the ball, then yellow, then white at the far end.
    The tip still fades out. SpiralLamp_clean is unchanged.
    [SpiralLamp_v2.ino, harness.cpp]
2026-10-21 Add plywood control-slope and sheet-metal enclosure designs. (#7)
    The finger-joint birch v2 slope carries the printed panel's 11 cut-outs, with the ordered S7872337 set and a retrofit faceplate kept. The sheet-metal set is a bent hood, cheeks, and bottom in 0.063 in aluminium and 0.059 in mild steel.
    [cutlist.csv, fj125_back_qty1_mm.dxf, fj125_back_v2_qty1_mm.dxf, fj125_bottom_qty1_mm.dxf, fj125_control_slope_qty1_mm.dxf, fj125_faceplate_qty1_mm.dxf, fj125_front_qty1_mm.dxf, fj125_side_qty2_mm.dxf]
2026-10-21 Add the R4 WiFi page and AppleMIDI Music mode, and name sketches by features. (#8)
    SpiralLamp_<Board>_<FeatureTags> replaces the old folder names, with fixes staying in place. The new R4 sketch serves a phone page and drives Music from rtpMIDI on UDP 5004.
    [Arduino.h, SpiralLamp_R3_Base.ino, SpiralLamp_R3_FireTrail.ino, SpiralLamp_R4_FireTrail_WiFi_MIDI.ino, bench_test_v2.ino, harness.cpp, lamp_wifi.h]
2026-10-25 Add MatrixLamp_R4_Wifi for the onboard 12x8 matrix. (#9)
    Scroll the WiFi IP, then play 10 seconds of 4-bit fire, and repeat.
    A posted frame replaces the fire in that slot and shows immediately.
    Core 1.6.0's matrix library is 1-bit, so grayscale is a Bresenham
    scan on the library pin map.
    [MatrixLamp_R4_Wifi.ino, secrets.example.h]
2026-10-25 Play posted matrix animations and wait for a real DHCP address. (#10)
    MatrixLamp accepts up to 16 frames on /api/animation (and frames on /api/frame), plays them in the 10s slot, and still treats a single posted frame as mode custom. Fire cools toward a dark top. Both WiFi sketches stay joining until localIP() is non-zero and wait 22s before another begin(), so 0.0.0.0 is not latched. The matrix scan is 24 kHz so the modem UART is not starved.
2026-10-25 Add the 16×16 WS2812B matrix top-deck mount. (#11)
    Support-free printable housing, baffle, and base that swap onto the 3" 4-bolt deck, with a README pointer from the enclosure section.
    [matrix_16x16_baffle_insert.3mf, matrix_16x16_baffle_insert.stl, matrix_16x16_base_mount.3mf, matrix_16x16_base_mount.stl, matrix_16x16_housing.3mf, matrix_16x16_housing.stl]
2026-10-25 Widen the matrix fire and answer .local names over mDNS. (#12)
    The bottom row stays a hot ember bed, flame bodies rise a few columns wide, and a rare lick reaches the top row. A small WiFiUDP responder answers matrixlamp.local and matrix-lamp.local, and the same pair for the spiral lamp, without blocking the loop.
2026-10-26 MatrixLamp_R4_Wifi: 128 frames, nibble packing, hex rows & binary uploads (#13)
    Store each 12x8 frame as 48 nibble-packed bytes so 128 frames use less SRAM than the old pair of 6 KB buffers. JSON still takes number arrays and also 12-digit hex rows and 96-character hex strings. POST /api/animation accepts a raw 48-byte-per-frame packet, and GET /api/state streams frames as hex while leaving leds as an 8x12 integer array.
2026-10-31 Rework MatrixLamp for the 16x16 WS2812B panel. (#14)
    Drop the animation upload and the nibble frame store. Fire, solid colour,
    and rainbow run on the D6 panel, with a spiral-style web panel, a brightness
    cap of 40, and one-click upload scripts. The onboard 12x8 matrix still
    scrolls the IP.
    [MatrixLamp_R4_Wifi.ino, matrix_fire.h]
2026-11-01 Put the spiral lamp's panel and modes on the 16x16. (#15)
    The Matrix Lamp page is the printed control panel: arcade buttons, key,
    mushroom, rocker, toggles, fader and knob, in the measured layout. Those
    switches select the same modes as the spiral lamp. With every switch off,
    the panel plays the matrix fire.
2026-11-01 Add Metaballs and Plasma modes to MatrixLamp (#16)
    * Add Metaballs and Plasma modes to the matrix lamp.
    Both latch from an arcade code while every switch is off, so they do not
    collide with Classic. In Metaballs, red adds a blob and white removes one.
    In Plasma, red zooms in and white zooms out. The speed knob drives both,
    and the fader stays brightness. D8 and D4 match the spiral lamp.
    * Add a Sun Radiation mode next to Metaballs and Plasma.
    It latches from the idle arcade code rrrllrrr. Red grows the sun and
    white shrinks it. Those presses stay out of the code buffer, the knob
    is the pulse speed, and the fader stays br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
    [MatrixLamp_R4_Wifi.ino, matrix_modes.h]
2026-11-01 Add a rear Arduino UNO R4 WiFi bay for the 16x16 matrix housing. (#18)
    The new enclosure keeps the original bezel, baffle and lamp bolt pattern, and adds a support-free shell, cover and desk stand sized from the official ABX00087 hole drawing.
    [matrix_16x16_arduino_cover.3mf, matrix_16x16_arduino_cover.stl, matrix_16x16_arduino_housing.3mf, matrix_16x16_arduino_housing.stl, matrix_16x16_arduino_shell.3mf, matrix_16x16_arduino_shell.stl, matrix_16x16_baffle_insert.3mf, matrix_16x16_baffle_insert.stl]
2026-11-01 Add WiFi firmware updates for the matrix lamp. (#19)
    The Uno R4 WiFi sketch stores the network and OTA password in data flash, so a GitHub build with no secrets.h keeps the lamp online. A password-protected POST streams the .bin into ArduinoOTA's Renesas staging area and reboots only when the image is complete. USB upload stays the default; ota sends the same file over WiFi, and the phone page can upload a file or pull the GitHub release.
    [MatrixLamp_R4_Wifi.ino, lamp_creds.h, lamp_ota.h, secrets.example.h]
2026-11-01 Fix the GitHub OTA hang after the progress bar fills. (#20)
    ArduinoOTA 1.1.1 erases one code-flash block past the staged image, which is the new vector table, then resets into a blank sketch. Copy the image with the block count that matches the file and reset ourselves. Stop waiting for the TLS socket to close, and show red, white, or blue so a failed update returns to the running lamp.
    [MatrixLamp_R4_Wifi.ino, lamp_ota.h]
2026-11-01 Stack the ElectroCookie terminal shield in the matrix rear bay. (#21)
    The Uno R4 bay now holds EC_PS_UNO_TB_V1 on stacking headers, with 15 mm above the terminals and exits for the matrix leads and the D8/D4 button wires.
    [matrix_16x16_arduino_cover.3mf, matrix_16x16_arduino_cover.stl, matrix_16x16_arduino_shell.3mf, matrix_16x16_arduino_shell.stl]
2026-11-07 Add a support-free spiral mount for the silicone LED tube. (#22)
    The base bolts to the existing M3 deck holes and ramps four C-clips up the first turn. Identical saddle clips hold alternating turns of the 13 mm tube, eight of them for the 1000 mm strip.
    [spiral_tube_base.3mf, spiral_tube_base.stl, spiral_tube_clip.3mf, spiral_tube_clip.stl]
2026-11-08 Move the box into container and the light mounts into light mount.
    Plywood and sheet metal stay together under container/. Printed mounts, including the original one-piece 13 mm cage, live under light mount/. The cage generator stays in container/plywood/src so the backer plate and the cage do not fork.
    [bottom_block_x6.stl, clip_fit_test_tube13mm.stl, cutlist.csv, end_cap_tube13mm.stl, fj125_back_qty1_mm.dxf, fj125_back_v2_qty1_mm.dxf, fj125_bottom_qty1_mm.dxf, fj125_control_slope_qty1_mm.dxf]
2026-11-08 Stackable cross mount at 43.5 mm radius, and a Ø15 light-cable hole (#25)
    * Replace the loose clips with stackable crosses and open the light-cable hole to 15 mm.
    The coil centre-line radius is 43.5 mm. Each level is two flat-printed crosses joined by a half-lap, with a spacer carrying the next level. The deck, hood, backer, and templates go from Ø10 to Ø15, and the mount window goes from Ø14 to Ø19.
    * Drop bytecode that was committed with the mount.
    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
    [cutlist.csv, fj125_top_qty1_mm.dxf, sm_al063_hood_qty1_mm.dxf, sm_ms059_hood_qty1_mm.dxf, spiral_base.3mf, spiral_base.stl, spiral_cap.3mf, spiral_cap.stl]
2026-11-08 Add a four-tower spiral as a separate mount (#27)
    * Add a four-tower spiral as a separate mount.
    The ring bolts to the deck. Four side-printed towers carry the clips, and a cap holds their tops on the circle. This does not replace the cross mount.
    * Slim the four-tower ribs so the coil centre stays open.
    The running member is 6.0 mm radial by 3.2 mm tangential. The foot, clips, and cap hoop stay local. rib_radial is the first slider to raise if a trial print flexes.
    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
    [tower_0.3mf, tower_0.stl, tower_180.3mf, tower_180.stl, tower_270.3mf, tower_270.stl, tower_90.3mf, tower_90.stl]
2026-11-08 Replace the four-tower pins with one shared slot. (#28)
    The rib drops into the same 6.2 by 3.4 mm opening on the ring and the cap. Recessed 1–4 mark which tower matches which slot, and the feet are glued after a dry fit.
    [tower_0.3mf, tower_0.stl, tower_180.3mf, tower_180.stl, tower_270.3mf, tower_270.stl, tower_90.3mf, tower_90.stl]
2026-11-08 Widen each clip spoke to the tower and bevel the joint. (#29)
    The spoke is now 6 mm along the tower, across the whole rib, with a 3 mm 45 degree gusset added where it meets the tower. The tube centre, bore, and mouth stay put.
    [tower_0.3mf, tower_0.stl, tower_180.3mf, tower_180.stl, tower_270.3mf, tower_270.stl, tower_90.3mf, tower_90.stl]
2026-11-08 Revert "Widen each clip spoke to the tower and bevel the joint. (#29)"
    This reverts commit 700dcfafabcd59bd22f47825ac01d7cd80b495eb.
    [tower_0.3mf, tower_0.stl, tower_180.3mf, tower_180.stl, tower_270.3mf, tower_270.stl, tower_90.3mf, tower_90.stl]
2026-11-08 Slope the clip spoke from the clip down to the rib (#31)
    * Slope the clip spoke down to the tower in the print-up direction.
    The 4 mm outline is unchanged. The top of the spoke falls from 14 mm at the clip to 3.2 mm at the rib, with the underside on the bed.
    * Carry the spoke slope across the rib to the far face.
    The top still falls from 14 mm at the clip to 3.2 mm, and that low end is now the face of the rib away from the clip. The 4 mm outline is unchanged.
    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
    [tower_0.3mf, tower_0.stl, tower_180.3mf, tower_180.stl, tower_270.3mf, tower_270.stl, tower_90.3mf, tower_90.stl]
2026-11-10 Stand the matrix picture upright and draw a diagonal rainbow. (#32)
    PANEL_ROTATE is 1 so the ember row sits on the bottom of the desk stand
    instead of the right-hand column. Rainbow hue follows the diagonal, not
    the serpentine pixel index. Speed, brightness, and the reverse toggle
    stay as they were.
    [MatrixLamp_R4_Wifi.ino, matrix_modes.h]
2026-11-10 Finish GitHub OTA at the redirect URL instead of the policy header (#34)
    * Stop the GitHub update from dying inside the redirect header.
    A 302 from github.com carries the signed asset URL and then a 4 KB
    Content-Security-Policy. The reader waited for the blank line after that
    policy, the modem stalled, and the phone only saw a closed socket. Keep
    the Location line, close that TLS socket, and fetch the asset. Flush the
    POST reply before the fetch, and show the real ota state instead of
    calling a dropped connection a reboot.
    * Keep the phone upload alive across the staging erase.
    A 122672 byte image fits the 122880 byte st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
    [MatrixLamp_R4_Wifi.ino, lamp_ota.h]
2026-11-11 Upright fire, eight presets, and a sturdier GitHub check (#35)
    * Stand the fire upright and slim the lamp to eight presets.
    PANEL_ROTATE is 3 so flames rise from the bottom of the stand. The page
    is brightness, speed, and preset buttons only. Jumbo, classic, the waves,
    secret, lava, and music are gone. Spiral, fluid, and a heartbeat are in.
    There is no knob or button on this lamp. The last preset, brightness, and
    speed sit in the data-flash block after the WiFi credentials. GitHub
    check retries the TLS connect, refuses an image over 122880 bytes, and
    shows the release version before anything is erased.
    * Add Meatballs bal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
2026-11-11 Thicken the spiral tip and reverse its spin. (#36)
    The arm stays thin beside the bright centre and opens into a full
    round end. It still turns once every 9 seconds, the other way, and
    Speed still only shifts the hue.
    [MatrixLamp_R4_Wifi.ino, matrix_modes.h]
2026-11-11 MatrixLamp_R4_Wifi: run OTA copy from RAM so updates can't brick the board
2026-11-11 Saturate the spiral and fill the field with its hue. (#37)
    The arm is full saturation, like the rainbow, and the core stays that
    colour instead of washing out. Pixels off the arm use the same hue at
    about 15% brightness. Speed still only shifts the hue.
2026-11-11 Match the spiral to Tom's thick Archimedean photo. (#38)
    The arm is one and a half turns with a constant pitch and a Gaussian
    falloff, cyan at the outer end and violet at the inner end. Speed slides
    that whole range. The gaps stay a dim version of the nearby hue.
2026-11-11 Reset the WiFi modem before joining after an OTA reboot. (#39)
    An AIRCR reset restarts only the RA4M1. A leftover OK from the GitHub
    download makes the first SOFTRESETWIFI look finished, so the ESP32-S3
    keeps the old port-80 socket and the new server never accepts. Boot now
    resets the modem until a firmware-version reply is real, and a failed
    listen or a stuck join resets it again.
    [MatrixLamp_R4_Wifi.ino]
2026-11-11 Line up the Arduino shell screws after the shell is turned over. (#33)
    The housing holes move to where the existing shell screws land, and the cover holes and lip notches follow that same tumble. The shell STL is unchanged.
    [matrix_16x16_arduino_cover.3mf, matrix_16x16_arduino_cover.stl, matrix_16x16_arduino_housing.3mf, matrix_16x16_arduino_housing.stl]
2026-11-11 Draw the spiral as two arms a half turn apart. (#40)
    The photo is a double spiral. Each arm still runs violet to cyan with
    the same Gaussian and the same spin, and the pitch is opened to about
    9.2 px per turn so the dark gap between the arms stays narrow.
2026-11-11 MatrixLamp_R4_Wifi: double spiral and frame pacing
    Frames follow elapsed time instead of one step per visit, and an online
    WiFi poll is a single modem command. The spiral distance loop is integer
    with a Gaussian table, and sine, sun geometry, and the heart beat no
    longer call libm once per pixel. /stats reports fps and frame time.
2026-11-11 Rejoin the station after OTA and from the setup AP. (#44)
    AT+RESET restarts the ESP32-S3, which SOFTRESETWIFI does not, so the
    default SoftAP at 192.168.4.1 is not treated as a joined network.
    The setup form only reports success after the credential block reads
    back, and the reboot still happens if the phone drops the socket.
    [MatrixLamp_R4_Wifi.ino, lamp_creds.h, lamp_ota.h]
2026-11-11 Add a Matrix preset of falling green rain. (#43)
    Each column drops a near-white head with a fading green tail. Speed
    changes how fast the rain falls, on the same elapsed-time frame clock.
2026-11-11 Match Matrix rain to Tom's light-green sample. (#45)
    The head is light green, the tail is pure green, and the whole field
    fades each step so drops leave a decaying trail. Speed still sets the fall.
2026-11-12 Add Lightning preset to MatrixLamp_R4_Wifi (#49)
    The bolt is a baked 16x16 mask in logical picture space: 38 outline
    LEDs and 50 interior LEDs at half brightness, with the Good Vibes
    gradient scrolling along the shaft. Speed only changes that scroll.
2026-11-12 Mirror the Lightning bolt mask on the vertical axis. (#50)
    Flip kBoltRole and kBoltAlongQ16 so each column x moves to column
    15-x. The physical panel was showing the preset mirrored.
    [matrix_modes.h]
2026-11-12 Lightning preset: hollow dim rings (#51)
    Replace the solid fill with a 1px dim inner ring + 1px dim outer ring around the bright gradient outline, caps pulled in one LED, in main's mirrored orientation. .bin 118348 B.
    [matrix_modes.h]
2026-11-12 Fix OTA/WiFi boot: clean ESP32 reset + restore saved mode (#52)
    setup() resyncs the ESP32-S3 before WiFi.begin and waits for a real station IP; prefsLoad() reads MLP2 byte-at-a-time and preset is re-saved before OTA. .bin 118604 B.
    [MatrixLamp_R4_Wifi.ino, lamp_creds.h, lamp_ota.h]
2026-11-12 Add an Off preset to MatrixLamp_R4_Wifi (#53)
    Off paints every LED black except logical (0, 15), a dim yellow pixel.
    The authored colour is (6, 6, 0). NeoPixel brightness would shift that
    to zero, so each lit channel is raised to the smallest value show()
    still keeps. Speed is ignored. Saved MLP2 mode ids accept 10.
2026-11-13 Add MatrixLamp weather radar and GitHub-only updates (#54)
    * Add MatrixLamp radar and make GitHub the only firmware update.
    The 16x16 can show a north-up NEXRAD loop, and auto-switch to it while rain is nearby. Local .bin upload is gone, so that flash stays under the 122880 byte cap. Update checks compare manifest.json version to FW_VERSION, and the latest release rewrite drops stale notes and assets.
    * Draw the radar home marker as mid-grey on top of the rain.
    Logical (7,7) is painted last in every radar frame, including empty ones. The colour is 128,128,128 before brightness, floored the same way the Off pixel is so a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
2026-11-13 Stop the background radar poll from freezing the lamp. (#55)
    The fetch runs even on Fire. It no longer calls the modem every loop, waits until WiFi has been up for 20 seconds, and copies frames into the panel buffer only after the 14-byte head matches Content-Length. The radar URL is fixed, and the GitHub TLS read waits long enough for the ESP32 to finish the AT command.
    [MatrixLamp_R4_Wifi.ino, lamp_ota.h, radar_client.h]
2026-11-14 Bound WiFiS3 reads and stop the default radar poll. (#56)
    WiFiClient::read() asks the ESP32 for up to 1023 bytes. That overflows the
    512-byte Serial2 ring, so the sized AT parser never returns after available()
    reports a full radar response. Radar, the web server, and GitHub TLS now
    issue a 64-byte receive. The background poll runs only for the radar preset
    or an explicit auto-radar toggle.
    [MatrixLamp_R4_Wifi.ino, at_read.h, lamp_creds.h, lamp_ota.h, radar_client.h]
2026-11-14 Replace InternalStorage OTA with Arduino OTAUpdate (#58)
    * Replace InternalStorage OTA with the core OTAUpdate library.
    GitHub releases now ship an Uno R4 WiFi .ota image. Install update checks the release version and, when it is newer, downloads that file through the bridge without blocking the presets.
    * Run the firmware build on pull requests without publishing a release.
    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
    [MatrixLamp_R4_Wifi.ino, lamp_ota.h, ota_ca.h, radar_client.h]
2026-11-14 Stop radar mode from hanging the MCU with no RAM left. (#59)
    Radar frames now share the other presets' scratch RAM, and the fetch reuses the page's WiFi client instead of allocating a second 1024-byte buffer. A watchdog reboots if the main loop stays stuck.
    [MatrixLamp_R4_Wifi.ino, lamp_core.cpp, lamp_core.h, matrix_modes.h, mode_ram.h, radar_client.h]
2026-11-14 Smooth Matrix Rain and fix the OTA manifest read (#60)
    * Smooth Matrix Rain and mark the firmware r2 for OTA.
    Drops move by a fraction of a pixel each show instead of hopping whole pixels on a shared tick. The release version ends in -r2 so it does not match the build already on the lamp.
    * Read the GitHub manifest into the page buffer.
    The live manifest is 512 bytes. The 480-byte buffer rejected that Content-Length before the body was read, which showed up as "github read failed" after the release-assets connect. The body now uses the existing 1280-byte buffer, failures log the status line and counts, and the published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
    [MatrixLamp_R4_Wifi.ino, lamp_core.cpp, lamp_ota.h, matrix_modes.h, ver_cmp.h]
2026-11-14 Send the OTA URL past the 128-byte modem buffer, and mirror radar east-west. (#61)
    OTAUpdate: :startDownload formats AT+OTADOWNLOADSTART into a 128-byte buffer, so a 933-byte release URL comes back as modem error -26. The sketch writes that line to Serial2 itself. Radar samples file column 15-x so west is on the viewer's left.
    [MatrixLamp_R4_Wifi.ino, lamp_ota.h, matrix_modes.h, radar_format.h]
